retro16/acsi2stm/pcb/Compact/README.md

ACSI2STM PCB
============

Documentation about how to build and use is located in the doc directory.
