retro16/acsi2stm/pcb/Compact/3D view - ACSI2STM Compact.png

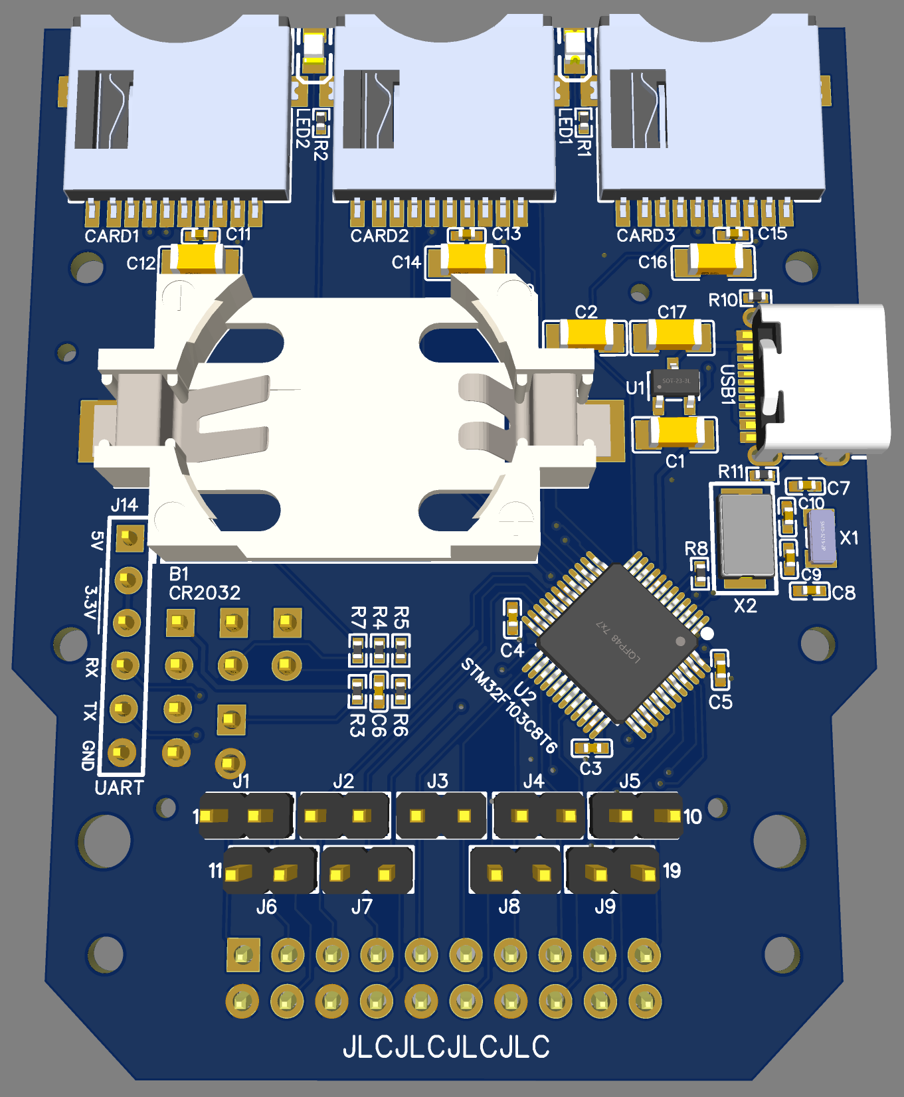
pcb/Compact/3D view - ACSI2STM Compact.png
