retro16/acsi2stm/pcb/Compact/BOM - ACSI2STM Compact.csv

ID | Name | Designator | Footprint | Quantity | Manufacturer Part | Manufacturer | Supplier | Supplier Part | Price
1 | 32.768kHz | X1 | FC-135R_L3.2-W1.5 | 1 | Q13FC1350000400 | EPSON(爱普生) | LCSC | C32346 | 0.204
2 | 100uF | C16,C12,C1,C2,C14,C17 | C1206 | 6 | CL31A107MQHNNNE | SAMSUNG(三星) | LCSC | C15008 | 0.062
3 | 100nF | C15,C11,C6,C3,C4,C13,C5 | C0402 | 7 | CL05B104KO5NNNC | SAMSUNG(三星) | LCSC | C1525 | 0.001
4 | TF-013 | CARD1,CARD2,CARD3 | TF-SMD_TF-013 | 3 | TF-013 | HANBO(汉博) | LCSC | C961683 | 0.091
5 | 22pF | C7,C8,C9,C10 | C0402 | 4 | 0402CG220J500NT | FH(风华) | LCSC | C1555 | 0.001
6 | FC-2012HRK-620D | LED1 | LED0805-RD_RED | 1 | NCD0805R1 | 国星光电 | LCSC | C84256 | 0.011
7 | 17-21SUYC/TR8 | LED2 | LED0805-R-RD | 1 | KT-0805黄灯 | KENTO | LCSC | C2296
8 | CR2032 | B1 | BAT-TH_CR2032-BS-6-1 | 1 | CR2032-BS-6-1 | Q&J | LCSC | C70377 | 0.158
9 | HDR-M-2.54_1x2 | J1,J2,J3,J4,J5,J6,J7,J8,J9 | HDR-M-2.54_1X2 | 9 |  |  | LCSC | C124375 | 0.022
10 | RESET | J10 | HDR-M-2.54_1X2 | 1 |  |  | LCSC | C124375 | 0.022
11 | FLASH | J11 | HDR-M-2.54_1X2 | 1 |  |  | LCSC | C124375 | 0.022
12 | ID_SHIFT | J12 | HDR-M-2.54_1X4 | 1 |  |  | LCSC | C124378 | 0.04
13 | STRICT | J13 | HDR-M-2.54_1X2 | 1 |  |  | LCSC | C124375 | 0.022
14 | UART | J14 | HDR-F-2.54_1X6 | 1 |  |  | LCSC | C40877 | 0.071
15 | HDR-IDC-2.54-2X10P | P1 | IDC-TH_20P-P2.54-V-R2-C10-S2.54 | 1 | 2.54-2*10P简牛 | BOOMELE(博穆精密) | LCSC | C3405 | 0.114
16 | 1kΩ | R1,R2,R4,R5,R7 | R0402 | 5 | 0402WGF1001TCE | UNI-ROYAL(厚声) | LCSC | C11702 | 0.001
17 | 100kΩ | R3,R6,R9 | R0402 | 3 | 0402WGF1003TCE | UNI-ROYAL(厚声) | LCSC | C25741 | 0.001
18 | 1MΩ | R8 | R0402 | 1 | 0402WGF1004TCE | UNI-ROYAL(厚声) | LCSC | C26083 | 0.001
19 | 5.1kΩ | R10,R11 | R0402 | 2 | 0402WGF5101TCE | UNI-ROYAL(厚声) | LCSC | C25905 | 0.001
20 | XC6206P332MR | U1 | SOT-23-3_L2.9-W1.6-P1.90-LS2.8-BR | 1 | XC6206P332MR | TOREX(特瑞仕) | LCSC | C5446 | 0.107
21 | STM32F103C8T6 | U2 | LQFP-48_L7.0-W7.0-P0.50-LS9.0-BL | 1 | STM32F103C8T6 | ST(意法半导体) | null
22 | USB-TYPE-C-018 | USB1 | USB-C_SMD-TYPE-C-31-M-12 | 1 | USB-TYPE-C-018 | DEALON(德艺隆) | LCSC | C2927038 | 0.052
23 | 8MHz | X2 | CRYSTAL-SMD_L5.0-W3.2 | 1 | X50328MSB2GI | YXC(扬兴晶振) | LCSC | C115962 | 0.174
