retro16/acsi2stm/(threads)

Thread 1 (2020-04-05):

Why no DMA?

TzOk83, 2020-04-05:
Great work, but it is really worth to leave Arduino behind, and use a full potential of STM32 with the use of the DMA support it has.

Closed 2021-01-31.

Thread 2 (2021-01-30):

Build issues

MrSVCD, 2021-01-30:
I just downloaded arduino and what i could find of stm32duino, this to be precise: https://github.com/stm32duino/Arduino_Core_STM32, and I can't compile it.
It complains that it can't find libmaple_types so I think I am missing something.
How do I fix this?

retro16, 2021-01-31:
Hi, It seems that the STM32 library changed lately.
Can you try installing the Roger Clark Melbourne version of the STM32 library, it seems to solve the compilation issue.
The steps are available here: https://github.com/rogerclarkmelbourne/Arduino_STM32/wiki/Installation

Closed 2021-04-23.

Thread 3 (2021-02-06):

Device detection fails. Boot fails as well.

grzybsonssg, 2021-02-06:
I am trying to build acsi2stm and I am having hard time.

Symptoms:
* I etched SD card image with ICD Pro from Jookie - it does not boot.
Source: http://atari.8bitchip.info/DiskImgPP1.html
* I etched SD 1GB card image from Pera Putnik - it does not boot.
Source: http://joo.kie.sk/?page_id=332
* I booted from floppy with ICD Pro, then run IDCHECK.PRG - device is detected about once in around 20 tries

Some details:
* On serial output, when booting I can see something like below and nothing happens.
```
-----------------------
ACSI2STM SD bridge v1.1
-----------------------

Initializing ACSI bus ...
ACSI bus ready
Initializing SD card 0
Size: 7388MB - 15130624 blocks
SD card is bootable
1 SD cards found

--- Ready to go ---

Command  8 0 0 0 1 0
Send:512 bytes
Success
```
* This is output when running IDCHECK.PRG. However the device stays undetected.
```

-----------------------
ACSI2STM SD bridge v1.1
-----------------------

Initializing ACSI bus ...
ACSI bus ready
Initializing SD card 0
Cannot init SD card
0 SD cards found

--- Ready to go ---
Initializing SD card 0
Size: 7388MB - 15130624 blocks
Command  3 0 0 0 12 0
Initializing SD card 0
Size: 7388MB - 15130624 blocks
Send: 70 0 0 0 0 0 0 E 0 0 0 0 0 0 0 0 0 0
Success
Command  12 0 0 0 24 0
Initializing SD card 0
Size: 7388MB - 15130624 blocks
SD 0 ID ='ACSI2STM SD 0 7388 MB   v1.1'
Send: 0 0 1 0 1F 0 0 0 41 43 53 49 32 53 54 4D 20 53 44 20 30 20 37 33 38 38 20 4D 42 20 20 20 76 31 2E 31
Success
Command  12 0 0 0 0 80
Initializing SD card 0
Size: 7388MB - 15130624 blocks
SD 0 ID ='ACSI2STM SD 0 7388 MB   v1.1'
Send:
Success
```
* I used some cheap blue pill and micro sd module (with buffered) lines. I suspect that STM32 might be a fake, because of markings. Please look at the F letter on photo, it should be on next line:
https://a.allegroimg.com/s720/118a5c/e51e5c7a499b809e3ae4c8f7aa82/Modul-STM32F103C8T6-Board-STM32-ARM
* Wires are max 7 cm
* I did a little shortcut - instead of connecting 7 unused CS pins (PA3-PA1,PB0-1, PB3-4) to ground, I just removed them from sdCs array - does it pose a problem?
* I tried STM32 Arduino libs from Dan drown (https://github.com/ddrown/Arduino_STM32/)
as well as from Roger Clark (https://github.com/rogerclarkmelbourne/Arduino_STM32)
* I tried two different USB chargers to power the device.
* I have only one micro SD card.
* I have 1040STe, 4MB RAM, TOS 1.62DE, DMA chip C38739-001A (the so-called better one).

I am starting to believe that I have a fake chip. Maybe there are slightly different timings on GPIO and device goes out of sync?

Maybe do you have any ideas what to do next?
Maybe try to get different blue pill?

retro16, 2021-02-07:
Thanks for the very detailed issue, that helps a lot !

First things first, here is a list of things I consider good from what you said:

 * Your electronics are good because many commands were exchanged in the IDCHECK.PRG trace, so there is some form of communication.
 * Altering the sdCs array is a good solution to avoid grounding pins. The code adapts itself automatically to that situation.
 * The DMA chip of the ST is never an issue for reading.
 * My main machine was also a 1040STe with the same configuration (I don't have it right now to test).
 * My STM32 also has the F letter misplaced, so if you have a fake chip, so do I.

Things I'm unsure about:

 * The IDCHECK.PRG trace says "0 SD cards found". The SD card is detected later. It shouldn't be a problem because the card is initialized again for most commands anyway.
 * I heavily recommend the Roger Clark Arduino library, but my code was done a while ago with a different library, and I don't remember which one it was. That may have an impact on the time critical parts (more on that later).

Things I'm pretty sure don't work:

 * Data transfers (DMA) are probably the problem because commands work.
 * The timing-sensitive functions of my code are probably not working on your configuration. That's an issue some other people already had.

That would explain exactly the traces I see and also the detection issue you have.

DMA transfers are too fast to be cleanly implement on the STM32, so I use fixed delays. It worked on all my machines (and it worked for other people too), but it seems to be hit or miss.

Could you try experimenting with the pulseDrqSend function ? The aim is to find the correct number of lines (between line 230 and 236 in the last version) to have the correct DRQ pulse timing. Some had more success by removing 3 or 4 lines, but you may have to add 3 or 4 lines.

The best way to test is to try booting the ST: if you have more than one command on the trace, it means that reading from the SD card is working to some extent.

If you need to test your image, I recommend you test on the Hatari emulator because my code follows its implementation so the behavior should be the same.

retro16, 2021-02-07:
I did some checks on an up to date Roger Clark environment. It seems that the optimization level has an impact. Can you try with Tools/Optimize: Fastest (-O3) ?

grzybsonssg, 2021-02-07:
Hi! I switched the optimization level to: Fastet (O3). Results are at least interesting.

At first - nothing changed. I did some testing and after around 15 minutes of meddling - it booted!
I run some games, even copied some files from floppies. Unfortunately - it worked only for like a 30 minutes. When I turned everything off  to copy some stuff from PC, and then on - it failed to boot again (with messages still logged on serial).

During a day I managed to get it working only once :(

I think I'll try shortening wires a little (now 7cm). I have also borrowed another blue pill from a friend.

grzybsonssg, 2021-02-08:
I have another observation from today!

Just by accident I powered the ACSI2STM from laptops USB (instead of charger). Guess what - it booted! And it booted every time I have tried! But not with phone chargers.....

During tests:
* some games from P.Putniks free image run flawlessly
* We were at demo HDD version crashed randomly during loading (screen turning to blue)
* Flipo demo HDD refused to load.
* Bad apple by fenarinasra crashed stopped at loading screen at random moments.

In following days I'll try to experiment with pulseDrqSend as you suggest.

retro16, 2021-02-09:
That's nice progress, thanks for the feedback !
You probably have some electrical noise issues. Phone chargers often generate more noise than a PC and this kind of noise is difficult to filter. Reducing wire length and adding a decoupling capacitor (a big ceramic cap, something like 10uF) between 5V and GND might help.
pulseDrqSend adjustments may also improve things if the data signal is removed too early by the STM32. In that case, try to add a few lines. It's all guesswork.
Ideally, you would need to probe the DRQ and ACK signals with a logic probe or a digital oscilloscope during a big faulty transfer: the correct signal is DRQ rising right after ACK is pulled low by the ST, the sooner the better. If DRQ goes up before ACK goes down, pulseDrqSend is too fast and it may remove the data byte before the ST read it.

grzybsonssg, 2021-02-10:
Hi,

I looked carefully at the bottom of the blue pill, and there are already to capacitors between 5V and GND - on mine boars labelled C5 and C7. Unfortunately, there is no label on them, parameters are unknown. According to some sources on web those might already be 100n and 10u :/
I wonder how much current the acsi2stm draws...

However I have a major breakthrough :)
* I switched optimization level back to "Smallest"
* Added three lines inside pulseDrqSend
* Disabled all the serial logging (important!)
Right now "Bad apple" runs smoothly from the beginning to end :) There is no sound though.  I might have STE DAC broken or something in-between, because I already experienced it with ProTracker or game "Stardust".

Demo "We were at" is causing problems. It loads and runs until certain point. It crashes before image screen with girl and her hair waving. FDD version loads some additional data at that moment. What's interesting is that Hatari emulator fails as well, but due to some reports - Ultrasatan does not. I'll try to contact Leonard/Oxygene for that.

grzybsonssg, 2021-02-11:
Hi! I heard that someone at atari-forum is trying to exact-cycle Drq pulses using machine code's NOP instructions. What  do you think?

retro16, 2021-04-23:
Hi, If you still have issues, I recommend that you upgrade to the 2.0 beta I just uploaded. Beware that there are minor pinout differences.

Closed 2021-04-23.

Thread 4 (2021-02-16):

Read issues

Frederick321, 2021-02-16:
Have a nice day!

I built an ACSI2STM; on a soldered breadboard, in order to minimize the tracks lenght.

Following your advices from "Device detection fails. Boot fails as well." issue thread; I managed to enabled correct write operation.

But reading sometimes present problems; I detected this loading some hard disk enabled games; once the full coloured splash screen of a game presented several garbage pixel lines.

On a major testing, it appears that large files (greater than 1 MB) can be loaded with more succesful results than load many small files reaching the same amount of data.

It can be something related to disk access time? Or something related to the explanation about "If DRQ goes up before ACK goes down, pulseDrqSend is too fast..."

Machine is a STE with TOS 1.06, and "Good DMA chip"

retro16, 2021-02-23:
Hi, some people (including myself) have timing problems because of a change in behavior in the STM32 library. I am aware of these issues, probably related to the pulseDrq functions. This needs fine tuning, some people already help me finding the correct timing.
That timing issue is there because the STM32 is not fast enough to react to the ACK pulse so it has to do guesswork with a timer,  which introduces these problems if the delay is not perfect. Hopefully this will be solved quickly.
Can you list the name of the games with problems so I can try to reproduce the issue ?

Thank you for your feedback.

retro16, 2021-04-23:
Hi, If you still have issues, I recommend that you upgrade to the 2.0 beta I just uploaded. Beware that there are minor pinout differences.

Closed 2021-04-23.

Thread 5 (2021-02-17):

High current draw

TzOk83, 2021-02-17:
I've encountered a problem - after shorting unused CS pins to GND the MCU overheats. I've checked, and PA1..4 and PB0..1 seem to be configured as output and set high, so shorting them to GND results in excessive current draw (50mA per pin).

retro16, 2021-02-23:
Thanks for the feedback.
I reviewed my code and your result is a bit strange. Based on my code, these pins should stay in the INPUT_PULLUP state.
In the meantime, you can remove the pins you don't use from the sdCs array in the code and leave them open.

retro16, 2021-04-23:
Hi, If you still have issues, I recommend that you upgrade to the 2.0 beta I just uploaded. Beware that there are minor pinout differences. Now, unused CS pins are not grounded anymore, which should solve your issue.

Closed 2021-04-23.

Thread 6 (2021-03-25):

Debug Printout?

Ulises74, 2021-03-25:
Hi @retro16,
First of all, GREAT JOB! UFF WAO, I am getting my feet wet and I am overwhelmed.
Can you post a debug printout of a successful SD card install?
In my case ICD ID detect and ICD Install fail to recognize anything in the bus. I realized ICD was sending a VERIFY(6), to which I modified the code to respond with a command Success. The ACSI2STM was recognized as ADAPTEC 5500, but would fail to install: "Unable to determine drive size". In the debug, I realized a command Test Drive Ready is sent with 0x20 in the 2nd byte, to which the program errors out. I am about to add a correction to this, but I believe I might be going down a rabbit hole.
Can you post a successful DEBUG session.
What is it recognized as by ICD?
Thanks
TOS 1.06 1040STE
ICD Install v1.13

Ulises74, 2021-04-02:
Hi, I finally made it work! I'd like to share my experience here in case it helps anyone else. Trying to keep it short.
Things I learned:
1- This works, no need to mess with the software, except the pulses.
2- Pick a good strategy for assembly.
3- Triple check connections.
4- Run various tests, have patience.
What I recommend:
1- Do not use lead free solder, just use normal lead solder - lower temp, smaller blobs, easier.
2- Do not use protoboard, go straight for pcb prototypying, too many connections can go loose.
3- 8 bit lines plus 4 control lines, 12 total. Each point of solder multiplies, I had 4 stages, 12x4=48, plus SD, etc, you get the point.
4- triple check connections between points. I checked connections, then cleaned the flux with a toothbrush, which moved a wire without me noticing= 1 week lost.
5- Use a good known power supply, add a capacitor to your board at power entry, 10 or more uF. Tantalum or SMD's are better than electrolytics, but the latter will work as well.
6- There is a typo on the STM Serial port to be used. PA9 is to be connected to the USB Serial bridge RX port (not PA11 as in the original instructions). PA10 is correct.
Tips:
Whether the ACSI2SD works or not depends on the timings for read and write in the DMA port. These are affected by the number of pulses in the pulseDrqSend and pulseDrqRead functions as well as the compile options.
Sequence-
1-Pick a compile option (default, O1, O2, O3)
2- change the pulses in the pulseDrqSend. Start by going down; but you could go up as well. Stick with one.
3- check that device is "read". ICD IDcheck will check device names by performing a read in the DMA.  Name should be 'ACSI2STM SD 0 1938 MB   v1.1' for example. You can reprogram the device while IDCheck is waiting for input.
2- If not read, change pulse durations. If sometimes it reads, and sometimes it doesn't or shows garbage, you still need to change pulse duration, but probably by one or two pulses.
3- If Pulse durations don't make the device be read, then change the Optimization. and repeat from step 1.
4 - Once you have stable detection of IDCheck you can start with format ICDFMT.
5- Go over the Format, then Partition. This reads data from the disk and writes data to the disk, but it does not confirm that data was written correctly. At this point you can start the calibration process with the pulseDrqRead; same steps as before, except this time, you will use the formatting/partitioning sequence.
6- You will have calibrated the pulseDrqRead function correctly, if when ICDFMT exits, it reboots the computer. ICDFMT during the partitioning process, will make the drive bootable and install a driver. So when it exits, it will try to read this back and reboot. If it doesn't reboot, it didn't work. If it reboots, you might just be near the sweet spot. If the ST booted to your C drive on screen, try creating folders and copying files, try reading/executing them. If you encounter errors, keep tweaking the pulses until you no errors are seen.
7- At this point you should have a working drive.

Notes:
- The watchdog timer lets you know something is wrong. If in the debug screen you see the welcome screen popping up a lot, means you have problems. At first, I had a lot of them going on. They went away when I added the power supply capacitor. Then I had some left during read/writes because I had changed the read/write subroutines. It meant, the sequencing wasn't done correctly and the STM was left waiting and after a while the watchdog timer rebooted the STM.
- I also noticed that seems like the DMA chip can tell if the hardware handshake is way out/not done in sequence, only for DMA writes to the drive. It will display "write error" during the partition creation or if you do a surface scan.
- Leaving the Debug on was crucial for me to learn/understand but you may not needed it if the above steps work. If you can tell that commands are received, you know that the soldering worked. Also, having the debug on did not interfere with the drive working, it just increased the access time by a bit. Remember to turn it off when done.
- Once the drive is working, you might be tempted to keep reducing the pulses. Each pulse is about 30ms. In my case, there was a point in which reducing the pulses just created errors. I believe you should do this in order to find the lower limit, and then leave the number of pulses in between the lower and the higher limit. I suspect temperature might affect DMA pulsing.
- Compiling option that worked for me: Fast-O1
- My final numbers: 363KB/s, 2ms. Faster than an original Atari drive, not bad! (on ICDpro RateHd)
- I used a "quality" blue pill ($7), like the one in Retro16 pics. I will try on cheap blue pills ($2).

ToDo:
- I like it, I think I'll make a PCB, I have 2 Atari's, and it would suck to proto build these.
- I suspect the STM Roger Clark library is creating bloated assembly - SD runs at 25MHz so we should get faster speeds. In fact, I did away with the while(!ACK) wait in the pulse functions and it doesn't change the speed or the functioning. So I might dive into that - add inline assembly for port writing and reading.
- Enjoy it. I need to find ways to use the drive for gaming or programming or whatever.

Thanks Retro16!

Some Debug printouts:

-----------------------
ACSI2STM SD bridge v1.1
-----------------------

Initializing ACSI bus ...
ACSI bus ready
Initializing SD card 0
Size: 1938MB - 3970048 blocks
1 SD cards found

--- Ready to go ---
ICD recognized and showed device
IDCHECK
Command  3 0 0 0 12 0
Initializing SD card 0
Size: 1938MB - 3970048 blocks
Send: 70 0 0 0 0 0 0 E 0 0 0 0 0 0 0 0 0 0
Success
Command  12 0 0 0 24 0
Initializing SD card 0
Size: 1938MB - 3970048 blocks
SD 0 ID ='ACSI2STM SD 0 1938 MB   v1.1'
Send: 0 0 1 0 1F 0 0 0 41 43 53 49 32 53 54 4D 20 53 44 20 30 20 31 39 33 38 20 4D 42 20 20 20 76 31 2E 31
Success
ID Shown!

ICDFMT

Command  12 0 0 0 24 0
Initializing SD card 0
Size: 1938MB - 3970048 blocks
SD 0 ID ='ACSI2STM SD 0 1938 MB   v1.1'
Send: 0 0 1 0 1F 0 0 0 41 43 53 49 32 53 54 4D 20 53 44 20 30 20 31 39 33 38 20 4D 42 20 20 20 76 31 2E 31
Success
Command  0 0 0 0 0 0
Initializing SD card 0
Size: 1938MB - 3970048 blocks
Success

Detected!

retro16, 2021-04-23:
Hi, If you still have issues, I recommend that you upgrade to the 2.0 beta I just uploaded. Beware that there are minor pinout differences. It should solve any timing issues as it now uses STM32 timers and DMA for much safer operation.
Thank you for the very detailed feedback that helped me a lot finalizing this v2.0.

Closed 2021-04-23.

Thread 7 (2021-05-07):

Unstable work on unbuffered ACSI port (e.g. STf).

TzOk83, 2021-05-07:
I can't get it to work on Atari STfm, on STe it works flawlessly and very fast (~1MB/s). I think it can be caused, by the fact, that STf doesn't have any buffers between DMA chip and ACSI port, while STe - has. If I load the driver from the disk, I can browse the card on the STf, but writing to it, corrupts it completely. I'm using P. Putnik's driver.

P.S.
For some reason, if I upload the program to the BluePill from Arduino IDE via the STLink, it doesn't work (but reacts on ACSI activity), while when I upload it via the Serial it works. It also works if I export the binary file from Arduino IDE and upload it to the BluePill via the STLink, with the STM32 Cube.

retro16, 2021-05-08:
Thansk for the detailled feedback.

I usually work on a STE, but testing on a 520STF shows indeed signs of data corruption. Strangely, it's not 100% corrupt, its mostly right: I could copy a PRG, reset, and run it successfully, but the file system quickly degrades (I'm using ICD). In my case that probably could be worked around using a driver that does verify and retries.

The electrical compatibility issue is a serious lead, I wasn't aware of these hardware differences. Having an oscilloscope of D0 and ACK during a write operation would help. I'm working on soomething else right now but I'll try doing it in a near future.

I have STLink issues too. STLink issues may be because of direct port access for GPIO or systick disabling (not sure). I do push the STM to its limits with that version. I don't really care, I use serial anyway.

retro16, 2021-05-08:
Just an idea that came across my mind: maybe the DMA data lines are slow on the STfm, so I did a testing branch "dmadelay" that delays sampling. I doubt it changes anything, but if you could test it, that would be appreciated.

By the way, there are known issues on some STf with writing, and it seems that these aren't able to write anything tio their DMA/ACSI port. Do you have any way to check that there are actually some signals on D0-D7 during a write operation ? (oscilloscope, logic analyzer ...)

TzOk83, 2021-05-08:
I can check signals on the bus, but UltraSatan works fine, on that machine.

retro16, 2021-05-08:
Ok if UltraSatan works, no need to check the signals, the issue is on the STM side. I was able to reproduce anyway, and it seems my "dmadelay" branch improves things a bit. I might make a DMA test application some day ...

TzOk83, 2021-05-14:
I have tried today and still no luck  with the autoboot, yet writes now work correctly.

I have tried on the same SD card and same ACSI cable as my UltraSatan.

I can copy many MBs of data and everything works stable. The dmadelay version is actually slightly... faster than the current release version (1010 vs 990 kB/s).

mamejay, 2021-09-29:
I have built a unit up and programmed using a STLink and get the same issue as TzOk83.  I get activity LED on the STM but will not detect the card.  My serial adapters have decided they do not want to work.  I have another on order.  Hope this works as I have checked all connection and everything is connected correctly.

VonHirsch, 2021-10-04:
Hello, i'm getting ready to build a unit and came across this thread.  I'd like to use it on a 520STF.  Is it possible that this issue is related to the ["DMA" issue](https://www.exxoshost.co.uk/atari/last/DMAfix/)?

retro16, 2021-10-05:
Things have changed a lot since v2.1. I'm now pretty confident that commands aren't skipped anymore, but reality proves that there are still issues for some people that I can't reproduce.
If issues still arise, traces of the following signals during a failed write operation would be greatly appreciated (a few periods should be enough):

* DRQ (ACSI pin 19)
* ACK (ACSI pin 14)
* D0 (ACSI pin 1)

And another trace with the following pins captured during a write command (one A1 pulse and a few CS/IRQ pulses is enough):

* IRQ (ACSI pin 10)
* CS (ACSI pin 9)
* A1 (ACSI pin 16)

Pins are listed in order of importance, if your oscilloscope/logic analyzer doesn't have enough inputs, just take the top of the list.

luciust, 2021-10-05:
Well I got Two STF and and 4 STEs.
The <2.1 version was corrupting data but working on STE with older DMA. The 2.1 doesn't - Putnik or ICD - they can't even read the filesystem. STE has pullups on DMA bus.

I need to check on STFs and one STE with newer (001) DMA I got. One of them (strangely not the one with 001 DMA) works fine with CosmosEX and the STF works with aftermarket SCSI - ACSI HDD from the era.

So - need to test and get back here! Got a scope and logic analyzer at disposal

luciust, 2021-10-06:
OK, So far:
- STE, old DMA, pullups, TOS 2.06 - no go
- STE, new DMA, no pullups, TOS 1.62 - no go
- STF, old DMA, pullups, TOS 1.04 - no go

The effect is the same - Putnik's partiition program takes  2 mins to find the "HDD" and either shows 0MB or 128MB.

Double checking the connections and the plan is to attach console and turn on debug.

TzOk83, 2022-01-01:
I may confirm the same - v2.1 doesn't work for me at all. On my STE v2.0, and v2.0 "dmadelay" were working, including autoboot feature (but only on STE).

Are you aware of the fact, that the Data Request (19) signal timing given in the official documentation is apparently wrong?

retro16, 2022-03-01:
Version 2.2 leaves data on the bus after the ACK rises for a small amount of time. The ACSI doc specifies a minimum of 20ns so I removed code inlining and added a single NOP to make sure that this requirement is exceeded. This is very similar to what "dmadelay" did but in a cleaner way.

ACSI_FAST_DMA define restores the faster inline code of version 2.1 if set to 1.

Now, trying different combinations of ACSI_ACK_FILTER, ACSI_CS_FILTER and ACSI_FAST_DMA should allow adjusting to any reasonable delay required by different versions of the DMA chip. As a general rule of thumb, slower should mean more compatible.

z80micro-mc, 2022-03-09:
I am in the process of building an ACSI2STM for my STs 520STM & 520STFM and have observed that most of the designs would appear to use an Arduino micro SD adapter.  As far as I can ascertain the vast majority of these are designed for 5V TTL operation and include both 5->3v3 regulators and 3v <-> 5V buffers.  The ACSI design would appear to use the TTL compatible interfaces on the ACSI side However, the micro SD side pins are not TTL compatible.  Ihave not not seen articles on removing the 5v-> 3v3 regulator and feeding in 3v3  from the STM nor of removing the LVC125 level converters and ffeding directly into th eSTM from the SD card. Could this be adding to the corruption?

Peter

retro16, 2022-03-20:
@z80micro-mc you probably found a very important issue. My prototype uses microSD->SD converters as SD slots, so no electronics (except a 100nF SMD decoupling capacitor, very important). I previously had issues, but simply because the converter was faulty (these things tend to wear). Soldering a new converter, I have no issue at all.
I can push any card (from old no-name 2GB to brand new SanDisk) to 36MHz on a hand-soldered prototype with 3cm wires and header pins. With the newer, much more stable, version 2.3c I just released, compatibility issues will probably be a thing of the past.

TzOk83, 2022-03-21:
2.31 still doesn't want to autoboot on my STfm (TOS 1.04), while it works fine with my STe (TOS 2.06 and 1.62).

retro16, 2022-03-21:
Thanks @TzOk83  for the quick feedback, it really helps.

Can you try with the following settings in acsi2stm.h ?

#define ACSI_ACK_FILTER 2
#define ACSI_CS_FILTER 2
#define ACSI_FAST_DMA 0

ACSI_FAST_DMA 0 brings back the workaround of the old dmadelay branch. Combined with ACK_FILTER to the maximum, this will add a lot of delay to the DMA transfer, which should help mitigating the lack of buffers and the fact that the STM32 outputs 3.3V instead of 5V. I am probably missing an important detail, but without a problematic machine at hand, it's difficult to pinpoint the issue.

If nothing works, it probably would require driving the bus with pull-ups and tristate to reach 5V on data signals, which changes the logic a lot and will make transfers super slow. Not sure if it's worth it.

TzOk83, 2022-03-22:
I think this may be important - the "dummy bootsector" message shows on the STfm, despite it has an autoboot enabled SD card. If I load ICD driver from the floppy disk it works.

retro16, 2022-03-22:
Super cool, thanks a lot for your help and your patience for helping solving this issue. It's strange that you had the dummy bootsector message working but not ICD. Maybe it's because of the size of the binary.

Anyway, I will set ACSI_ACK_FILTER to 2 by default from now on, the aim is to have a conservative "official" image that trades more compatibility for less speed, and the performance loss of ACK_FILTER to 2 is really minimal. It introduces a lag of about 40ns per byte, which matches more or less what is described in the page you linked a while ago.

Feel free to mark the issue as closed if it is stable for you.

luciust, 2022-03-22:
Wow, so I can get back to soldering! Great news, thanks!

Closed 2022-03-22.

Thread 8 (2021-05-08):

Similar project, share code around image file usage?

mzryz, 2021-05-08:
Hi there,

Sorry if this is a silly question! But there is a SCSI>SD project called BlueSCSI also based on the STM32. Due to the similarities I was thinking this project may benefit from some of their code? For instance, they also support image files but they don't advertise any kind of slowdown in using them. I wonder where the difference is. I guess with the beauty of open source you guys might be interested?

https://github.com/erichelgeson/BlueSCSI

Thanks,

retro16, 2021-05-08:
Hi, this is very good information, thanks for the pointer.
I quickly looked at their code and they only use images and the exact same library, not raw SD card access, the performance they have is somewhat similar to my project when I use images. I bet that they would actually benefit from raw SD card access.

mzryz, 2021-05-08:
Ohhh okay, in that case I might let them know this. (I am a user of both asci2stm & bluescsi) I was just very interested in how both these projects are quite similar.

I will be modifying my asci2stm to v2 tonight and trying the new firmware ;)

erichelgeson, 2021-05-14:
Sorry to come to this late - but i see you're using shared SPI - have you tried dedicated? quite the speed bump if your project can support it.

Closed 2021-05-08.

Thread 9 (2021-05-09):

Advice on re-working to v2?

mzryz, 2021-05-09:
Hi there,

I have a couple of ASCI2STM's that masteries kindly made for me a while back, recently there has been an update to the device that requires some re-working. I haven't done much with SD cards and STM's so the instructions confuse me a little so I'm hoping to get some advice.

 So I can break the traces and patch these quite easily:
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
 Then the SD card info confuses me a lot, could someone help draw on my picture some of the changes I might need?
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

retro16, 2021-05-09:
Hi,
I confirm that the changes on the first picture are correct.
For the SD card, many STM32 pins had to be shorted to GND and now they must be disconnected.

* No change need to be made on the MicroSD adapter
* Since you have only one SD card, pins PA3, PA2, PA1, PB0, PB1 and PB3 of the STM32 are probably connected to GND (I can't see, the traces are either under the STM32 or under the black goo blob). The simplest way is to cut the pins directly on the STM32 itself as they are now completely unused.

mzryz, 2021-09-29:
Just closing the thread as I buggered it all up and my boards went in the bin.

Closed 2021-09-29.

Thread 11 (2021-09-01):

cardSize() is deprecated.

TzOk83, 2021-09-01:
cardSize() method was deprecated in SdFat since few releases, and now it has been finally removed. sectorCount() should be used instead.

The last version of SdFat library compatible with the current code is 2.0.7.

retro16, 2022-03-01:
After a way too long delay, it was changed in the latest release. Closing the issue.
Thanks for the feedback.

Closed 2022-03-01.

Thread 12 (2021-09-30):

Receive bomb images on 8bitchip 1GB image

mamejay, 2021-09-30:
Hello.  I have build a unit and managed to get it visible to the system.  I have tested a ICD unity image and another EMUTOS image and both auto boot fine.
I have a stock 1040 STFM with 1.04 TOS
I am trying to using https://atari.8bitchip.info/DiskImgPP1.html image which seems to be the go to for many people.
I just receive bomb icons on screen after a few seconds of switching on.
If I boot using the EMUTOS sdcard and have the 8bitchip image in sdcard slot 2 I can see all the partitions and run games etc.
What could be the reason that I cannot auto boot with this image?

mamejay, 2021-10-01:
Contacted the dev of the image file and found that it was an older image.  Dev provided me a new image that works perfectly.    Closing issue

Closed 2021-10-01.

Thread 13 (2021-10-04):

Wiring Diagram or Schematic?

VonHirsch, 2021-10-04:
Hello, is there a wiring diagram or schematic available for the build?  If not that's fine, I think I can figure out what goes where based on the descriptions, just wondering as it would be helpful.  Thanks for making this possible.

retro16, 2021-10-05:
Hello, there is currently no schematic for the build. Building the unit is essentially connecting pins described in the pinout tables of the "Building the ACSI cable" and "Connecting the SD cards" sections of the README and providing 5V to the STM32.

I believe that a schematic would look like a mess of confusing wires but if anyone feels otherwise and posts a schematic here I'll be happy to reference it in the official documentation with proper credits.

mlorenzati, 2021-11-30:
I can create a with the schematic, the PCB has I made has no sense since is for prototype pcb
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

retro16, 2022-06-28:
Version 3.00 now comes with an official schematic, PCB and Gerber. Thanks @mlorenzati as your schematic style helped me choose the clearest style for a schematic (mostly labels, just like what you did here). Closing this issue.

Closed 2022-06-28.

Thread 14 (2021-11-03):

External LED PC13?

mamejay, 2021-11-03:
I have made up a board and connected a LED to PC13.
It is working but I find that it is on all the time and then flashes during disk activity.
I am using a regular blue pill board.  Looks like its inverted with the activity light on the Blue Pill.  I suspect its something simple.
Thanks

retro16, 2021-11-03:
Hi,
The internal LED of the blue pill is inverted, so you will have to do the same.
To connect your external LED, connect the anode to VCC and the cathode to PC13. Don't forget to add a resistor in series (at least 1k because the STM32 can't output much current).

mamejay, 2021-11-03:
Thanks for that.  I worked it out.  Unfortunately I made up a few PCB's so no clean way to fix this.  Anyway lesson learnt - always prototype your boards.

retro16, 2021-11-03:
You can still pretend it's a combined power+activity LED to turn it into a feature ;-)
Wish you the best with your project
I'm closing the issue if you don't mind.

Closed 2021-11-03.

Thread 15 (2021-11-12):

CH32F103 - Anyone managed to get this working on this board?

mamejay, 2021-11-12:
I was sent CH32F103 boards instead of blue pills.
They program up the same but I cannot get them to work.  My ST just boots straight to the OS very fast but does not load from my SDCard.
Has anyone managed to get these working?

juancrix, 2021-11-15:
I received some boards with the same CH32F103. To program them I used their app (WCHISPTool) and the lower USB plug of the board. At least they worked with the old firmware with my v1 custom pcb.
I haven't been able to test the CH32F103 with the lastest firmware and my v2 custom pcb, because I have not been abble to get an error free compilation, probably due to problems with my PC; if you don´t mind to share your compilation, I can test it with my configuration.

mamejay, 2021-11-15:
[acsi2stm.ino.generic_stm32f103c_WORKING.bin.zip](https://github.com/retro16/acsi2stm/files/7535527/acsi2stm.ino.generic_stm32f103c_WORKING.bin.zip)
Thanks for the comment.  Attached is my working compile that I made that works on original STM32F103C boards.  Let me know how you go.  Thanks!

juancrix, 2021-11-16:
My result with the CH32F103: it goes straight (and very fast too) to the desktop showing no icons (neither drive A nor drive B, nor trash icon). Just to confirm, can you tell me for how many sd cards is your compilation? and if there is any changes to the base firmware?

mamejay, 2021-11-16:
@juancrix I only use a single SDcard which I created from an image I got from patari.
I get the exact same results where is loads into the desktop fast.
As for the firmware no changes have been made at all.  Just compiled and uploaded to the CH32F103

luciust, 2022-04-03:
@mamejay Which version is your compile based on? It seems to work on my STM32 (supposedly an original) but it mostly discovers as 7xADAPTEC... can you share your compiled binary of 2.40? The released/compiled versions do not seem to even start on my STM32 chip :(

mamejay, 2022-04-03:
> @mamejay Which version is your compile based on? It seems to work on my STM32 (supposedly an original) but it mostly discovers as 7xADAPTEC... can you share your compiled binary of 2.40? The released/compiled versions do not seem to even start on my STM32 chip :(

@luciust I only have the older compiled bin file 2.1 file.  I need to try 2.4 out and see if I can get these many many clones I have here collecting dust.  Here is 2.1 which works on my real Bluepills.
[acsi2stm.ino.generic_stm32f103c_WORKING.bin.zip](https://github.com/retro16/acsi2stm/files/8405631/acsi2stm.ino.generic_stm32f103c_WORKING.bin.zip)

luciust, 2022-04-03:
@mamejay - Yup this is the one which shows up as 5 devices and ADAPTEC with mine. But at least it starts on mine. Well need to desolder two other bluepils and try again on fresh PCB...

retro16, 2022-04-04:
Hi, if any of you can manage to make 2.40 at least boot on CH32 or other clones, I would be very interested in your setup details to investigate why the release binary doesn't work on these.
Also, I wanted to suggest acsitest.tos (found in the release zip package, *tos* subfolder) that can help diagnosing 2.40 boards, in combination with your usual tools. In ACSI_DEBUG/ACSI_VERBOSE modes, the STM32 even outputs faulty bytes for DMA transfers. I might recognize some patterns I saw when doing DMA improvements/fixes for 2.3/2.4.

luciust, 2022-04-04:
@retro16
I'm pretty sure I got a clone, since my second blue pill is from better source and has correct markings. I'm about to solder the gerber that has been forked from your repo - I hope the pin changes on 2.40 are not making this a problem.

Also dealing with issue that only -O2 option allows the 2.4 to compile, any other setting results with error. Latest STM32, Arduino 1.8.15 - on Linux... But that's another topic :)

mamejay, 2022-04-04:
@retro16 I tried many times to use the new code with a CH32 board but still get the desktop loading instantly.  WIth the ACSITEST.TOS is this a TOS replacement that needs to be burnt to an eprom?

@luciust here is the 2.40 bin file that I managed to compile and get working on my "real" bluepill.  See if this is better than the last binary I sent
[acsi2stm.ino.generic_stm32f103c_2.40_WORKING.bin.zip](https://github.com/retro16/acsi2stm/files/8409128/acsi2stm.ino.generic_stm32f103c_2.40_WORKING.bin.zip)

retro16, 2022-04-04:
@mamejay ACSITEST.TOS is an Atari ST program. Just run it from the GEM desktop. You can load it by any method (working acsi2stm, floppy, ultrasatan, ...) it will work the same.
The program supports hot plugging fine, so you can load it using one ACSI device, unplug it and plug the device to test. You can test multiple devices in a row or reflash your acsi2stm firmware and try again by leaving the program running on the ST.
I don't guarantee that you can quit back to GEM cleanly if hot swapping, but who cares ...

luciust, 2022-04-04:
@mamejay Great, will test it with old one and hopefully finish solderiing new one.

luciust, 2022-04-04:
@mamejay - So, no joy, the 2,40 from you also doesn't start on the clone. No green LED, no activity. Also I I compile debug version with serial - not even serial activity.

Soldering the other board then!

retro16, 2023-06-04:
If anyone has success with 4.00 on a CH32 or any other clone, please drop a line !
Thank you for your help, you people really rock.

mamejay, 2023-06-04:
> If anyone has success with 4.00 on a CH32 or any other clone, please drop a line ! Thank you for your help, you people really rock.

I have heaps of them still.  They need to be programmed a strange way so I will see if I can actually get the  code onto one and use my ZIF socket test rig

mamejay, 2023-06-04:
Tried acsi2stm-4.00.ino.bin and also acsi2stm-4.00-strict.ino.bin get the following as soon as I switch on the ST.
Information just flashes vertically down the screen.
If there is anything else you want me to try let me know.
Thanks

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

retro16, 2023-06-12:
Okay, this doesn't look very good. Let's say that these clones are officially not supported.
Leaving the issue opened for reference as it contains useful information. If I ever update the documentation, I may integrate that thread in the troubleshooting section and close this issue.

Thread 16 (2021-12-06):

SPI Bus is too fast

mlorenzati, 2021-12-06:
After checking the proyect I saw random behaviors in the SPI bus, like failing to start the **SdSpiCard** or detecting 0MB of free space.

After toying with the solution, I tested to lower the SPI to 18Mhz and delay a bit prior init.

```
if(!card.begin(SdSpiConfig(csPin, SHARED_SPI, SD_SCK_MHZ(18), &SPI))) {
    resetState();
    return false;
  }
  delay(250);
  blocks = card.cardSize();```

Now it always boot the sd and detects a boot image on it.
Now dealing with a bus collision that stops the stm32

retro16, 2021-12-07:
Thanks a lot for the feedback. I had strange issues too and got around by doing retries, which was obviously the wrong way.
I will set 18MHz by default and add a #define for adventurous people who want 25MHz back.

I'm rather busy on other projects lately so it might take a while to do that as my Atari is not set up anymore.

retro16, 2022-02-27:
Thanks a lot @grzybsonssg for the feedback. If that works for you too and it's stable, please give some feedback and I'll just commit @mlorenzati 's solution and do a new incremental release.

retro16, 2022-03-01:
The patch here looks good so I integrated it in my latest release with a #define for people who want the highest speed possible. Thank you all for the feedback.

Closed 2022-03-01.

Thread 17 (2021-12-07):

Bus arbitration error on ST power up

mlorenzati, 2021-12-07:
I was able to separately test the board, it reads properly the SD card as a boot device and waits for ACSI bus.
But If I connect the device to the db19, if I power the ST, the green led goes down and the USB serial connection is lost with the pc.

Which lines might be colliding?
this is my schematic, which honors the same documentation

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

retro16, 2021-12-07:
Hi Marcelo,

I just had a very quick look at your schematic, it looks very good overall (I trust your pin assignments, I'm sorry I don't have time to double check connections right now, and I'm pretty sure that you double-checked these already).
The only issue I can think of is the USB data lines on PA11/PA12. If you power the STM32 with its onboard USB plug, make sure to use a cable that is not connected to the data lines.

Having the LED turning off after detecting the ACSI bus is good sign, the LED turns on while waiting for the bus, then turns into an activity LED when entering the main loop.

Of course losing the serial connection is not good at all. What happens if you reset the STM32 with the ST already powered on ?

mlorenzati, 2021-12-07:
Oh so you mean that the USB connection is only meant for powering the device?
What about the COM port? When I debug is using the serial through USB, which serial should be configured?

retro16, 2021-12-08:
I'm surprised that you even have a COM port to begin with. This project is designed to work with USART1 (PA9+PA10) connected to an external UART-USB converter. Can you check if you have a compilation setting that sets the behavior of Serial (I don't remember it that well and my Arduino setup is not reachable right now): it should be set to use hardware serial and mapped to USART1.
It is not possible to use the internal USB port at all because the code requires the TIM1_ETR pin for its very specific behavior that cannot be remapped anywhere else.

mlorenzati, 2021-12-08:
I'll check why is setting the USB2Serial port, but I can assure you that it was wrongly configuring that and was able to see the Serial output through there.
I think is related to use the maple mini interface

mlorenzati, 2021-12-08:
Now that I program it through serial I can see the logs that detects the disc as a boot device, and acsi says ready, but the machine does not starts the disk
```
-----------------------
ACSI2STM SD bridge v2.1
-----------------------

SD0:ACSI2STM SD0   30 GB F BOOT
1 SD cards found
Waiting for the ACSI bus

--- Ready to go ---

```

mlorenzati, 2021-12-08:
This is the DMA dump of sector 0 with commands 8(read) and 0(unit ready)
http://fr.meric.free.fr/Technique/Hardware/memoires%20de%20masse/ACSI_DMA_Guide_6-28-1991.pdf
It appears to be ok, but no clue why it does not continue
```
[+8]SD0 cmd 8 [<0][<0][<0][<1][<0](6 bytes)
Read 1 blocks from 0
DMA send (512 bytes): 60 1E 0 0 0 0 0 0 50 54 0 0 0 0 0 0 0 0 0 0 0 0 0 0 0 0 0 0 0 0 0 0 48 79 0 B FF FF 4E 4D 58 8F 8 0 0 3 67 24 42 78 4 46 2F 3C 0 E 0 0 4E 41 58 8F 31 FC 0 88 86 6 21 FC 0 0 0 88 86 4 31 FC 0 8A 86 6 4E 75 20 78 4 76 C A8 50 50 48 44 FF F8 67 CE 2F 7 48 79 0 0 BB 80 3F 3C 0 48 4E 41 5C 8F 20 40 D1 FC 0 0 80 E4 72 2 74 A 7C 0 4D F8 86 6 4B F8 86 4 50 F8 4 3E 48 50 11 EF 0 3 86 D 11 EF 0 2 86 B 11 EF 0 1 86 9 58 8F 3C BC 1 98 3C BC 0 98 3A 82 3C BC 0 88 30 3C 0 8 80 6 48 40 30 3C 0 88 61 0 0 72 66 0 0 8A 20 1 30 3C 0 8A 61 0 0 64 66 0 0 7C 20 1 E0 48 48 40 30 3C 0 8A 61 0 0 52 66 0 0 6A 20 1 48 40 30 3C 0 8A 61 0 0 42 66 0 0 5A 20 2 48 40 30 3C 0 8A 61 0 0 32 66 4A 2A BC 0 0 0 A 38 3C 1 90 61 0 0 26 66 3A 3C BC 0 8A 30 15 2 40 0 FF 66 0 0 2E 3C BC 0 80 51 F8 4 3E 3F 6 4E 90 3C 1F 60 32 2A 80 78 A D8 78 4 BC 8 39 0 5 FF FF FA 1 67 8 B8 78 4 BC 66 F0 78 FF 4E 75 3C BC 0 80 BC 3C 0 E0 67 8 6 6 0 20 60 0 FF 24 51 F8 4 3E 2E 1F 4E 75 2F 0 0 0 0 0 0 0 0 0 0 0 0 0 0 0 0 0 0 0 0 0 0 0 0 0 0 0 0 0 0 0 0 0 0 0 0 0 0 0 0 0 0 0 0 0 0 0 0 0 0 0 0 0 0 0 0 0 0 0 0 0 0 0 0 0 0 0 0 0 0 0 0 0 0 0 0 0 0 0 0 0 C4 F3 63 FA B6 65 0 1 1 0 6 93 36 1D 3F 0 0 0 0 40 7 0 0 94 36 1D F 40 66 CB 7E 40 7 0 7A 41 34 0 0 0 0 0 0 0 0 0 0 0 0 0 0 0 0 0 0 0 0 0 0 0 0 0 0 0 0 0 0 0 0 0 55 AA OK
Success
[>0][+0]SD0 cmd 0 [<0][<0][<0][<1][<0](6 bytes)
Success
[>0][+0]SD0 cmd 0 [<0][<0][<0][<1][<0](6 bytes)
Success
[>0]
```

mlorenzati, 2021-12-15:
Does the sequence looks ok? I heard that the issues with the current 2.0 approach are related to TIMER1/TIMER4 on the available STM32F103C8 on the bluepills on the market, which produces ACSI reading errors on the STM.

retro16, 2021-12-15:
Hi, sorry for the long delay.
This log looks okay. It's strange that you have 2 cmd 0 after that, though it might be because of an error.
It's likely that there is some data corruption somewhere in DMA transfers, there are a lot of possible causes (that can be ST issues, STM32 hardware issues, a bug in the STM32 code, connection issues, ...). Without signal traces it's difficult to conclude.

Can you try changing ACSI_ACK_FILTER in acsi2stm.h between 0, 1 and 2 ?

mlorenzati, 2021-12-15:
I will and return to you asap :)

mlorenzati, 2021-12-15:
with ACSI_ACK_FILTER in 0, I just see
``` [+0]SD0 cmd 0 [<0][<0][<0][<1][<0](6 bytes)
Success
[>0]```

with ACSI_ACK_FILTER in 1, I see
```[+8]SD0 cmd 8 [<0][<0][<0][<1][<0](6 bytes)
Read 1 blocks from 0
DMA send (512 bytes) OK
Success
[>0]```

with ACSI_ACK_FILTER in  2 I see
``` [+8]SD0 cmd 8 [<0][<0][<0][<1][<0](6 bytes)
Read 1 blocks from 0
DMA send (512 bytes) OK
Success
[>0][+0]SD0 cmd 0 [<0][<0][<0][<1][<0](6 bytes)
Success
[>0]```

But it's also dependent of SPI speed for SD, best results have been seen with ACSI_ACK_FILTER in 1

mlorenzati, 2021-12-15:
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
I tested with a AHPT94, and it properly transfers (280-310KB/s) with 9.8mS access time
But I cannot boot with the device, can it be the TOS version? I have 1.02

mlorenzati, 2021-12-15:
This are the logs with AHPT94, I think they look ok, no error is reported in the app, but the level of test is just Direct HW access, could it be the TOS of the ST520?
```
[+0]SD0 cmd 0 [<0][<0][<0][<0][<0](6 bytes)
Success
[>0][+0]SD0 cmd 0 [<0][<0][<0][<38][<0](6 bytes)
Success
[>0][+8]SD0 cmd 8 [<1F][<FF][<FF][<1][<0](6 bytes)
Read 1 blocks from 2097151
DMA send (512 bytes) OK
Success
[>0][+8]SD0 cmd 8 [<0][<13][<88][<1][<0](6 bytes)
Read 1 blocks from 5000
DMA send (512 bytes) OK
Success
[>0][+0]SD0 cmd 0 [<8][<13][<7B][<1][<0](6 bytes)
Success
[>0][+8]SD0 cmd 8 [<0][<16][<C3][<1][<0](6 bytes)
Read 1 blocks from 5827
DMA send (512 bytes) OK
Success
[>0][+8]SD0 cmd 8 [<8][<16][<B6][<1][<0](6 bytes)
Read 1 blocks from 530102
DMA send (512 bytes) OK
Success
[>0][+0]SD0 cmd 0 [<0][<19][<FE][<1][<0](6 bytes)
Success
[>0][+8]SD0 cmd 8 [<8][<19][<F1][<1][<0](6 bytes)
Read 1 blocks from 530929
DMA send (512 bytes) OK
Success
[>0][+0]SD0 cmd 0 [<0][<1D][<39][<1][<0](6 bytes)
Success
[>0][+0]SD0 cmd 0 [<8][<1D][<2C][<1][<0](6 bytes)
Success
[>0][+8]SD0 cmd 8 [<0][<20][<74][<1][<0](6 bytes)
Read 1 blocks from 8308
DMA send (512 bytes) OK
Success
[>0][+0]SD0 cmd 0 [<8][<20][<67][<1][<0](6 bytes)
Success
[>0][+0]SD0 cmd 0 [<0][<23][<AF][<1][<0](6 bytes)
Success
[>0][+8]SD0 cmd 8 [<8][<23][<A2][<1][<0](6 bytes)
Read 1 blocks from 533410
DMA send (512 bytes) OK
Success
[>0][+8]SD0 cmd 8 [<0][<26][<EA][<1][<0](6 bytes)
Read 1 blocks from 9962
DMA send (512 bytes) OK
Success
[>0][+0]SD0 cmd 0 [<8][<26][<DD][<1][<0](6 bytes)
Success
[>0][+8]SD0 cmd 8 [<0][<2A][<25][<1][<0](6 bytes)
Read 1 blocks from 10789
DMA send (512 bytes) OK
Success
[>0][+8]SD0 cmd 8 [<8][<2A][<18][<1][<0](6 bytes)
Read 1 blocks from 535064
DMA send (512 bytes) OK
Success
[>0][+8]SD0 cmd 8 [<0][<2D][<60][<1][<0](6 bytes)
Read 1 blocks from 11616
DMA send (512 bytes) OK
Success
[>0][+8]SD0 cmd 8 [<8][<2D][<53][<1][<0](6 bytes)
Read 1 blocks from 535891
DMA send (512 bytes) OK
Success
[>0][+8]SD0 cmd 8 [<0][<30][<9B][<1][<0](6 bytes)
Read 1 blocks from 12443
DMA send (512 bytes) OK
Success
[>0][+0]SD0 cmd 0 [<8][<30][<8E][<1][<0](6 bytes)
Success
[>0][+8]SD0 cmd 8 [<0][<33][<D6][<1][<0](6 bytes)
Read 1 blocks from 13270
DMA send (512 bytes) OK
Success
[>0][+8]SD0 cmd 8 [<8][<33][<C9][<1][<0](6 bytes)
Read 1 blocks from 537545
DMA send (512 bytes) OK
Success
[>0][+8]SD0 cmd 8 [<0][<37][<11][<1][<0](6 bytes)
Read 1 blocks from 14097
DMA send (512 bytes) OK
Success
[>0][+0]SD0 cmd 0 [<8][<37][<4][<1][<0](6 bytes)
Success
[>0][+8]SD0 cmd 8 [<0][<3A][<4C][<1][<0](6 bytes)
Read 1 blocks from 14924
DMA send (512 bytes) OK
Success
[>0][+8]SD0 cmd 8 [<8][<3A][<3F][<1][<0](6 bytes)
Read 1 blocks from 539199
DMA send (512 bytes) OK
Success
[>0][+0]SD0 cmd 0 [<0][<3D][<87][<1][<0](6 bytes)
Success
[>0][+8]SD0 cmd 8 [<8][<3D][<7A][<1][<0](6 bytes)
Read 1 blocks from 540026
DMA send (512 bytes) OK
Success
[>0][+8]SD0 cmd 8 [<0][<40][<C2][<1][<0](6 bytes)
Read 1 blocks from 16578
DMA send (512 bytes) OK
Success
[>0][+0]SD0 cmd 0 [<8][<40][<B5][<1][<0](6 bytes)
Success
[>0][+0]SD0 cmd 0 [<0][<43][<FD][<1][<0](6 bytes)
Success
[>0][+8]SD0 cmd 8 [<8][<43][<F0][<1][<0](6 bytes)
Read 1 blocks from 541680
DMA send (512 bytes) OK
Success
[>0][+0]SD0 cmd 0 [<0][<47][<38][<1][<0](6 bytes)
Success
[>0][+8]SD0 cmd 8 [<8][<47][<2B][<1][<0](6 bytes)
Read 1 blocks from 542507
DMA send (512 bytes) OK
Success
[>0][+8]SD0 cmd 8 [<0][<4A][<73][<1][<0](6 bytes)
Read 1 blocks from 19059
DMA send (512 bytes) OK
Success
[>0][+0]SD0 cmd 0 [<8][<4A][<66][<1][<0](6 bytes)
Success
[>0][+0]SD0 cmd 0 [<0][<4D][<AE][<1][<0](6 bytes)
Success
[>0][+0]SD0 cmd 0 [<8][<4D][<A1][<1][<0](6 bytes)
Success
[>0][+0]SD0 cmd 0 [<0][<50][<E9][<1][<0](6 bytes)
Success
[>0][+0]SD0 cmd 0 [<8][<50][<DC][<1][<0](6 bytes)
Success
[>0][+8]SD0 cmd 8 [<0][<54][<24][<1][<0](6 bytes)
Read 1 blocks from 21540
DMA send (512 bytes) OK
Success
[>0][+0]SD0 cmd 0 [<8][<54][<17][<1][<0](6 bytes)
Success
[>0][+8]SD0 cmd 8 [<0][<57][<5F][<1][<0](6 bytes)
Read 1 blocks from 22367
DMA send (512 bytes) OK
Success
[>0][+0]SD0 cmd 0 [<8][<57][<52][<1][<0](6 bytes)
Success
[>0][+0]SD0 cmd 0 [<0][<5A][<9A][<1][<0](6 bytes)
Success
[>0][+8]SD0 cmd 8 [<8][<5A][<8D][<1][<0](6 bytes)
Read 1 blocks from 547469
DMA send (512 bytes) OK
Success
[>0][+8]SD0 cmd 8 [<0][<5D][<D5][<1][<0](6 bytes)
Read 1 blocks from 24021
DMA send (512 bytes) OK
Success
[>0][+8]SD0 cmd 8 [<8][<5D][<C8][<1][<0](6 bytes)
Read 1 blocks from 548296
DMA send (512 bytes) OK
Success
[>0][+8]SD0 cmd 8 [<0][<61][<10][<1][<0](6 bytes)
Read 1 blocks from 24848
DMA send (512 bytes) OK
Success
[>0][+8]SD0 cmd 8 [<8][<61][<3][<1][<0](6 bytes)
Read 1 blocks from 549123
DMA send (512 bytes) OK
Success
[>0][+8]SD0 cmd 8 [<0][<64][<4B][<1][<0](6 bytes)
Read 1 blocks from 25675
DMA send (512 bytes) OK
Success
[>0][+0]SD0 cmd 0 [<8][<64][<3E][<1][<0](6 bytes)
Success
[>0][+0]SD0 cmd 0 [<0][<67][<86][<1][<0](6 bytes)
Success
[>0][+0]SD0 cmd 0 [<8][<67][<79][<1][<0](6 bytes)
Success
[>0][+8]SD0 cmd 8 [<0][<6A][<C1][<1][<0](6 bytes)
Read 1 blocks from 27329
DMA send (512 bytes) OK
Success
[>0][+8]SD0 cmd 8 [<8][<6A][<B4][<1][<0](6 bytes)
Read 1 blocks from 551604
DMA send (512 bytes) OK
Success
[>0][+8]SD0 cmd 8 [<0][<6D][<FC][<1][<0](6 bytes)
Read 1 blocks from 28156
DMA send (512 bytes) OK
Success
[>0][+0]SD0 cmd 0 [<8][<6D][<EF][<1][<0](6 bytes)
Success
[>0][+0]SD0 cmd 0 [<0][<71][<37][<1][<0](6 bytes)
Success
[>0][+8]SD0 cmd 8 [<8][<71][<2A][<1][<0](6 bytes)
Read 1 blocks from 553258
DMA send (512 bytes) OK
Success
[>0][+8]SD0 cmd 8 [<0][<74][<72][<1][<0](6 bytes)
Read 1 blocks from 29810
DMA send (512 bytes) OK
Success
[>0][+8]SD0 cmd 8 [<8][<74][<65][<1][<0](6 bytes)
Read 1 blocks from 554085
DMA send (512 bytes) OK
Success
[>0][+8]SD0 cmd 8 [<0][<77][<AD][<1][<0](6 bytes)
Read 1 blocks from 30637
DMA send (512 bytes) OK
Success
[>0][+8]SD0 cmd 8 [<8][<77][<A0][<1][<0](6 bytes)
Read 1 blocks from 554912
DMA send (512 bytes) OK
Success
[>0][+8]SD0 cmd 8 [<0][<7A][<E8][<1][<0](6 bytes)
Read 1 blocks from 31464
DMA send (512 bytes) OK
Success
[>0][+8]SD0 cmd 8 [<8][<7A][<DB][<1][<0](6 bytes)
Read 1 blocks from 555739
DMA send (512 bytes) OK
Success
[>0][+8]SD0 cmd 8 [<0][<7E][<23][<1][<0](6 bytes)
Read 1 blocks from 32291
DMA send (512 bytes) OK
Success
[>0][+8]SD0 cmd 8 [<8][<7E][<16][<1][<0](6 bytes)
Read 1 blocks from 556566
DMA send (512 bytes) OK
Success
[>0][+8]SD0 cmd 8 [<0][<81][<5E][<1][<0](6 bytes)
Read 1 blocks from 33118
DMA send (512 bytes) OK
Success
[>0][+8]SD0 cmd 8 [<8][<81][<51][<1][<0](6 bytes)
Read 1 blocks from 557393
DMA send (512 bytes) OK
Success
[>0][+8]SD0 cmd 8 [<0][<84][<99][<1][<0](6 bytes)
Read 1 blocks from 33945
DMA send (512 bytes) OK
Success
[>0][+8]SD0 cmd 8 [<8][<84][<8C][<1][<0](6 bytes)
Read 1 blocks from 558220
DMA send (512 bytes) OK
Success
[>0][+0]SD0 cmd 0 [<0][<87][<D4][<1][<0](6 bytes)
Success
[>0][+8]SD0 cmd 8 [<8][<87][<C7][<1][<0](6 bytes)
Read 1 blocks from 559047
DMA send (512 bytes) OK
Success
[>0][+8]SD0 cmd 8 [<0][<8B][<F][<1][<0](6 bytes)
Read 1 blocks from 35599
DMA send (512 bytes) OK
Success
[>0][+8]SD0 cmd 8 [<8][<8B][<2][<1][<0](6 bytes)
Read 1 blocks from 559874
DMA send (512 bytes) OK
Success
[>0][+8]SD0 cmd 8 [<0][<8E][<4A][<1][<0](6 bytes)
Read 1 blocks from 36426
DMA send (512 bytes) OK
Success
[>0][+0]SD0 cmd 0 [<8][<8E][<3D][<1][<0](6 bytes)
Success
[>0][+8]SD0 cmd 8 [<0][<91][<85][<1][<0](6 bytes)
Read 1 blocks from 37253
DMA send (512 bytes) OK
Success
[>0][+8]SD0 cmd 8 [<8][<91][<78][<1][<0](6 bytes)
Read 1 blocks from 561528
DMA send (512 bytes) OK
Success
[>0][+8]SD0 cmd 8 [<0][<94][<C0][<1][<0](6 bytes)
Read 1 blocks from 38080
DMA send (512 bytes) OK
Success
[>0][+0]SD0 cmd 0 [<8][<94][<B3][<1][<0](6 bytes)
Success
[>0][+0]SD0 cmd 0 [<0][<97][<FB][<1][<0](6 bytes)
Success
[>0][+8]SD0 cmd 8 [<8][<97][<EE][<1][<0](6 bytes)
Read 1 blocks from 563182
DMA send (512 bytes) OK
Success
[>0][+8]SD0 cmd 8 [<0][<9B][<36][<1][<0](6 bytes)
Read 1 blocks from 39734
DMA send (512 bytes) OK
Success
[>0][+0]SD0 cmd 0 [<8][<9B][<29][<1][<0](6 bytes)
Success
[>0][+0]SD0 cmd 0 [<0][<9E][<71][<1][<0](6 bytes)
Success
[>0][+8]SD0 cmd 8 [<8][<9E][<64][<1][<0](6 bytes)
Read 1 blocks from 564836
DMA send (512 bytes) OK
Success
[>0][+0]SD0 cmd 0 [<0][<A1][<AC][<1][<0](6 bytes)
Success
[>0][+8]SD0 cmd 8 [<8][<A1][<9F][<1][<0](6 bytes)
Read 1 blocks from 565663
DMA send (512 bytes) OK
Success
[>0][+0]SD0 cmd 0 [<0][<A4][<E7][<1][<0](6 bytes)
Success
[>0][+0]SD0 cmd 0 [<8][<A4][<DA][<1][<0](6 bytes)
Success
[>0][+8]SD0 cmd 8 [<0][<A8][<22][<1][<0](6 bytes)
Read 1 blocks from 43042
DMA send (512 bytes) OK
Success
[>0][+8]SD0 cmd 8 [<8][<A8][<15][<1][<0](6 bytes)
Read 1 blocks from 567317
DMA send (512 bytes) OK
Success
[>0][+8]SD0 cmd 8 [<0][<AB][<5D][<1][<0](6 bytes)
Read 1 blocks from 43869
DMA send (512 bytes) OK
Success
[>0][+8]SD0 cmd 8 [<8][<AB][<50][<1][<0](6 bytes)
Read 1 blocks from 568144
DMA send (512 bytes) OK
Success
[>0][+0]SD0 cmd 0 [<0][<AE][<98][<1][<0](6 bytes)
Success
[>0][+8]SD0 cmd 8 [<8][<AE][<8B][<1][<0](6 bytes)
Read 1 blocks from 568971
DMA send (512 bytes) OK
Success
[>0][+8]SD0 cmd 8 [<0][<B1][<D3][<1][<0](6 bytes)
Read 1 blocks from 45523
DMA send (512 bytes) OK
Success
[>0][+8]SD0 cmd 8 [<8][<B1][<C6][<1][<0](6 bytes)
Read 1 blocks from 569798
DMA send (512 bytes) OK
Success
[>0][+0]SD0 cmd 0 [<0][<B5][<E][<1][<0](6 bytes)
Success
[>0][+8]SD0 cmd 8 [<8][<B5][<1][<1][<0](6 bytes)
Read 1 blocks from 570625
DMA send (512 bytes) OK
Success
[>0][+0]SD0 cmd 0 [<0][<B8][<49][<1][<0](6 bytes)
Success
[>0][+0]SD0 cmd 0 [<8][<B8][<3C][<1][<0](6 bytes)
Success
[>0][+8]SD0 cmd 8 [<0][<BB][<84][<1][<0](6 bytes)
Read 1 blocks from 48004
DMA send (512 bytes) OK
Success
[>0][+8]SD0 cmd 8 [<8][<BB][<77][<1][<0](6 bytes)
Read 1 blocks from 572279
DMA send (512 bytes) OK
Success
[>0][+8]SD0 cmd 8 [<0][<BE][<BF][<1][<0](6 bytes)
Read 1 blocks from 48831
DMA send (512 bytes) OK
Success
[>0][+0]SD0 cmd 0 [<8][<BE][<B2][<1][<0](6 bytes)
Success
[>0][+0]SD0 cmd 0 [<0][<C1][<FA][<1][<0](6 bytes)
Success
[>0][+8]SD0 cmd 8 [<8][<C1][<ED][<1][<0](6 bytes)
Read 1 blocks from 573933
DMA send (512 bytes) OK
Success
[>0][+8]SD0 cmd 8 [<0][<C5][<35][<1][<0](6 bytes)
Read 1 blocks from 50485
DMA send (512 bytes) OK
Success
[>0][+0]SD0 cmd 0 [<8][<C5][<28][<1][<0](6 bytes)
Success
[>0][+8]SD0 cmd 8 [<0][<C8][<70][<1][<0](6 bytes)
Read 1 blocks from 51312
DMA send (512 bytes) OK
Success
[>0][+8]SD0 cmd 8 [<8][<C8][<63][<1][<0](6 bytes)
Read 1 blocks from 575587
DMA send (512 bytes) OK
Success
[>0][+8]SD0 cmd 8 [<0][<CB][<AB][<1][<0](6 bytes)
Read 1 blocks from 52139
DMA send (512 bytes) OK
Success
[>0][+8]SD0 cmd 8 [<8][<CB][<9E][<1][<0](6 bytes)
Read 1 blocks from 576414
DMA send (512 bytes) OK
Success
[>0][+8]SD0 cmd 8 [<0][<CE][<E6][<1][<0](6 bytes)
Read 1 blocks from 52966
DMA send (512 bytes) OK
Success
[>0][+0]SD0 cmd 0 [<8][<CE][<D9][<1][<0](6 bytes)
Success
[>0][+0]SD0 cmd 0 [<0][<D2][<21][<1][<0](6 bytes)
Success
[>0][+0]SD0 cmd 0 [<8][<D2][<14][<1][<0](6 bytes)
Success
[>0][+8]SD0 cmd 8 [<0][<D5][<5C][<1][<0](6 bytes)
Read 1 blocks from 54620
DMA send (512 bytes) OK
Success
[>0][+8]SD0 cmd 8 [<8][<D5][<4F][<1][<0](6 bytes)
Read 1 blocks from 578895
DMA send (512 bytes) OK
Success
[>0][+8]SD0 cmd 8 [<0][<D8][<97][<1][<0](6 bytes)
Read 1 blocks from 55447
DMA send (512 bytes) OK
Success
[>0][+8]SD0 cmd 8 [<8][<D8][<8A][<1][<0](6 bytes)
Read 1 blocks from 579722
DMA send (512 bytes) OK
Success
[>0][+8]SD0 cmd 8 [<0][<DB][<D2][<1][<0](6 bytes)
Read 1 blocks from 56274
DMA send (512 bytes) OK
Success
[>0][+8]SD0 cmd 8 [<8][<DB][<C5][<1][<0](6 bytes)
Read 1 blocks from 580549
DMA send (512 bytes) OK
Success
[>0][+8]SD0 cmd 8 [<0][<DF][<D][<1][<0](6 bytes)
Read 1 blocks from 57101
DMA send (512 bytes) OK
Success
[>0][+8]SD0 cmd 8 [<8][<DF][<0][<1][<0](6 bytes)
Read 1 blocks from 581376
DMA send (512 bytes) OK
Success
[>0][+0]SD0 cmd 0 [<0][<E2][<48][<1][<0](6 bytes)
Success
[>0][+0]SD0 cmd 0 [<8][<E2][<3B][<1][<0](6 bytes)
Success
[>0][+8]SD0 cmd 8 [<0][<E5][<83][<1][<0](6 bytes)
Read 1 blocks from 58755
DMA send (512 bytes) OK
Success
[>0][+8]SD0 cmd 8 [<8][<E5][<76][<1][<0](6 bytes)
Read 1 blocks from 583030
DMA send (512 bytes) OK
Success
[>0][+0]SD0 cmd 0 [<0][<E8][<BE][<1][<0](6 bytes)
Success
[>0][+8]SD0 cmd 8 [<8][<E8][<B1][<1][<0](6 bytes)
Read 1 blocks from 583857
DMA send (512 bytes) OK
Success
[>0][+8]SD0 cmd 8 [<0][<EB][<F9][<1][<0](6 bytes)
Read 1 blocks from 60409
DMA send (512 bytes) OK
Success
[>0][+0]SD0 cmd 0 [<8][<EB][<EC][<1][<0](6 bytes)
Success
[>0][+8]SD0 cmd 8 [<0][<EF][<34][<1][<0](6 bytes)
Read 1 blocks from 61236
DMA send (512 bytes) OK
Success
[>0][+8]SD0 cmd 8 [<8][<EF][<27][<1][<0](6 bytes)
Read 1 blocks from 585511
DMA send (512 bytes) OK
Success
[>0][+8]SD0 cmd 8 [<0][<F2][<6F][<1][<0](6 bytes)
Read 1 blocks from 62063
DMA send (512 bytes) OK
Success
[>0][+0]SD0 cmd 0 [<8][<F2][<62][<1][<0](6 bytes)
Success
[>0][+0]SD0 cmd 0 [<0][<F5][<AA][<1][<0](6 bytes)
Success
[>0][+0]SD0 cmd 0 [<8][<F5][<9D][<1][<0](6 bytes)
Success
[>0][+0]SD0 cmd 0 [<0][<F8][<E5][<1][<0](6 bytes)
Success
[>0][+8]SD0 cmd 8 [<8][<F8][<D8][<1][<0](6 bytes)
Read 1 blocks from 587992
DMA send (512 bytes) OK
Success
[>0][+0]SD0 cmd 0 [<0][<FC][<20][<1][<0](6 bytes)
Success
[>0][+0]SD0 cmd 0 [<8][<FC][<13][<1][<0](6 bytes)
Success
[>0][+0]SD0 cmd 0 [<0][<FF][<5B][<1][<0](6 bytes)
Success
[>0][+8]SD0 cmd 8 [<8][<FF][<4E][<1][<0](6 bytes)
Read 1 blocks from 589646
DMA send (512 bytes) OK
Success
[>0][+8]SD0 cmd 8 [<1][<2][<96][<1][<0](6 bytes)
Read 1 blocks from 66198
DMA send (512 bytes) OK
Success
[>0][+0]SD0 cmd 0 [<9][<2][<89][<1][<0](6 bytes)
Success
[>0][+0]SD0 cmd 0 [<1][<5][<D1][<1][<0](6 bytes)
Success
[>0][+0]SD0 cmd 0 [<9][<5][<C4][<1][<0](6 bytes)
Success
[>0][+0]SD0 cmd 0 [<1][<9][<C][<1][<0](6 bytes)
Success
[>0][+8]SD0 cmd 8 [<9][<8][<FF][<1][<0](6 bytes)
Read 1 blocks from 592127
DMA send (512 bytes) OK
Success
[>0][+8]SD0 cmd 8 [<1][<C][<47][<1][<0](6 bytes)
Read 1 blocks from 68679
DMA send (512 bytes) OK
Success
[>0][+8]SD0 cmd 8 [<9][<C][<3A][<1][<0](6 bytes)
Read 1 blocks from 592954
DMA send (512 bytes) OK
Success
[>0][+0]SD0 cmd 0 [<1][<F][<82][<1][<0](6 bytes)
Success
[>0][+8]SD0 cmd 8 [<9][<F][<75][<1][<0](6 bytes)
Read 1 blocks from 593781
DMA send (512 bytes) OK
Success
[>0][+8]SD0 cmd 8 [<1][<12][<BD][<1][<0](6 bytes)
Read 1 blocks from 70333
DMA send (512 bytes) OK
Success
[>0][+8]SD0 cmd 8 [<9][<12][<B0][<1][<0](6 bytes)
Read 1 blocks from 594608
DMA send (512 bytes) OK
Success
[>0][+8]SD0 cmd 8 [<1][<15][<F8][<1][<0](6 bytes)
Read 1 blocks from 71160
DMA send (512 bytes) OK
Success
[>0][+0]SD0 cmd 0 [<9][<15][<EB][<1][<0](6 bytes)
Success
[>0][+0]SD0 cmd 0 [<1][<19][<33][<1][<0](6 bytes)
Success
[>0][+0]SD0 cmd 0 [<9][<19][<26][<1][<0](6 bytes)
Success
[>0][+8]SD0 cmd 8 [<1][<1C][<6E][<1][<0](6 bytes)
Read 1 blocks from 72814
DMA send (512 bytes) OK
Success
[>0][+0]SD0 cmd 0 [<9][<1C][<61][<1][<0](6 bytes)
Success
[>0][+8]SD0 cmd 8 [<1][<1F][<A9][<1][<0](6 bytes)
Read 1 blocks from 73641
DMA send (512 bytes) OK
Success
[>0][+0]SD0 cmd 0 [<9][<1F][<9C][<1][<0](6 bytes)
Success
[>0][+0]SD0 cmd 0 [<1][<22][<E4][<1][<0](6 bytes)
Success
[>0][+8]SD0 cmd 8 [<9][<22][<D7][<1][<0](6 bytes)
Read 1 blocks from 598743
DMA send (512 bytes) OK
Success
[>0][+8]SD0 cmd 8 [<1][<26][<1F][<1][<0](6 bytes)
Read 1 blocks from 75295
DMA send (512 bytes) OK
Success
[>0][+8]SD0 cmd 8 [<9][<26][<12][<1][<0](6 bytes)
Read 1 blocks from 599570
DMA send (512 bytes) OK
Success
[>0][+8]SD0 cmd 8 [<1][<29][<5A][<1][<0](6 bytes)
Read 1 blocks from 76122
DMA send (512 bytes) OK
Success
[>0][+0]SD0 cmd 0 [<9][<29][<4D][<1][<0](6 bytes)
Success
[>0][+8]SD0 cmd 8 [<1][<2C][<95][<1][<0](6 bytes)
Read 1 blocks from 76949
DMA send (512 bytes) OK
Success
[>0][+8]SD0 cmd 8 [<9][<2C][<88][<1][<0](6 bytes)
Read 1 blocks from 601224
DMA send (512 bytes) OK
Success
[>0][+0]SD0 cmd 0 [<1][<2F][<D0][<1][<0](6 bytes)
Success
[>0][+8]SD0 cmd 8 [<9][<2F][<C3][<1][<0](6 bytes)
Read 1 blocks from 602051
DMA send (512 bytes) OK
Success
[>0][+8]SD0 cmd 8 [<1][<33][<B][<1][<0](6 bytes)
Read 1 blocks from 78603
DMA send (512 bytes) OK
Success
[>0][+8]SD0 cmd 8 [<9][<32][<FE][<1][<0](6 bytes)
Read 1 blocks from 602878
DMA send (512 bytes) OK
Success
[>0][+8]SD0 cmd 8 [<1][<36][<46][<1][<0](6 bytes)
Read 1 blocks from 79430
DMA send (512 bytes) OK
Success
[>0][+0]SD0 cmd 0 [<9][<36][<39][<1][<0](6 bytes)
Success
[>0][+0]SD0 cmd 0 [<1][<39][<81][<1][<0](6 bytes)
Success
[>0][+8]SD0 cmd 8 [<9][<39][<74][<1][<0](6 bytes)
Read 1 blocks from 604532
DMA send (512 bytes) OK
Success
[>0][+0]SD0 cmd 0 [<1][<3C][<BC][<1][<0](6 bytes)
Success
[>0][+8]SD0 cmd 8 [<9][<3C][<AF][<1][<0](6 bytes)
Read 1 blocks from 605359
DMA send (512 bytes) OK
Success
[>0][+0]SD0 cmd 0 [<1][<3F][<F7][<1][<0](6 bytes)
Success
[>0][+0]SD0 cmd 0 [<9][<3F][<EA][<1][<0](6 bytes)
Success
[>0][+8]SD0 cmd 8 [<1][<43][<32][<1][<0](6 bytes)
Read 1 blocks from 82738
DMA send (512 bytes) OK
Success
[>0][+0]SD0 cmd 0 [<9][<43][<25][<1][<0](6 bytes)
Success
[>0][+8]SD0 cmd 8 [<1][<46][<6D][<1][<0](6 bytes)
Read 1 blocks from 83565
DMA send (512 bytes) OK
Success
[>0][+0]SD0 cmd 0 [<9][<46][<60][<1][<0](6 bytes)
Success
[>0][+8]SD0 cmd 8 [<1][<49][<A8][<1][<0](6 bytes)
Read 1 blocks from 84392
DMA send (512 bytes) OK
Success
[>0][+0]SD0 cmd 0 [<9][<49][<9B][<1][<0](6 bytes)
Success
[>0][+0]SD0 cmd 0 [<1][<4C][<E3][<1][<0](6 bytes)
Success
[>0][+8]SD0 cmd 8 [<9][<4C][<D6][<1][<0](6 bytes)
Read 1 blocks from 609494
DMA send (512 bytes) OK
Success
[>0][+0]SD0 cmd 0 [<1][<50][<1E][<1][<0](6 bytes)
Success
[>0][+8]SD0 cmd 8 [<9][<50][<11][<1][<0](6 bytes)
Read 1 blocks from 610321
DMA send (512 bytes) OK
Success
[>0][+8]SD0 cmd 8 [<1][<53][<59][<1][<0](6 bytes)
Read 1 blocks from 86873
DMA send (512 bytes) OK
Success
[>0][+8]SD0 cmd 8 [<9][<53][<4C][<1][<0](6 bytes)
Read 1 blocks from 611148
DMA send (512 bytes) OK
Success
[>0][+8]SD0 cmd 8 [<1][<56][<94][<1][<0](6 bytes)
Read 1 blocks from 87700
DMA send (512 bytes) OK
Success
[>0][+0]SD0 cmd 0 [<9][<56][<87][<1][<0](6 bytes)
Success
[>0][+0]SD0 cmd 0 [<1][<59][<CF][<1][<0](6 bytes)
Success
[>0][+0]SD0 cmd 0 [<9][<59][<C2][<1][<0](6 bytes)
Success
[>0][+0]SD0 cmd 0 [<1][<5D][<A][<1][<0](6 bytes)
Success
[>0][+8]SD0 cmd 8 [<9][<5C][<FD][<1][<0](6 bytes)
Read 1 blocks from 613629
DMA send (512 bytes) OK
Success
[>0][+8]SD0 cmd 8 [<1][<60][<45][<1][<0](6 bytes)
Read 1 blocks from 90181
DMA send (512 bytes) OK
Success
[>0][+8]SD0 cmd 8 [<9][<60][<38][<1][<0](6 bytes)
Read 1 blocks from 614456
DMA send (512 bytes) OK
Success
[>0][+8]SD0 cmd 8 [<1][<63][<80][<1][<0](6 bytes)
Read 1 blocks from 91008
DMA send (512 bytes) OK
Success
[>0][+0]SD0 cmd 0 [<9][<63][<73][<1][<0](6 bytes)
Success
[>0][+8]SD0 cmd 8 [<1][<66][<BB][<1][<0](6 bytes)
Read 1 blocks from 91835
DMA send (512 bytes) OK
Success
[>0][+8]SD0 cmd 8 [<9][<66][<AE][<1][<0](6 bytes)
Read 1 blocks from 616110
DMA send (512 bytes) OK
Success
[>0][+0]SD0 cmd 0 [<1][<69][<F6][<1][<0](6 bytes)
Success
[>0][+0]SD0 cmd 0 [<9][<69][<E9][<1][<0](6 bytes)
Success
[>0][+8]SD0 cmd 8 [<1][<6D][<31][<1][<0](6 bytes)
Read 1 blocks from 93489
DMA send (512 bytes) OK
Success
[>0][+8]SD0 cmd 8 [<9][<6D][<24][<1][<0](6 bytes)
Read 1 blocks from 617764
DMA send (512 bytes) OK
Success
[>0][+0]SD0 cmd 0 [<1][<70][<6C][<1][<0](6 bytes)
Success
[>0][+8]SD0 cmd 8 [<9][<70][<5F][<1][<0](6 bytes)
Read 1 blocks from 618591
DMA send (512 bytes) OK
Success
[>0][+0]SD0 cmd 0 [<1][<73][<A7][<1][<0](6 bytes)
Success
[>0][+8]SD0 cmd 8 [<9][<73][<9A][<1][<0](6 bytes)
Read 1 blocks from 619418
DMA send (512 bytes) OK
Success
[>0][+0]SD0 cmd 0 [<1][<76][<E2][<1][<0](6 bytes)
Success
[>0][+0]SD0 cmd 0 [<9][<76][<D5][<1][<0](6 bytes)
Success
[>0][+0]SD0 cmd 0 [<1][<7A][<1D][<1][<0](6 bytes)
Success
[>0][+0]SD0 cmd 0 [<9][<7A][<10][<1][<0](6 bytes)
Success
[>0][+0]SD0 cmd 0 [<1][<7D][<58][<1][<0](6 bytes)
Success
[>0][+0]SD0 cmd 0 [<9][<7D][<4B][<1][<0](6 bytes)
Success
[>0][+0]SD0 cmd 0 [<1][<80][<93][<1][<0](6 bytes)
Success
[>0][+8]SD0 cmd 8 [<9][<80][<86][<1][<0](6 bytes)
Read 1 blocks from 622726
DMA send (512 bytes) OK
Success
[>0][+0]SD0 cmd 0 [<1][<83][<CE][<1][<0](6 bytes)
Success
[>0][+8]SD0 cmd 8 [<9][<83][<C1][<1][<0](6 bytes)
Read 1 blocks from 623553
DMA send (512 bytes) OK
Success
[>0][+0]SD0 cmd 0 [<1][<87][<9][<1][<0](6 bytes)
Success
[>0][+8]SD0 cmd 8 [<9][<86][<FC][<1][<0](6 bytes)
Read 1 blocks from 624380
DMA send (512 bytes) OK
Success
[>0][+8]SD0 cmd 8 [<1][<8A][<44][<1][<0](6 bytes)
Read 1 blocks from 100932
DMA send (512 bytes) OK
Success
[>0][+8]SD0 cmd 8 [<9][<8A][<37][<1][<0](6 bytes)
Read 1 blocks from 625207
DMA send (512 bytes) OK
Success
[>0][+0]SD0 cmd 0 [<1][<8D][<7F][<1][<0](6 bytes)
Success
[>0][+8]SD0 cmd 8 [<9][<8D][<72][<1][<0](6 bytes)
Read 1 blocks from 626034
DMA send (512 bytes) OK
Success
[>0][+8]SD0 cmd 8 [<1][<90][<BA][<1][<0](6 bytes)
Read 1 blocks from 102586
DMA send (512 bytes) OK
Success
[>0][+8]SD0 cmd 8 [<9][<90][<AD][<1][<0](6 bytes)
Read 1 blocks from 626861
DMA send (512 bytes) OK
Success
[>0][+0]SD0 cmd 0 [<1][<93][<F5][<1][<0](6 bytes)
Success
[>0][+8]SD0 cmd 8 [<9][<93][<E8][<1][<0](6 bytes)
Read 1 blocks from 627688
DMA send (512 bytes) OK
Success
[>0][+8]SD0 cmd 8 [<1][<97][<30][<1][<0](6 bytes)
Read 1 blocks from 104240
DMA send (512 bytes) OK
Success
[>0][+8]SD0 cmd 8 [<9][<97][<23][<1][<0](6 bytes)
Read 1 blocks from 628515
DMA send (512 bytes) OK
Success
[>0][+8]SD0 cmd 8 [<1][<9A][<6B][<1][<0](6 bytes)
Read 1 blocks from 105067
DMA send (512 bytes) OK
Success
[>0][+0]SD0 cmd 0 [<9][<9A][<5E][<1][<0](6 bytes)
Success
[>0][+0]SD0 cmd 0 [<1][<9D][<A6][<1][<0](6 bytes)
Success
[>0][+0]SD0 cmd 0 [<9][<9D][<99][<1][<0](6 bytes)
Success
[>0][+0]SD0 cmd 0 [<1][<A0][<E1][<1][<0](6 bytes)
Success
[>0][+8]SD0 cmd 8 [<9][<A0][<D4][<1][<0](6 bytes)
Read 1 blocks from 630996
DMA send (512 bytes) OK
Success
[>0][+0]SD0 cmd 0 [<1][<A4][<1C][<1][<0](6 bytes)
Success
[>0][+8]SD0 cmd 8 [<9][<A4][<F][<1][<0](6 bytes)
Read 1 blocks from 631823
DMA send (512 bytes) OK
Success
[>0][+8]SD0 cmd 8 [<1][<A7][<57][<1][<0](6 bytes)
Read 1 blocks from 108375
DMA send (512 bytes) OK
Success
[>0][+0]SD0 cmd 0 [<9][<A7][<4A][<1][<0](6 bytes)
Success
[>0][+8]SD0 cmd 8 [<1][<AA][<92][<1][<0](6 bytes)
Read 1 blocks from 109202
DMA send (512 bytes) OK
Success
[>0][+8]SD0 cmd 8 [<9][<AA][<85][<1][<0](6 bytes)
Read 1 blocks from 633477
DMA send (512 bytes) OK
Success
[>0][+8]SD0 cmd 8 [<1][<AD][<CD][<1][<0](6 bytes)
Read 1 blocks from 110029
DMA send (512 bytes) OK
Success
[>0][+0]SD0 cmd 0 [<9][<AD][<C0][<1][<0](6 bytes)
Success
[>0][+0]SD0 cmd 0 [<1][<B1][<8][<1][<0](6 bytes)
Success
[>0][+8]SD0 cmd 8 [<9][<B0][<FB][<1][<0](6 bytes)
Read 1 blocks from 635131
DMA send (512 bytes) OK
Success
[>0][+8]SD0 cmd 8 [<1][<B4][<43][<1][<0](6 bytes)
Read 1 blocks from 111683
DMA send (512 bytes) OK
Success
[>0][+8]SD0 cmd 8 [<9][<B4][<36][<1][<0](6 bytes)
Read 1 blocks from 635958
DMA send (512 bytes) OK
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

Thread 18 (2021-12-15):

Migrate to a Raspberry pico

mlorenzati, 2021-12-15:
I've seen the documentation that states that the main problem is related to timing when checking the CS pin.
Rasberry pico can run from 130mhz to up to 300mhz overclocked and in the same form factor of the bluepill, plus the rpi has a really powerful programmable PIO that works with DMA, independently from the M0 cores if required.

How feasible would be to transition to that soc?

retro16, 2021-12-15:
It is doable. Basically you would have to rewrite the Acsi class in Acsi.h to adapt it to the Pico.

I'm not using this project actively anymore so I don't really have time to involve in such a project beyond answering a few questions, but I could probably help somebody who wants to do this by giving a few hints. Implementing the ACSI/DMA protocol on the Pico PIO is a good way to achieve higher performance and reliability than this STM32 implementation.

To be honest the TIMER approach in v2.1 should really work 100% on paper and yet some people still have issues. Making this really work reliably would require a lot of testing on a lot of different ST from many generations.

retro16, 2023-06-04:
Closing that old issue as 4.00 fixes the issue mentioned.

Closed 2023-06-04.

Thread 19 (2022-01-17):

Gerber files

jeroentaverne, 2022-01-17:
Hi. Are there some gerber files available for this project? I know it can be hand wired, but a real PCB will make it look much nicer. Thanks!

tomtebloss, 2022-02-01:
I did fork this out and made some PCB: https://github.com/tomtebloss/acsi2stm/tree/master/gerbers

luciust, 2022-04-03:
Hey, thanks for the gerbers, just a note: the R3 is 10k not 100k. With 100k you can't set the programming mode. BOM needs fixing pictures are showing correct resistor.

tomtebloss, 2022-04-03:
Thx for pointing it out. Changed BOM and readme. I changed R4 to 10K as well since it is also part of the programming mode but not really used in out project.

luciust, 2022-04-03:
@tomtebloss No problemo, big thanks for gerbers - I've finished soldering first one and now trying to cope with my STM32 version which is odd - seems to be either not starting the official build or my compiled version, but kind-of works (shows up as multiple ADAPTEC 5500 controlers) with this binary:  https://github.com/retro16/acsi2stm/issues/15#issuecomment-968469499

luciust, 2022-04-05:
@tomtebloss One more question - the R2 on your photo is 1K while BOM states 10k. Should it be 1k as well?

tomtebloss, 2022-04-05:
> @tomtebloss One more question - the R2 on your photo is 1K while BOM states 10k. Should it be 1k as well?

I'm unsure which photo you mean? Schematics says 10K and the [photo](https://github.com/tomtebloss/acsi2stm/blob/master/gerbers/images/ACSI2STM_v1.2_back.jpg) is 1002? A 10K right?

Anyway, it's part of the reset circuit along with C2.

luciust, 2022-04-05:
@tomtebloss Yeah - correct the 4 digit mode - yet if photo is correct - then BOM says: R2, R3 are 10k , while on the said picture we have R2 @ 10k and R4 @ 100k. My fault I got confused with my 3 and your 4 digit code - but I would say that BOM and R2,R3 and R4 vs picture - need your eyes. I'm debugging the fake STM32 - thus looking at each small piece on blue pill vs gerber too...

tomtebloss, 2022-04-06:
Here is the [schematics](https://stm32-base.org/assets/pdf/boards/original-schematic-STM32F103C8T6-Blue_Pill.pdf) I used (if I remember correctly) of the "bluepill" when I designed my board. Apparently R10 should be changed to 1.5K. So I will probably change that at least. I didn't use USB for programming. Only for power.

I will have to change some resistors and try mine out first and then take new photos.

luciust, 2022-04-06:
Thanks! I needed that!

retro16, 2022-06-28:
Version 3.00 now provides an official PCB. Closing this issue.

Closed 2022-06-28.

Thread 20 (2022-02-28):

Problems building for STM32F401CCu6 clone BlackPill

z80micro-mc, 2022-02-28:
I am having problems trying to build for a Blackpill clone - WeAct v3 type - with 3 oval buttons, STM32F401ccu6 processor, LED on PC13.  I am running Arduino 1.8.12 with STM 2.2 boards

I can build and upload simple sketches ok. (eg Blink ) But keep getting compile errors:

mapledma.h

Acsi.cpp:240:10: fatal error: libmaple/dma.h: No such file or directory
240 | #include <libmaple/dma.h>
| ^~~~~~~~~~~~~~~~
compilation terminated.

exit status 1
libmaple/dma.h: No such file or directory

Not sure why it wants the maple library it is a Blackpill not a Bluepill.

I have the SDfat library installed and have created a Hardware directory with the STM32 files in it.

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

Any input would be appreciated.

Thanks

Peter

retro16, 2022-03-01:
Hi, this projects doesn't use the official STM32 board (selected in your last screenshot).
It uses the Roger Clark Melbourne framework (for historical reasons) available here: https://github.com/rogerclarkmelbourne/Arduino_STM32
This framework is based on the Maple framework, that's why you are missing libmaple includes.

Once it compiles, you will probably need to reassign pins based on the requirements of the integrated timers. Also, I cannot certify that the DMA input trick using an unused timer register will work on anything other than the original STM32F103C8. It does pretty wild stuff with timers and DMA to achieve stable and fast results.

JM

z80micro-mc, 2022-03-01:
Jean,

Thanks for the reply. I take it from this that the 'BlackPills' that you
refer to are the older STM32F103 based variants and not the newer
STM32F401 / STM32F411 based versions.

I had hoped that as the notes suggested that the main issue was with LED
on PB12 instead of PC13 being the most serious issue with the BlackPill
so when I found the newer STM32F401 based versions with the LED already
on PC13 I was hoping for a simple fast solution this together with the
greater availability of the newer boards in the UK.

Peter

------ Original Message ------
From: "Jean-Matthieu COULON" ***@***.***>
To: "retro16/acsi2stm" ***@***.***>
Cc: "z80micro-mc" ***@***.***>; "Author"
***@***.***>
Sent: Tuesday, 1 Mar, 22 At 12:01
Subject: Re: [retro16/acsi2stm] Problems building for STM32F401CCu6
clone BlackPill (Issue #20)

Hi, this projects doesn't use the official STM32 board (selected in your
last screenshot).
  It uses the Roger Clark Melbourne framework (for historical reasons)
available here: https://github.com/rogerclarkmelbourne/Arduino_STM32
<https://github.com/rogerclarkmelbourne/Arduino_STM32>
  This framework is based on the Maple framework, that's why you are
missing libmaple includes.
Once it compiles, you will probably need to reassign pins based on the
requirements of the integrated timers. Also, I cannot certify that the
DMA input trick using an unused timer register will work on anything
other than the original STM32F103C8. It does pretty wild stuff with
timers and DMA to achieve stable and fast results.
JM
—
Reply to this email directly, view it on GitHub
<https://github.com/retro16/acsi2stm/issues/20#issuecomment-1055362623>
, or unsubscribe
<https://github.com/notifications/unsubscribe-auth/ATCK64CMKJM355JSRE6GU3LU5YBJNANCNFSM5PSENBZA>
.
Triage notifications on the go with GitHub Mobile for iOS
<https://apps.apple.com/app/apple-store/id1477376905?ct=notification-email&mt=8&pt=524675>
or Android
<https://play.google.com/store/apps/details?id=com.github.android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>
.
You are receiving this because you authored the thread.Message ID:
***@***.***>

retro16, 2022-03-01:
Oh you are absolutely right, I was refering to the older F103 black boards (which seem to be very rare). This needs an adjustment of the README to make it clear. Thanks a lot for bringing these new boards to my attention (I'm working on non-microcontroller projects these days and didn't keep up with the newer stuff).

retro16, 2022-03-01:
Updated the README. Keeping the issue opened if anyone want to try to make this project run on the newer black pill boards.

Thread 21 (2022-03-06):

Low memory resources warning when building for BluePill

z80micro-mc, 2022-03-06:
I have just successfully compiled the ACSI2STM code for a BluePill STM32F103C8T6. However, I get compiler warnings that the resulting code may be unstable due to low availability of memory resources.

It informs me that 83% of Flash is used 54882 bytes and 77% of RAM 15880 bytes. (-O2 option)

However, ST-Link informs me that the STM has 128 kb Flash so less than 1/2 full.

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

As I understand it an STM32f103C8 has 64 kb flash but ST-link is reporting that mine has 128 kb.

Is this a problem?
Do I need to upgrade to an STMF103CB (128 kb flash). Not sure how else to resolve this as my attempts to use STMF401CC BlackPill fails to compile.

Thoughts

Thanks

Peter

z80micro-mc, 2022-03-06:
As ST-Link is informing me that I have 128 k flash, I have just tried building as an STM32F103CB

It is still not happy with low memory though now only 41% of Flash is in use, still 77% or RAM.

**Adruino IDE o/p**
_Sketch uses 54884 bytes (41%) of program storage space. Maximum is 131072 bytes.
Global variables use 15880 bytes (77%) of dynamic memory, leaving 4600 bytes for local variables. Maximum is 20480 bytes.
Low memory available, stability problems may occur.
STM32 ST-LINK CLI v3.3.0.0
STM32 ST-LINK Command Line Interface

ST-LINK SN: 56FF6F065080495143331687
ST-LINK Firmware version: V2J39S7 (Need Update)
Connected via SWD.
SWD Frequency = 4000K.
Target voltage = 3.3 V
Connection mode: Normal
Reset mode: Software reset
Device ID: 0x410
Device flash Size: 128 Kbytes
Device family: STM32F10xx Medium-density

Loading file...
Flash Programming:
  File : C:\Users\Peter\AppData\Local\Temp\arduino_build_974230\acsi2stm.ino.bin
  Address : 0x08000000
Memory programming...
 0%������ 13%������� 27%������� 41%������� 55%������� 69%������� 83%������� 97%�� 100%
Memory programmed in 4s and 391ms.
Programming Complete._

So other than moving to STM32F4xx series not sure how else to get more RAM.

Peter

retro16, 2022-03-07:
Hi,

The warning message is because of low RAM.

About flash, there are 128k chips sold as 64k (I have a few too), but in any case there is no issue there because the code fits in 64k anyway. What you see is perfectly normal.

I did a few tests and it seems that the upload method changes the amount of avaiable RAM. Uploading via st-link eats up something like 600 bytes of RAM.

4600 bytes of RAM is still plenty (well, not really, but it's acceptable) to make this project run.

A few ways to decrease RAM usage:
* Comment out lines in the sdCs array for SD card slots you don't need.
* Remove the snprintf call that eats up a lot of RAM. That has been done in the "experimental" branch that I don't recommend trying that branch at all (it's basically work in progress but it came to a stall because I don't have time anymore to work on that project).

If RAM is really an issue, I might try to backport this snprintf removal thing but since I don't have access to a ST right now I'll need some beta testers.

retro16, 2022-06-28:
3.00 was optimized to use less RAM. Closing the issue.

Thread 22 (2022-03-09):

Not compatible with the standard, some drivers don't work

troed, 2022-03-09:
It seems the ACSI2STM project isn't implementing (or not correctly implementing) some commands that would allow it to work with more drivers on the Atari (in this case, HDDriver specifically). There's been a discussion over on the HDDriver forum and Uwe has helpfully suggested using his testsuite and monitor (see at the bottom of https://www.hddriver.net/en/scsidriver.html ) to figure out where the problems might be.

I've run SDRVTEST which complained on not getting an error accessing invalid LUN, and hanging on reading from the invalid LUN, as well as SERRTEST that threw an error on getting the capacity. I've not researched this further.

It is, sort of, possible to use HDDriver with ACSI2STM (see my post here: https://www.hddriver.net/forum/viewtopic.php?p=887#p887 ) so I don't expect it to be much work (famous last words) to increase compatibility.

retro16, 2022-03-14:
I just commited some changes into master. I didn't fully test hddriver, but at least SDRVTEST does not complain too much anymore. SERRTEST is still not happy.

retro16, 2022-06-28:
Version 3.00 should be much more SCSI compliant, especially in strict mode.

fplanque, 2024-09-15:
> Version 3.00 should be much more SCSI compliant, especially in strict mode.

Does this mean it's "more" compliant but still not *really* compliant ?

I had many [many many issues](https://www.fplanque.com/dev/retro/atari-st-acsi2stm-mega-ste/) trying to get it to work in conjuction with an internal Mega STE SCSI controller.

Closed 2023-06-04.

Thread 23 (2022-03-15):

Relation with comercial ACSI2STM?

EUcitizen, 2022-03-15:
There is project sold with same name "ACSI2STM": https://www.atari-forum.com/viewtopic.php?t=40018

How is relation with this open source project? Is use of name authorised? Is use of same software authorised?

PS: I like open source project better. 😄

retro16, 2022-03-16:
I had a few people asking if they could build and sell some units, but I don't know if this particular project is one of them.

However, this is not an issue: my project is covered by the GPLv3 license. It means that anyone can use the code without permission (and sell products based on it), but they *must* provide the source code (including their modifications) with the units they sell: either with the unit itself, or a link to download it. This is a legal requirement of the GPL license.

The name ACSI2STM is not protected so it's fine that they use it.

Here is my personal opinion about people selling products based on my code:

* This is super cool, I feel honored that my work can be useful to some people and I really like it.
* Some sellers actually helped me to improve the code, so big thanks to them.
* Sellers should not expect this code to work flawlessly. They are responsible for supporting the products they sell.
* Feedback on this github is highly appreciated. I take any bug/improvement submission seriously and do the best I can in my very limited free time.
* Of course, any patch/pull request is welcome, especially from sellers that have feedback from many users with many different machines.
* I am very attached to the GPLv3 license. Sellers/modders really have to provide the source code, especially if they modified it.

EUcitizen, 2022-03-16:
Thank you for clarification. Particular last sentence.

Seller writes in forum "Original firmware is slightly optimized". But does not provide source code for optimized firmware.

peterdenmarkSeest, 2022-03-16:
Greetings

As a customer of the seller you pointed,

Be polite and ask, did you try a "please"?
You will be regarded with this:

Line 54: #define CSA1_MASK 0b11000000 //Remove an "and" operation

Line 332: while((b = GPIOB->regs->IDR) & (CSA1_MASK)); //Remove watchdog feeding

All customers know that the software is from Jean-Matthieu Coulon,
In the package there is an instructions sheet, as second sentence it reads:

-This devices uses the code from ACSI2STM: Jean-Matthieu COULON, give thanks to him!

Also, we know that one of these manufactured devices were delivered freely to Coulon,

and more important, I ordered one of these for my stfm and ste computers.
It worked ok for STFM, but not in ste. After several attempts, the manufactured developed a custom firmware exclusive to me, and it works well in the ste.

Due to I am the type of person that bought from many sellers, also have an UltraSatan, that never worked in the ste.
And no solutions were provided, as well I bought one from this seller:

https://www.ebay.es/itm/154897663589?hash=item24109ec665:g:sP4AAOSwhjFhWf6Z

The funny part is it does not work in the ste, but the seller you pointed wrote freely a firmware that supports the 2 sd cards of SD4ST. A device the pointed seller is not the manufacturer, but provided help and solutions for it.

Recently I bought 2 more units, surprisingly its a new design, that operates faster. Works well in stfm and ste.

According to the seller, the faster operation relies in careful sd card lines, letting higher sd frequencies.

EUcitizen, 2022-03-16:
Paper saying "thanks" is not sufficient for GPLv3.

Also, can it be that you are in fact the seller of comercial ACSI2STM, @[peterdenmarkSeest](https://github.com/peterdenmarkSeest)?

retro16, 2022-03-16:
I don't want to upset anyone. Now I recall who is the guy, I confirm that he is super cool, he sent me a free piece (nice product BTW) and was super helpful with feedback and ideas. I also appreciate that he gives credits to me. I also owe him an apology for changing the pinout for v2 a few weeks after he released his product !

That being said, I still confirm that the code is GPLv3 for a reason: I want my code as well as other people's improvements to be shared and improved by a community. Giving a patch of 2 lines with a description of the changes is *not* the full sources. Being polite when asking for the sources is not legally required, but I strongly encourage it !

That also applies to any "custom" version relying partially or totally on my code. And it's not just about me, it's also about the patched Arduino library I included in the old version 1 of acsi2stm.

Closed 2022-03-16.

Thread 24 (2022-03-21):

Too many messages on startup

TzOk83, 2022-03-21:
2.31 prints out a copyright/introduction message for every SD card, I think printing it once would be enough ;)

retro16, 2022-03-21:
2.31 only prints a message if no SD card is inserted or if the SD is not bootable.

You probably have less than 5 SD card readers, a way around that would be to set ACSI_SD_CARDS in acsi2stm/acsi2stm.h to the actual number of slots you have. If all card readers have a SD card inserted, you should see no message.

If the feature annoys you, just compile with ACSI_DUMMY_BOOT_SECTOR and ACSI_BOOT_OVERLAY set to 0 to turn everything off.

I'll think about a way to reduce this, but it's not trivial as each SD card is an independent device and the boot payload is the same for all devices.

TzOk83, 2022-03-21:
I have used a precompiled binary instead of compiling my own, so I had no chance to set anything.

Interesting fact - on my STfm it displays messages and doesn't autoboot, while on STe it displays only ICD splash, and autoboots. Same SD card, same everything.

retro16, 2022-03-22:
I am working on a new way to disable unused SD slots by soldering some pins, so people can build a hardware unit without having to rebuild from source on each upgrade.

Closed 2022-03-26.

Thread 25 (2022-03-22):

No reset at power on

TzOk83, 2022-03-22:
ACSI has a /RESET signal, which can be used. ST pulls /RESET low at power-on, this could resolve the issues with power cycling ST requiring to manually reset the "blue pill".

retro16, 2022-03-23:
Ignoring the /RESET line was a poor design choice I made back in the old pre-1.0 days.

Unfortunately it's much more complex than connecting /RESET to the reset pin of the blue pill. A direct connection would make debug impossible (STM32 reset triggers the bootloader in dev mode) and would be problematic for the few SD cards that take a long time to boot (especially for the people with many SD cards). Also, you don't want to reset in the middle of SD card communications to avoid damage.

Since I don't want to make incompatible changes to the pins for v2.x versions, I will keep the design as it is right now. 2.3 has many refinements to avoid false command triggering so the issue is low priority. If a version 3.x ever comes, I will incorporate that modification if possible. I'll keep this issue opened as a reminder of this good idea.

TzOk83, 2022-03-23:
I guess you don't need to literally reset the STM32 on ST reset, but rather perform a kind of soft-reset when /RESET signal on ST is asserted. So use the /RESET line as an IRQ source, rather than bind it to the STM32's reset pin.

retro16, 2022-04-07:
Done it in 3.0a ! 3.0a is marked alpha because the new integrated driver is still a mess, but if you don't use it you are probably fine.
/RESET connects to PA15.

Closed 2022-04-07.

Thread 26 (2022-06-15):

Atari TT030 compatibility?

GreatStoneEx, 2022-06-15:
Hello,

My Atari TT030 is not able to boot on acsi2stm (which is fine, it was mainly for my 1040).
Is there any plan to make it compatible with TT?

Regards

retro16, 2022-06-15:
Hello, thank you for your feedback. I don't have access to a TT (in fact, I never saw a real TT !) so I cannot work on its compatibility. If it's only a boot issue, this might be doable on an emulator, does it work if you boot a driver such as ICD from a floppy drive ?

If anyone with good TT knowledge and a logic analyzer (and a lot of patience) is willing to cooperate on this task, I could work on this after releasing a stable 3.0.

If the TT hard drive port is any faster than the ST, then it's impossible to make it work because the ST already pushes that good old STM32 blue pill to its limits.

GreatStoneEx, 2022-06-15:
Thanks for the quick answer!
I have a gotek coming, to plug into the TT, so that I can easily test stuff like that: as soon as it is installed, I will try it to see if it's coming from the boot. Hopefully, it will be just that :)

GreatStoneEx, 2022-06-16:
So, I tested today with the new gotek.
* Image of ICD driver 6.55a in the selected image of the gotek
* acsi2stm plugged
If I turn on the TT, wait for some time, icd driver is booting and showing me a list of all the partitions of the sd card from the acsi2stm!!
Then arriving to the desktop, I am able to browse my files :)
Sim city is working like a charm!

When, I decided to shutdown the TT, remove the floppy image from the gotek, boot again.
...and it is also working now ?!

I do not know what was going one, but asci2stm is now working fine in my TT, directly when starting it :)

retro16, 2022-06-19:
Wow that is super good news. Thanks for the feedback. Boot can be a bit hit or miss depending on SD timings or other factors.
I will close this ticket, feel free to reopen if you encounter issues again on your TT.

Closed 2022-06-19.

Thread 27 (2022-07-16):

Reliable source or Blue Pill boards

mamejay, 2022-07-16:
Not really an issue but I have had not luck getting working Blue Pills.  Does anyone have a trusted seller of Blue Pill boards that they can recommend?
Thanks

retro16, 2022-07-16:
I must apologize for a big mistake I just did. In my usual process of fighting spam, I wrongly reported this issue as my broken brain thought this was about another kind of "blue pills" !
Sorry mamejay for what I just did, I recognized your pseudo a bit too late. If there is any kind of aftermath, let me know if I need to do anything about it.

vitecd, 2022-07-17:
https://www.aliexpress.com/item/4001169143888.html
https://www.aliexpress.com/item/32377410710.html

mamejay, 2022-07-17:
Thanks for that Vitecd.  So have you purchased from this seller recently and they have been ok?

vitecd, 2022-07-18:
Yes, I have pills from both suppliers.
Cheers

mamejay, 2022-07-19:
OK.  I have ordered 5 of the second link you sent.  I find the super cheap ones are always duds.  Now we wait and see

mamejay, 2022-07-28:
Just to let everyone know.  Received the Blue Pills and they program fine except they will not boot.  I have so many of these duds now I am just giving up.

retro16, 2022-07-28:
I just order one from the second link of vitecd, hopefully I will receiv the same as mamejay. Once received (usually takes 1 month for shipping where I live) I will test it myself. If I have the same issues, I will try to debug this further, making bad units work would be very interesting.

mamejay, 2022-07-30:
Excellent.  I hope you can get these working.  I have only been testing with 2.x code as I have not modified any boards for 3.x code.
With the modifications for a 2.x board will 2.x firmware still work or do I need to just use 3.x firmware?  I just test my boards using a patari games image.  Will this still work on 3.x?

retro16, 2022-07-30:
You can safely flash 3.x to 2.x units. All you risk is having read-only drives and a little bit of unstability at reboot. Read-only problem can be worked around by patching ACSI_SD_WRITE_LOCK to 0 in acsi2stm.h.
3.x provides its own embedded driver so you don't need any image to test the unit, in fact you don't even need an SD card !

mamejay, 2022-07-30:
How do you know its working without a SDCARD?

retro16, 2022-07-30:
3.x embeds setup software and a boot driver directly into the STM32 firmware. You can access the setup tool by mashing the Shift+S keys during Atari boot. See the a2setup doc for more info. Of course, to load and save files or do anything useful, you need a SD card.

mamejay, 2022-07-31:
OK.  Did more testing of these boards.  I have always used a STMLink to program the boards and decided to use a serial USB.
My working board program fine with it but when I try with these new Blue Pills I get the follow.

C:\arduino-1.8.5_Portable\hardware\Arduino_STM32-master/tools/win/serial_upload.bat COM7 {upload.altID} {upload.usbID} C:\Users\Jason\AppData\Local\Temp\arduino_build_582505/acsi2stm.ino.bin
Failed to init device.
stm32flash 0.4

http://stm32flash.googlecode.com/

Using Parser : Raw BINARY
Interface serial_w32: 115200 8E1

I suspect something is a miss with these boards.  Any advise?

mamejay, 2022-08-25:
> I just order one from the second link of vitecd, hopefully I will receive the same as mamejay. Once received (usually takes 1 month for shipping where I live) I will test it myself. If I have the same issues, I will try to debug this further, making bad units work would be very interesting.

Did you manage to get your hands on those boards yet?

retro16, 2022-08-28:
Hello, I received one this week from [Mega Semiconductor CO., Ltd.](https://fr.aliexpress.com/item/32377410710.html) and it is useless. Programs fine using serial, but the STE doesn't boot on it. In debug mode, it enters a strange soft reset loop that makes no sense. I didn't check more than that.
For programming issues, maybe reflashing the bootloader with Roger Clark's would restore serial programming: https://github.com/rogerclarkmelbourne/STM32duino-bootloader/blob/master/binaries/generic_boot20_pc13.bin.

mamejay, 2022-08-29:
Far out!  Oh well at least it was not me.  I managed to buy 20 STM chips from LSCS for like $3.5USD but now they are out of stock.  I have just been replacing the chips on the shit boards with the genuine ones and they are working

retro16, 2022-08-29:
For the record, my bad STM32 chip has its text marking way off center and not 100% aligned, the font is also thinner than the other models. Not sure whether it's a sign of something smelly, but it confirms that there are some bad clones.
The PCB and other components were good quality though, it seems that the issue is in the STM32 chip itself.
I will keep this github issue opened as a sort of forum thread so people can give their feedback about their experience.

vitecd, 2022-08-29:
Magics around... Need to buy something fresh and fall to debugging

On Mon, Aug 29, 2022 at 8:48 PM Jean-Matthieu COULON <
***@***.***> wrote:

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

TzOk83, 2022-10-01:
I have recently bought STM32F103CBT6 chips from KINGDEVIL store, and they seem to work fine:
https://www.aliexpress.com/item/1005003586463686.html

Have you verified your BluePills with this:
https://mecrisp-stellaris-folkdoc.sourceforge.io/bluepill-diags-v1.640.html

Recently bought ST-Link V2 clones have some strange Apexmic chip, which rejects to work with SM32 Cube Programmer.

retro16, 2023-06-04:
Dropping a line to indicate that 4.00 works around a very sneaky (and semi-random) hardware bug on the STM32. Many units that didn't work reliably before will work correctly.
Also, to properly test a unit's stability, you can use `ACSITEST.TOS` with the buffer and command tests that spam DMA and command bytes.

It'll keep the issue opened as a reference as it may be an interesting topic for newcomers.

jfceklosky, 2023-07-18:
I have been using these from Amazon without any issues so far with 3.x and 4.x

https://www.amazon.com/gp/product/B07VKSVM21/ref=ppx_yo_dt_b_asin_title_o05_s00?ie=UTF8&psc=1

jfceklosky, 2023-08-20:
These are a another reliable source for asci2stm.

I have personally tested the software with these, version 3.X and 4.X

https://www.amazon.com/gp/product/B0B3X4BH4Q/ref=ppx_yo_dt_b_asin_title_o03_s00?ie=UTF8&psc=1

Thread 29 (2022-08-22):

Odd behaviour with multiple partitions

Eraph, 2022-08-22:
Hello, firstly I want to thank you for putting this together, having a hard disk on an old ST is a dream come true!

I'd like to make use of multiple partitions on my SD card. I use Linux and would like to be able to transfer files between machines so a sector size of 4096 and partition size of 256MB works well here.

What I'm seeing is that when I set up more than one partition on the SD card I start to get errors when creating/deleting directories on any of the partitions.

Creating a directory gives me this error:

> This disk does not have enough room for this operation.

Deleting a directory (dragging to Trash) sometimes gives me this error:

> Invalid copy operation.

Closing the window for the partition and then opening it again shows that the directory is indeed created, but it will never let me delete it.

Using _Quick Partition_ to set up multiple partitions gives me the same problem. My biggest worry here is the reliability of the partitions if I'm getting errors like these when performing what should be simple file operations.

Using the partition tool to remove all partitions but one restores normal behaviour.

I have a 1040 STE with 2MB RAM, TOS version 1.62 and GEM version 0.17.

Cheers!

retro16, 2022-08-22:
Hi Phil, thanks for the feedback it is always appreciated.

This looks like filesystem corruption, it's really bad news. I had this kind of issue during driver development, I thought I removed all these errors before releasing the stable version but that thing is *hard* to program for (the TOS filesystem is weird and full of bugs) !

You have the exact same machine as mine, so it's not your machine.

First things first, could you try running a self-test from the ACSI2STM setup menu ?
Can you give me a rough idea of the amount and size of the files you try to copy before it fails ?

Honestly I have little time to work on this project right now, so don't expect a quick fix in the coming weeks. In the meantime maybe you could another driver if you need reliable writing operations (ICD seems to work on partitions created by the partitioning tool).

JM

Eraph, 2022-08-22:
Thank you very much for your quick response and your suggestion.

I have tried the self-test a number of times, it has always passed successfully.

File sizes aren't particularly big, it seems to especially struggle with creating and copying directories. I've ended up with a few corrupted directories (filenames all garbled, file sizes either 0 or up to 1.4GB, other times a system crash)

 I will try the ICD driver and let you know how it goes.

Does the size of the SD card matter? I've tried 16GB and 64GB (overkill I know, but they're all I had handy)

Eraph, 2022-08-23:
Thanks for the suggestions, I had other issues with the ICD driver and tried P Putnik's driver, which had its own issues.

So what I've done is taken a look at the compile options and adopted some of the slower options. After a flash of the STM32 and a fresh format of the SD card, the situation is improved a great deal, but eventually I run into some corruption. This is what it looks like when opening the partition on a PC:

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

You can see the filenames are almost intact; `SKTOP IN.F` was `DESKTOP.INF`, for example. But I'm pretty sure it wasn't 1.4GB ;)

I'm trying now to set all the compile options to the slowest I can get them. I think this is probably what will help, put it down to my dodgy soldering or unscientific wire clipping. I will keep you updated.

For the record, I have modified the following options:

``` c
#define ACSI_CS_FILTER 3
#define ACSI_FAST_DMA 0
```

Eraph, 2022-08-27:
I met up with some local Atari enthusiasts today, they reckon it's the specific STE model I have. Apparently it's notorious for corrupting partitions.

I'd seen the warning about certain STE models on [Jookie's page](http://joo.kie.sk/?page_id=250), attributing it to a dodgy DMA chip (C025913-38 in my case - the page says this is bad). One of the blokes I saw today reckons a lower power CPU will generate less signal interference, so he's going to help me out with that. I will let you know how it goes.

We did try the ACSI2STM with another ST, there were occasional funnies (TOS Error \#06 or something like that) but nothing like corrupted partitions so I'm hopeful we can fix it on the ST itself.

retro16, 2022-08-28:
Thanks for the very detailed feedback, it helps a lot.
There are indeed suspicions of bad DMA chips, there is also the issue of buffered/unbuffered chips. I am far from being an ST expert, I only test on my 3 machines which seem to have the "good" chips.

I think you have 2 separate issues: TOS/GEM bugs and a DMA transfer issue.

* I also have filesystem corruption on my machine when copying too many folders or files from GEM, I believe this can happens even on legit hardware, I have no solution for that, maybe installing [fixes like FOLDRXXX.PRG](https://www.atari.st/content.php?file=toslist&type=t) may help. This leads to the "Invalid copy operation" message at some point, but no file is corrupt except the last being copied.

* Your screenshot above looks like DMA issues. The way file names look clearly shows that the DMA data transfer is skipping bytes when writing to the STM32. I had similar issues with buggy code in earlier versions but I can't reproduce the issue anymore with 3.x code on my hardware. This may be an issue on the STM32 side, including a bad STM32 chip or yet another very subtle bug.

I just found out that the blue pill board has pull-ups on PA11 and PA12 (for USB operation), this is really bad because it happens to be the DMA synchronization pins. On strongly buffered chips this works usually well, but it may fail on weaker chips.

If you don't mind losing the USB port of your blue pill, could you remove R9 and R10 on the back ? You can either unsolder them, or if you don't mind more expeditive solutions you can just destroy them with small cutting pliers, then clean everything up with a cutter.

About compilation options:
* You can revert ACSI_CS_FILTER back to its default value, this setting is not involved in data transfers (only commands).
* You could try playing around a bit with ACSI_ACK_FILTER, even though this is only for reading the SD card, it may solve some issues.

Eraph, 2022-09-04:
Hello again,

I've installed a low-power 68HC000 processor and it looks like the corruption problem has gone, so that's a great result!

With a single partition I don't seem to have any problems but with two or more partitions I get those "invalid copy operation" errors when copying folders onto any of the drives. Removing the two resistors as suggested does not fix this but hopefully helps to ensure overall stability. `FOLDRXXX.EXE` (renamed to `FOLDR500.EXE`) did not help. I have also reverted all the ACSI2STM options. Could there be a bug in the code when handling multiple partitions from the same SD card? I have my partitions laid out like this with a sector size of 4096 for Linux compatibility.

| Partition | Format | Size (MB) |
| --- | --- | --- |
| 1 | FAT16 | 250 |
| 2 | FAT16 | 250 |
| 3 | FAT16 | 250 |
| 4 | FAT16 | 250 |

By the way, using your partition tool it is possible to choose a partition type of FAT12/FAT16, but it looks like this is totally separate from how a partition is formatted, for example I can format a type 2 partition to FAT16. What does type mean in this case?

retro16, 2022-09-04:
Wow that is very valuable information you provide there. I never had a first hand confirmation that these DMA issues were real and impacting this project, you put so much effort to confirm this. Thank you so much !

About "Invalid copy operation" I still need more time to work on this. It may be a GEM/TOS bug but I still need to do some more tests in a controlled environment (comparing with EmuTOS on real hardware, comparing with other GEM/TOS drivers in Hatari, and comparing with TOS 2.06 which is much better quality).

I can already reply about partition type: my driver simply ignores partition type entirely. My driver just senses partition types based on their content, just like what the Linux driver does. Other operating systems/drivers do use the type field to determine the type of the partition (especially some Microsoft operating systems and some other Atari HD drivers) so it's better if it is set correctly.

Eraph, 2022-09-09:
Hello again,

I've been mucking about with EmuTOS and it handles multiple partitions much better, so could well be a TOS bug but may give you an idea of where to look. Running EmuTOS has its own issues, I can't get it to boot from SD (it hangs on the loading screen but the STM32 shows a flashing activity light) so I've been running it from floppy for now.

Probably unrelated but may be useful for you to know, I tried writing the [EmuTOS Bootloader](https://github.com/czietz/emutos-bootloader) image to an SD card, this boots straight into EmuTOS bypassing the ACSI2STM init screen but as soon as I add another partition it no longer boots automatically. Even removing the new partition to revert it to its original state doesn't help.

retro16, 2022-09-09:
Thanks again for testing that. Now I need to make the self-testing tool better to try to reproduce a similar issue without using TOS, thanks to your testing I know exactly what to test. If my tests reproduce any kind of bug I may be able to fix this issue.

Thanks also for the EmuTOS bootloader feedback. It's indeed another issue related to the partitioning tool (which is far from perfect). it's worth investigating and it looks easy to reproduce on an emulator. It seems that the boot checksum is somehow damaged during partitioning.

I still don't have a lot of time to work on the project so there will be a few weeks of latency before I make some significant progress, so thank you in advance for your patience.

Eraph, 2022-09-09:
Thank you for all your effort! I'd love to see this succeed, it's a great little project. I wish I had the hardware/assembly know-how to help contribute but my domain is more web application development unfortunately! Happy to help where I can even if it's just reporting on problems.

retro16, 2022-09-09:
Okay I had more time than expected during lunch break and I could write a small "disk surface test" utility doing raw access with my driver (running with no TOS/GEMDOS dependency, 100% bare metal code). Results: the driver is 100% stable on my machine while scanning a whole 64MB partition.
Then, based on my GEM/TOS bug suspicion and your encouraging EmuTOS results, I fixed my dual TOS STE.
The test I did was the following:
* Copy my whole C: partition to another partition.
* The source partition contains about 80 directories and 9MB data.
* Copy in one big operation.
* The source and destination partitions are on different SD cards, but this doesn't change anything from a TOS standpoint based on how the acsi2stm driver works.
* Tested on a 30MB target partition (512 bytes sectors) and a 250MB target partition (4096 bytes sectors). All formated with the acsi2stm setup tool.
Results on my machine:
* On TOS 2.06: works perfectly for both 30MB and 250MB partitions. All files look identical to the original. Starting a few programs from the copy is okay.
* On TOS 1.62: First attempt on the 30MB partition ends up with TOS #6 error. Second attempt on the 250MB partition results in "Invalid copy operation" very quickly.

My final recomendation is: do big file operations on a PC and avoid TOS as much as possible.
Saving/loading small documents from within ST applications works well (... at least it works as poorly as it did in 1992). Modifying the STE to support ROM switching between 1.62 and 2.06 is heavily recommended. There are disk-loaded TOS images floating around on the internet, some are okay-ish, others are full of bugs.

Will have a look at this EmuTOS bootloader issue later.

Eraph, 2022-09-12:
Thanks so much for all your efforts so far! I have booted EmuTOS directly from floppy and it seems that I can use all partitions without any problems. That pretty well confirms we're dealing with issues in early implementations of TOS, unfortunately.

Using the floppy to boot into a workable environment is a decent compromise, I'd love it if you could get it to play nicely with booting from the hard drive. I will see about getting alternative EPROMs and making them switchable.

retro16, 2022-09-18:
Had a quick look at this pre-made EmuTOS images, it doesn't look very standard to me:

```Disk sdcard-acsi.img: 948,5 KiB, 971264 bytes, 1897 sectors
Units: sectors of 1 * 512 = 512 bytes
Sector size (logical/physical): 512 bytes / 512 bytes
I/O size (minimum/optimal): 512 bytes / 512 bytes
Disklabel type: dos
Disk identifier: 0x89ff0000

Device           Boot Start        End    Sectors   Size Id Type
sdcard-acsi.img1 *       64     499967     499904 244,1M  6 FAT16
sdcard-acsi.img3          0 1296515584 1296515585 618,2G  0 Empty
sdcard-acsi.img4          0          0          0     0B  0 Empty

Partition table entries are not in disk order.
```
I'm more focusing on the EmuTOS installer right now (INSTALL.PRG provided in the same zip file).

Eraph, 2022-09-18:
I'm not gonna pretend I understand what's wrong with what you showed me there!

I neglected to consider the `.PRG` installer, I'll have to give it a go, could be the solution to all my problems.

Eraph, 2023-05-12:
I recently saw this article which sheds some light on the corruption problem with early STEs, it proposes a solution that can be baked into EmuTOS, but I wonder if you can take any value from the analysis and bring it in to your drivers?

https://www.chzsoft.de/site/hardware/new-atari-ste-bad-dma-investigation/

retro16, 2023-05-12:
Thanks a lot for bringing this very insightful document to my attention.

As you may have noticed, I drastically changed my approch for the future 4.0 release (still a *lot* of work unfortunately), but this document is still relevant anyway.

retro16, 2023-06-04:
Version 4.00 was extensively tested against drive swaps. There is even a unit test for swapping SD cards in GemDrive mode.
GemDrive mode is immune to TOS filesystem bugs due to the way it works. Closing the issue since I don't think it is relevant anymore. Feel free to reopen if you still have the problem or if I misinterpreted.

Closed 2023-06-04.

Thread 30 (2022-08-28):

Wrong BPB

Dunkelwind, 2022-08-28:
Hello,
sysinfo.prg & SED (from Scheibenkleister) reports wrong BPB.
Here are the infos from SED:

```
Anzahl der Zylinder   : 2560
Anzahl der Kpfe      : 35
Breite der Parkzone   : 0
Steprate              : 0
Interleave            : 0
Sektoren pro Spur     : 0
Sektoren insgesamt    : 16777216
Bad Sector List ab    : $000000
Lnge der BSL         : $000000
Rootsektorversion     : 104
Prfsumme             : $1234
Rootsektor von Target 0, Gert 0
    ID   Start  Size  Flag
00      000000  000000  00
```

```
Log.Sec 000000 Cluster 000002 Track    Sektor    Side   Drive C Status -7
000000  60 5E 00 00 00 00 00 00 00 00 00 00 00 00 00 00   `^..............
000016  00 00 00 00 00 00 00 00 00 00 00 00 00 00 00 00   ................
000032  00 00 00 00 00 00 00 00 00 00 00 00 00 00 00 00   ................
000048  00 00 00 00 00 00 00 00 00 00 00 00 00 00 00 00   ................
000064  00 00 00 00 00 00 00 00 00 00 00 00 00 00 00 00   ................
000080  00 00 00 00 00 00 00 00 00 00 0F BD 01 0F B8 07   ...........œ..ž.
000096  48 7A 00 D4 3F 3C 00 09 4E 41 5C 8F 3F 3C 00 12   Hz.Ô?<..NA\?<..
000112  4E 41 54 8F 4A 00 66 22 3F 3C 00 0B 4E 41 54 8F   NATJ.f"?<..NAT
000128  4A 00 67 3A 3F 3C 00 08 4E 41 54 8F B0 3C 00 53   J.g:?<..NAT°<.S
000144  66 2C 70 03 48 40 72 0C 60 2C 76 01 61 06 76 00   f,p.H@r.`,v.a.v.
000160  61 02 60 EE 3F 3C 00 02 3F 3C 00 45 4E 41 58 8F   a.`î?<..?<.ENAX
000176  3F 00 3F 03 3F 3C 00 46 4E 41 5C 8F 4E 75 20 3A   ?.?.?<.FNA\Nu :
000192  FF 9C E0 88 72 0D 2F 00 3F 3C 00 48 4E 41 5C 8F   ÿàr./.?<.HNA\
000208  4A 80 67 00 00 5C 24 40 50 F8 04 3E 2F 0B 47 F8   Jg..\$@Pø.>/.Gø
000224  86 04 43 F8 86 06 32 BC 01 90 32 BC 00 90 11 C0   .Cø.2Œ.2Œ..À
000240  86 0D E0 88 11 C0 86 0B E0 48 11 C0 86 09 26 BC   .à.À.àH.À.&Œ
000256  00 FF 00 88 10 07 80 01 48 40 26 80 08 38 00 05   .ÿ....H@&.8..
000272  FA 01 66 F8 32 BC 00 8A 30 13 51 F8 04 3E 4A 00   ú.fø2Œ.0.Qø.>J.
000288  66 0E 0C 92 41 32 53 54 66 06 26 5F 4E EA 00 08   f..A2STf.&_Nê..
000304  20 78 00 04 4E D0 0D 41 43 53 49 32 53 54 4D 20    x..NÐ.ACSI2STM
000320  33 2E 30 31 20 62 79 20 4A 65 61 6E 2D 4D 61 74   3.01 by Jean-Mat
000336  74 68 69 65 75 20 43 6F 75 6C 6F 6E 0D 0A 47 50   thieu Coulon..GP
000352  4C 76 33 20 6C 69 63 65 6E 73 65 2E 20 53 6F 75   Lv3 license. Sou
000368  72 63 65 20 26 20 64 6F 63 20 61 74 0D 0A 20 68   rce & doc at.. h
000384  74 74 70 73 3A 2F 2F 67 69 74 68 75 62 2E 63 6F   ttps://github.co
000400  6D 2F 72 65 74 72 6F 31 36 2F 61 63 73 69 32 73   m/retro16/acsi2s
000416  74 6D 0D 0A 53 68 69 66 74 2B 53 20 66 6F 72 20   tm..Shift+S for
000432  73 65 74 75 70 0D 0A 00 23 07 C5 6A 00 00 00 00   setup...#.Åj....
000448  00 00 01 00 00 00 20 00 00 00 00 10 00 00 00 00   ...... .........
000464  00 00 00 00 00 00 00 00 00 00 00 00 00 00 00 00   ................
000480  00 00 00 00 00 00 00 00 00 00 00 00 00 00 00 00   ................
000496  00 00 00 00 00 00 00 00 00 00 00 00 00 00 55 AA   ..............Uª
```
Why is the root sector not correct?
```

/* rootsector structure */
typedef struct {
  unsigned char   prg[0x150];   /* bootprogram                                                                  */
  unsigned char   version;              /* rootsector version number            */
  unsigned long   cbhd;       /* Driver magic longword        */
  struct part     extp[8];    /* extended parts SED/ICD/Supra   */
  unsigned int    hi_cc;                        /* cylinders on disk                                            */
  unsigned char   hi_dhc;                       /* number of heads                                                      */
  unsigned char   filler;                       /* unused                                                                                               */
  unsigned int    hi_rwcc;              /* reduced current start                                */
  unsigned int    hi_wpc;                       /* write precomp start                                  */
  unsigned char   hi_lz;                        /* landing zone distance                                */
  unsigned char   hi_rt;                        /* steprate                                                                                     */
  unsigned char   hi_in;                        /* interleave                                                                           */
  unsigned char   hi_spt;                       /* sectors per track                                            */
  unsigned long   hi_size;              /* total size in sectors                                */
  struct   part   p[4];       /* atari hdx<3.0 partitions     */
  unsigned long   bsl_start;    /* bad sector list start                                */
  unsigned long   bsl_count;    /* number of sectors in bsl                     */
  unsigned int    checksum;             /* fixup for $1234                                                      */
    } ROOTBLK;

```

[Top](http://www.verycomputer.com/10_87aafeae5e677b51_1.htm#page-body)

Steffen
Atari STFM. 3MByte, TOS1.04 & 2.06

retro16, 2022-08-28:
Hello Steffen,

The integrated driver uses "modern" MS-DOS LBA partitions and FAT descriptors. The ROOTBLK structure you pasted seems to be for TOS format partitions. These structures aren't compatible with the MS-DOS format so your tools might be confused (I don't know SED).
Structures used by the internal driver can be found in asm/a2stdrv/structs.i

TOS does not require specific on-disk structures, all it uses is the GetBPB system function to return correct pointers to FAT12/FAT16 structures on-disk, but the header can have any format as long as the boot sector has the correct checksum. I chose to use modern MS-DOS structures to maximize compatibility with modern OSes and tools.

I'm not sure whether this answer addresses your issue, feel free to ask more precise questions if you have problems or if you want more information.

JM

Dunkelwind, 2022-09-04:
Hello JM,
tnx for the infos & clarification.
I found out that it is better to use the HATARI image for the HD emulation. This provides the correct BPB.
All the hardware-related software now works (SED, Turboass, Bugaboo....)
I think, deliver only the FAT-pointer is not good enough for a good emulation.
Maybe you could calculate the right BPB on the fly?
But anyway, I'm using the HATARI-image now. Unfortunately, the data exchange is then more complicated
(using HATARI or loop devices)

Steffen

retro16, 2022-09-05:
The BPB is calculated on the fly: all hard disk drivers do that by hooking the GetBPB (the system call documented here: https://freemint.github.io/tos.hyp/en/bios_functions.html). In the case of the ACSI2STM internal driver, the calculation is implemented in _asm/a2stdrv/getbpb.s_.
The tools you use seem to recompute the BPB from structures on disk, but this only works for the partition types they are compatible with. If you want to check the actual BPB returned by the driver (and used by GEMDOS/TOS), you need to use the tool CHKDISK3.PRG provided by the AHDI v6 package. This tool uses the BIOS level interface to show the BPB and FAT structures as seen by the OS filesystem.

Because on-disk formats are more or less specific to their driver, you can't mix low level disk manipulation tools like you would do on PC, you have to use the disk management tool provided by the driver you use, and in the case of the ACSI2STM driver it's its setup tool you start by typing Shift+S at boot or running A2SETUP.TOS.

Now, there is a possibility that the driver actually returns a wrong BPB, and I'm interested in any potential bug feedback. For example, you mention Turboass in the things that don't work, and as far as I know this tool isn't doing low level access. Can you describe a bit more this use-case and how it fails ?

Thanks,
JM

Dunkelwind, 2022-09-09:
OK, here an example for the problem:
SD-Card:
```
Festplatte /dev/sda: 14,87 GiB, 15946743808 Bytes, 31145984 Sektoren
Festplattenmodell: STORAGE DEVICE
Einheiten: Sektoren von 1 * 512 = 512 Bytes
Sektorgröße (logisch/physikalisch): 512 Bytes / 512 Bytes
E/A-Größe (minimal/optimal): 512 Bytes / 512 Bytes
Festplattenbezeichnungstyp: dos
Festplattenbezeichner: 0xecccb2a2

Gerät      Boot Anfang   Ende Sektoren Größe Kn Typ
/dev/sda1           32 524287   524256  256M  6 FAT16
```

show directory with GEM:
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

show directory with Bugaboo:
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

CHKDISK3.PRG:
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

try fopen on Bugaboo to write output to disc:

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

Turboass displays a src incorrectly:
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

Steffen

retro16, 2022-09-18:
Found the issue ! GetBPB is now fixed in the (beta) release 3.1b.
rwabs in physical mode is still known to be wrong, this will be fixed for actual stable 3.10.

Dunkelwind, 2022-09-22:
Hi JM,

I think, v3.10 is buggy too.
Even the HATARI-image stops working properly:

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

V3.01 with HATARI-image works fine so far  I know.

Steffen
Hint:
Manual Turboass says:
6.11 Interna des Debuggers
`Bei Disketten-/Festplattenzugriffen: XBIOS 8/9 beim Lesen/Schreiben eines Sektors,
XBIOS 10/18/9 beim Formatieren,
Bei allen Dateioperationen wird (natürlich) das GEMDOS benutzt.`

retro16, 2023-06-04:
Closing as 4.00 doesn't provide a BIOS level driver anymore.

Closed 2023-06-04.

Thread 31 (2022-09-09):

CID error... is very bad?

emilen72, 2022-09-09:
ACSI2STM SD bridge v3.01

Initializing SD0 ... CID error (36MHz) (fs ok) (rw) (25MHz 3862528 blocks) success
Searching image /acsi2stm/hd0.img ... opened
  0,0: ACSI2STM SD0 IM0   1G

Waiting for the ACSI bus ...

it pass from 36Mhz th 25Mhz for low speed SD? but I get this error with every microSD card... can be a big problem? thanks

retro16, 2022-09-09:
Hi emilen,

The SD signal is probably a bit weak (long wire, power supply noise, ACSI bus noise, or even room lights).
If it works well at 25MHz with no read issue, you are good to go. Speed loss is minimal between 36 and 25MHz.

If you need to lock the SD card at a lower speed, you can set #define ACSI_SD_MAX_SPEED 25 (or even 16 if you want even more stable operation) in acsi2stm.h

retro16, 2023-06-04:
Hi again,
4.00 reworked a lot SD card initialization, and now uses the AdaFruit variant of SdFat, which seems to provide better SD card initialization routines than Greiman's. You should probably check the newer version.
Please provide feedback if the issue is still there.

Closed 2023-06-10.

Thread 33 (2022-12-24):

BOM Details?

VonHirsch, 2022-12-24:
Hello, I was able to generate a BOM by importing the JSON files into EasyEDA, and then generating a BOM csv, but would you happen to have any other details like actual part numbers from a supplier or voltage requirements for the capacitors?  I'm trying to work those things out now, and I thought I'd check if you had something instead of re-inventing the wheel.  Thanks!

[BOM_PCB_ACSI2STM_EasyEDA_2022-12-24.csv](https://github.com/retro16/acsi2stm/files/10298925/BOM_PCB_ACSI2STM_EasyEDA_2022-12-24.csv)

WilsonBradley, 2022-12-25:
Sorry, trying to follow while on vacation. BOM? Not sure what this is about..

VonHirsch, 2022-12-25:
Oh sure yea I can help with that.

> The “Bill of Materials”, commonly referred to as the BOM or electrical BOM, is simply a list. In the case of PCB design, the bill of materials is a list of all the needed parts in the manufacturing process to build that specific printed circuit board.

Source:
https://resources.altium.com/p/what-is-a-bom-in-pcb-design

retro16, 2022-12-25:
Hi @VonHirsch, thanks for reaching out.

There is no "official" BOM for the PCB, but before explaining why, answers to your questions:
* Resistors have no special requirements, anything matching roughly the value will do.
* Capacitors need to handle low power 5V, so anything over 6V is okay. I use off the shelf 0805/1206 MLCC caps.
* The EasyEDA schematic uses a weird part combining the DB19 and floppy DIN pins. I did that to get the exact spacing right when routing.

That being said, the PCB is not really designed for mass-production: some parts need manual adjustment, especially connector pins. Some parts are optional, or even mutually exclusive. I wanted to do something that supports the most diverse kind of parts possible and leave some room for tinkering.

All these choices make producing a BOM a bit pointless IMHO (I may have missed the point though, I am far from being a professional in electronics). To make a true product, the PCB probably needs to be reworked a bit to remove optional bits, make final design decisions, or even integrate the STM32 chip directly on the board to avoid the (not necessary but beneficial) blue pill board modifications.

VonHirsch, 2022-12-25:
Thanks for the answers, very helpful!

Yes, agree about the general customizability of the board build depending on preferences, and the various readme's in the repository cover those areas well.

About the BOM I guess it depends?  For the well outfitted builder pulling all these parts off the shelf it's definitely overkill.  On the other end someone making something like this for the first time could definitely benefit from a list to get them started.

As for me, this isn't my first rodeo, but I also don't have many of these parts on-hand, so I need to make an order from mouser. If the first build goes well I could see building a couple more so I'll end up organizing some sort of list.

If you think it useful I could share the list back when I have it.

retro16, 2023-07-16:
The new JLCPCB assembled "Compact PCB" available in 4.2a will provide a clean BOM from LCSC with all details. It's not blue pill based though (it has its own STM32 schematic).
This PCB is still untested, so 4.20 may or may not include this new PCB depending on test results. If everything works 100%, I will close this issue.

Thread 34 (2022-12-30):

ACSI2STM not showing up

bartszyman, 2022-12-30:
Hi, as for the beginning I'd like to thank you for massive work on this project. I've been following it since some time until now where I've decided to build and compile a code myself. I'm confident with soldering, schematics and general electronics.  To begin I do own 1st gen of ACSI2STM which I bought a while ago from person with nick name "Masteries" and its all ok, working fine. Next I purchased and assembled myself ACSI2SD based onCY8C5468AXI-LP042 and same it is working fine. Currently I've assembled STM32 bluebill and trying to test it with your firmware. I'm starting with 2.30 but tested 2.44 and each time results are same - all 3 of mine 1040STe's they don't see the device. In debug both cards are showing up and tested with 8MHz up to 30MHz - going over is a hit and miss. Debug shows correct card info including hd0.IMG
I have spent way over a month almost every day looking online for solution, I have tried different options in acsi2stm.h #define ACSI_XXX_X  however result is always the same. This time I've decided to ask for help at the source. Can you point me to right direction please :) - the PCB board is build 100% correct following docs here on Github and has been tested for bridges/shorts and continuity about million times :D, additionally I've tested my bluepill by cloning the one iI own from "Masteries" (pinut change + his FW) and yes working OK. I've read about long wires issue so my project is on prototype board with proper DB19 and very shot connections. Power does not use data lines and tested on other ACSI2ST's.
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

bartszyman, 2022-12-31:
***UPDATE*** compiled ver.2.0 and I can see "some- incorrect" info on Atari screen meaning there is communication with device

retro16, 2023-01-09:
Hi Bart,
Thanks for the feedback. It took me a while to answer because ... well ... your case is very well documented but very difficult too.

It seems you stay stuck at "Waiting for the ACSI bus". In v2.4, the condition to exit this state and start interpreting commands is the following:
 * A1 pin high
 * CS pin high
 * IRQ pin high
 * DRQ pin high
 * ACK pin high
 * This state must stay stable for more than 100ms

Version 3.01 is much better in that respect, because it uses the RESET pin.

If you manage to go beyond the "Waiting for the ACSI bus" state, can you try to run "tos/acsitest.tos" found in the release zip file on the STE with the ACSI2STM module plugged in ? You can run the tool from a floppy.

Note: Removing R10 from your STM32 PCB can be beneficial for stability. It's a pullup on PA12 and is known to make the module unstable, especially at power on or reset. Removing the resistor will make the USB port unusable. If you want to use USB for power, you can also remove R9 and R11: these resistors connect USB data lines to the STM32, removing them will completely disconnect USB data.

Another quick note: make sure your SD card module has no logic level adapter: the STM32 works at 3.3V just like the SD card so there must be a direct connection between MOSI/MISO pins and the STM32 (with pullups to 3.3V).

bartszyman, 2023-01-13:
Thanks for the answer. I have tried FW 3.01 but result is identical, I'll try removing R10 resistor as suggested, R9 and R11 are irrelevant to my build since I don't use USB power due to PIN11 5V mod.

wolf10000, 2023-02-04:
Hi, also many thanks from my side for this fantastic development. As bartszyman I also try to build my own ACSI2STM although I do own the unit from Masteries as well and that works very fine. Its just I would like to use other harddisk drivers than the one from PPutnik (Masteries unit needs that) and I would like to use more than one SD Cards on the unit.
I came a little further than bartszyman, my unit detects the SD card and talks to the Atari but shows the following message and on the serial monitor and that's it:

ACSI2STM SD bridge v3.10

Initializing SD0 ... (25MHz 7802880 blocks) success
  0,0: ACSI2STM SD0 F16   4G RB

Waiting for the ACSI bus ...
--- Ready to go ---
ACSI0:

 -- Quick reset --

Waiting for the ACSI bus ...
--- Ready to go ---
ACSI0:

 -- Quick reset --

Waiting for the ACSI bus ...
--- Ready to go ---
ACSI5:4 - Not for us
ACSI5:4 - Not for us
ACSI5:4 - Not for us
ACSI5:4 - Not for us
ACSI5:4 - Not for us
ACSI5:4 - Not for us
ACSI5:4 - Not for us
ACSI5:4 - Not for us
ACSI5:4 - Not for us
ACSI5:4 - Not for us
ACSI5:4 - Not for us
ACSI5:4 - Not for us
ACSI5:4 - Not for us
ACSI5:4 - Not for us
ACSI5:4 - Not for us
ACSI1:4 - Not for us
ACSI0:

 -- Quick reset --

Waiting for the ACSI bus ...
--- Ready to go ---
ACSI0:

 -- Quick reset --

Waiting for the ACSI bus ...
--- Ready to go ---
ACSI0:

 -- Quick reset --

Waiting for the ACSI bus ...
--- Ready to go ---
ACSI0:

 -- Quick reset --

Waiting for the ACSI bus ...
--- Ready to go ---
ACSI0:

I am using the Arduino IDE to program the STM32 with an UART as you suggested, I had to set the serial monitor to 115200 as with 2000000 baud only non readable output was generated.
I also set
#define ACSI_SD_CARDS 1
for now (until I get it working), nothing else was changed in the    acsi2stm.h    file.
In the manual you are mentioning that it is possible to program the STM32 also with the command

    stm32flash -w acsi2stm-X.XX.ino.bin COM1:

I do have an UART which supports 5V and 3,3V (I can actually use either of them, just connecting it to the right contacts on the STM32 board), I suppose the binary file can also be uploaded with the STM32CubeProgrammer ( I use that one normally), but where from do I get the acsi2stm-X.XX.ino.bin file? Or would that one have to be compiled from the sources first?
If you can give any hints I would appreciate a lot

retro16, 2023-06-04:
4.00 should solve all problems mentioned in this issue: it looks like the STM32 hardware bug triggered by newer versions.

@wolf10000, to flash a firmware, STM32CubeProgrammer will probably work (I don't use it myself, but there is no reason it doesn't work). 4.00 will be updatable from the ST itself, so it's the last time you do a painful firmware flash operation anyway.

Precompiled bin files can be found in the release section of github (acsi2stm-4.00-release.zip below the release notes).

Closed 2023-06-12.

Thread 35 (2023-01-16):

C partition is getting corrupted only on STE and strange LED activity

mamejay, 2023-01-16:
This is a weird one.  I have created Version 3 boards and they work perfectly on my 1040STFM
I gave one to my friend that has a 1040STE and it works fine initially but after loading a game that is not in the primary partition it seems to corrupt or wipe that partition.
I am using a ready made disk image from Petari.
Another thing I noticed is that the drive activity LED which is connected to PC13 is showing as slightly lite even when there is no drive activity.  When the drive is accessed it flash at 100% brightness then goes back to say around 50%.  On my 1040STFM it is totally off unless there is drive activity.
Any ideas of what could be the issue?

retro16, 2023-01-16:
Hi, thanks for reaching out.
A weird one indeed ! Nice catch with this half-bright LED, it provides useful information.
The LED is lit when commands are processed. Half-bright would indicate that the STM32 detects incoming commands all the time.

Can you provide a verbose output from this problematic STE ? (recompile with ACSI_DEBUG and ACSI_VERBOSE set to 1)

mamejay, 2023-01-16:
Thanks for that!  I have changed the acsi2stm.h updated the #define ACSI_DEBUG 1 and #define ACSI_VERBOSE 1
It programs up successfully but I get garbage on the serial monitor when I start it out of the Atari.  Getting late here and I will test at the machine but should it show any information if the device is started NOT connected to an Atari?  I will test further when I get home from work

mamejay, 2023-01-17:
[ASCS2STM Output.txt](https://github.com/retro16/acsi2stm/files/10431264/ASCS2STM.Output.txt)
OK.  Tried a different UART USB and managed to get output now.
This is me loading my Petari game image and loading a game.  I also tried to switch off and back on again to make it corrupt the C drive but it did not.
I did manage to get it to corrupt the image on the 3rd try but I could not save all the output from the serial monitor.  Is there a way to capture all of the output?  I used Putty but output is no clean at all

mamejay, 2023-05-14:
Further to my previous posts.  I managed to get a 1040STE PAL model and I get the same half lite led when not being accessed.
Attached is a copy of the schematic I drew up.  What could be the difference with the STe?  I do not get corruption on this model and now I cannot make the existing one corrupt a SDcard.  Just curious about the LED.  Do I need a pulldown resistor or something?
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

retro16, 2023-05-14:
Thanks a lot for the extra feedback.

I think the half-bright LED is because you power it with 5V. PC13 is 0V when the LED is on (this is okay), but it's only 3.3V when the LED is off: when the LED is supposed to be off, you still have 1.7V across the LED, which is barely enough to power it. Powering the LED with +3.3V and lowering R1 to match the decreased voltage should fix the issue.

About corruption, I found a *very* strange hardware glitch on the STM32 during the development of 4.0. It's hit or miss, and it seems linked to code compilation. Maybe it's triggered by some bad interaction with code cache or execution timings inside the STM32, anyway I can't explain it.

How it behaves:
* The glitch pulses the DRQ line, shifting data by 1 byte for the whole DMA transfer. Happens both during read and write.
* The same set of data seems to trigger the glitch at the same place.
* When recompiling the firmware with changes, the odds for this glitch to trigger change completely.

It may explain some of the strangest bugs reported in the GitHub issues here.

Anyway, I changed the low level DMA transfer code in 4.0 to try to work around the glitch, but since it doesn't always happen, I can't say that the workaround is 100% efficient. The price to pay is slower transfers by 5-15%, but who cares ?

Can you try the latest 4.0 alpha release ? The "strict" variant of the 4.0 alpha firmware should be very stable already, maybe you could consider it if it matches your needs. It still has a few known issues, but probably less than 3.02 as far as I know. "strict" is just compiling with #define ACSI_STRICT enabled. You can also switch strict mode dynamically with the BOOT1 jumper just below the firmware flash jumper on the blue pill.

To answer your 5 months old question about capturing serial: I use the good old Arduino serial monitor, which has long enough scrollback for my usage. By default, the speed is 2000000.

mamejay, 2023-05-14:
Thanks so much for that. I didnt realise there was a new release.  I will flash my board and test it out.  As for the LED I will just leave it for now but might hack my test board and feed 3.3v instead of the 5V

TzOk83, 2023-05-22:
This may be a hint or not, but STe has buffers for the ACSI lines, while ST - doesn't. As a result, there is a slight difference in timings between ST and STe. It is worth remembering that ACSI lines should have pull-up/termination resistors.

I slightly regret the decision of dropping the integrated ACSI driver in favor of the unfinished GEMDOS mode. I'd rather go with 2 separate builds. ACSI would be a fully polished, production quality release.

retro16, 2023-06-04:
@TzOk83, now that 4.00 is out, the old integrated driver is completely outdated. GemDrive mode is now finished and works better than everything else I ever used on my machines (including floppy disks because TOS sometimes fails to detect floppy swapping). No regrets dropping the old stuff.

About timings, the "new" DMA code since 2.3-2.4 should not be timing sensitive anymore, it properly samples the ACK and CS lines at timings when data is known to be present. Issues with ACSI2STM were in the STM32 that have hardware bugs in timers: it produced glitches on the DRQ line, shifting data by 1 extra byte. This is hopefully worked around.

I don't have access to an unbuffered ST, nor do I have access to any original ACSI peripheral, so I have no way to check pull-up / termination, but from the documentation I gathered, nothing indicated that pullups were required anywhere.

Closed 2023-06-12.

Thread 36 (2023-01-22):

flashing <disk change> on every opperation on second SD card.

XR4x4, 2023-01-22:
I have an issue where when I double click on a drive partition or folder on the second SD card (drive 1) the ST's desktop flashes up "Disk Change" about 5 times then it will eventually open the drive/folder.

Trying to open a program from that sd card also gives the "Disk Change" flash before doing anything, mostly ending in a file error....

I have an STE, latest firmware for the stm32. SD card in slot 0 works fine. (I have tried multiple sd cards in slot 1)

UPDATE: I just flashed version 2.40 & 2.44 and All is good, working perfectly with the second SD card. (Looks like this issue appeared in 3.0 and any release after it.)

retro16, 2023-06-04:
Hi, sorry for the very long wait as I somewhat missed the notification (my bad).
Anyway, better late than never.
Firmware 4.00 should solve the issue (and many others).

Can you try 4.00 and close the issue if it works ? If it doesn't I'll probably ask for more information.

Thank you for your feedback and your help.

XR4x4, 2023-06-05:
Issue is not present in current version (v4.0)

Closed 2023-06-05.

Thread 37 (2023-02-05):

ACSI_DEBUG=1 build does not fit in 64k Blue pill

S0urceror, 2023-02-05:
Hi, I have build your PCB and am busy setting things up.

I noticed that with the latest versions of your code v3.0.1, Roger Clarks's STM32 library v1.0.0 and Bill Greiman's SDFAT library v2.2.0 the ACSI_DEBUG=1 build does not fit in the 64k. It throws the following error message: `region rom overflowed by 2932 bytes.`

When I do a regular build it barely fits. `Sketch uses 63820 bytes (97%) of program storage space. Maximum is 65536 bytes.`

Do you have any ideas how to get debug output and fit everything. Should I use older versions of the libraries that are a bit slimmer?

Let me know.

S0urceror, 2023-02-05:
Update. If I leave out BOOT_OVERLAY I have plenty of space and it fits with debug messages and verbose logging.

Now I have the following problem that my 1024STFM does not see it during boot. This is the debug log:

```
ACSI2STM SD bridge v3.01

Initializing SD0 ... (fs ok) (ro) (36MHz 15450112 blocks) success
Searching image /acsi2stm/hd0.img ... not found
  0,0: ACSI2STM SD0 F32   8G R

Initializing SD0 ... (0 block) failed

Initializing SD0 ... (0 block) failed

Initializing SD0 ... (0 block) failed

SD0 disabled
Waiting for the ACSI bus ...
--- Ready to go ---
Check media: cached id=F84A6110 real id=F84A6110
Check media: cached id=0 real id=0
Refreshing 1,0:(0 block) No SD card
Check media: cached id=0 real id=0
Refreshing 2,0:(0 block) No SD card
Check media: cached id=0 real id=0
Refreshing 3,0:(0 block) No SD card
[0:8][<0][<0][<1][<0][<0](6 bytes)
Check media: cached id=F84A6110 real id=F84A6110
Read 0 blocks from 1 on 0,0
Success
[>0]
[2:8][<0][<0][<1][<0][<0](6 bytes)
Check media: cached id=0 real id=0
Refreshing 2,0:(0 block) No SD card
Error 3A06
[>2]
[5:8] - Not for us
[6:8] - Not for us
[7:8] - Not for us
[0:0]
```

Tried with both a raw SD and a SD with .img. Looks like the acsi2stm finds it but nothing to see in TOS. BTW. it looks like I have an old version of TOS. Does that matter?

S0urceror, 2023-02-06:
Confirmation TOS1.00 is a no-go.

During start of my 1024STFM it “wrongly” first tries to load 0 blocks starting from block 1 to which acsi2stm replies success. Then no more communication.

Booting from a EmuTOS floppy show the right communication and the harddisk/sd card is visible. In verbose mode it is visible that the boot sequence does a Test Unit, followed by an Inquiry, then fetches the bootsector, etc.

For now I am on my way but probably need to upgrade my TOS roms to 1.4.

Closed 2023-02-06.

Thread 38 (2023-02-13):

TOS 1.00 compatibility?

S0urceror, 2023-02-13:
My 1024 STFM has TOS 1.00.

If I boot EMUTOS from a floppy the ACSI2STM works fine. If I boot TOS1.00 from the built-in ROM the boot sector is not loaded.

Visible in a debug/verbose session is that somehow the command is received wrongly, like so:
```
[8][0][0][1][0][0](6 bytes)
Read 0 sectors, starting at 1 on device 0, lun 0
=> Success [0]
```

But the TOS1.00 code, yes I disassembled it, really sends for LUN 0:
```
[8][0][0][0][1][0](6 bytes)
```
Which is correct. 1 sector starting at 0.

I see in the TOS code that the time-out between bytes is a maximum of 50msecs. Could it be that the STM32 timer4 implementation misses on of the [0] bytes during read?

P.S. hopefully soon I'll receive a TOS1.04 ROM so that I can test it with this one as well.

S0urceror, 2023-02-18:
Okay, I did a bit more digging. I connected a Logic Analyser in between the STFM and the ACSI2STM board.

This is the result with TOS1.00
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

And this is the result with TOS1.04
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

Notice the double A1 line triggering on TOS1.00. I believe this is the reason it doesn't work correctly on 1.00. This is out-of-spec behaviour but unfortunately how it's sending things out. Maybe a newer firmware of the ACSI2STM could be made to ignore this.

But the good news is that on TOS1.04 it is working flawlessly. For now I will work with TOS1.04

retro16, 2023-02-21:
Thanks a lot for this very deep analysis, and sorry for the very high latency (this project is very low priority for me right now).

This double A1 trigger is something I saw in other cases (esp. Putnik's free driver) so it may be worth investigating how I could handle that case "correctly" without killing the new (more stable) quick reset logic of 3.x. Anyway, this is certainly something that can be handled at firmware level.

S0urceror, 2023-02-21:
Thanks for your response. Understand that after a while you have to focus on other things. In my own retro projects this is the same. Nevertheless ACSI2STM is a great project and I thank you for that.

I posted my findings so that they are documented for others as well.

I earlier checked your code to see where this could be fixed but on the other hand I have now TOS1.04 and that entirely fixes things and has much better compatibility with harddrives in general. I don't think I'm going back to 1.00.

retro16, 2023-05-19:
Another user has the same A1 retrigger issue. I will add a workaround in the upcoming 4.0e (it will still be alpha/maybe beta).

retro16, 2023-06-04:
4.00 will positively work with TOS 1.00 as I could reproduce and work around the double A1 issue. Closing.

Closed 2023-06-04.

Thread 40 (2023-05-16):

4.0c firmware missing SHIFT+S

mamejay, 2023-05-16:
Hello again.  I have been testing the SHIFT+S with the latest firmware but it seems to go straight into GEM.
I have no issues with previous firmware.  Has this been omitted?

Also a strange observation.  I have a lot of Blue pills that pass a blink test but would not work at all with firmwares up to 3.  I decided to just try 4.0c and they have now come to life.  Not sure what you did but they seem to be working now which is wonderful as I have a bunch of these which I thought were duds.

Anyway let me know about the Shift+S functionality .
Thanks!

retro16, 2023-05-16:
Hello again.

My old driver, including the setup tool, was removed from 4.0 as it should become 100% useless, and flash space on the STM32 is taken by the new GemDrive driver.

Useful functionality (self-tests and clock setup) will be migrated to regular TOS executables that you can run from the ST desktop (from a floppy or from within the ACSI2STM itself). Partitioning tools will become obsolete as GemDrive requires a PC-formated SD card with a single partition (including support for ExFAT) so just use Windows or whatever PC formating tool for that.
4.0c is still in alpha state, and self-tests are long to write and debug, but I think that it will bring the rock solid operation ACSI2STM desperately needs.

If you have objections against the complete removal of the setup tool, I am always very interested in constructive feedback. Please list what features are useful to you, and how you use it. Can't guarantee that I can bring it back, but I will try my best to fulfill your use cases.

About your Blue Pills working, it's part of that STM32 hardware bug I worked around. Thank you so much for this feedback, it's really important to me because that hardware issue is really semi-random in the worst possible way: when changing code and recompiling, one batch may become good and another may become bad, randomly, without apparent reason. My workaround fixed all the Blue Pills I own, but you never know if there isn't another quirky batch, so the more feedback I have, the more confident I can be in my low level DMA routines.

Closed 2023-06-04.

Thread 41 (2023-05-18):

Cannot enter setup utility/boot issues

bleggett, 2023-05-18:
I've tried with both stable and 3.1 branch.

I cannot get the setup tool to show up reliably (basically, the device to correctly boot) no matter what `acsi2stm.h` setting I tweak.

`ACSI_ACK_FILTER`, `ACSI_CS_FILTER`, `ACSI_FAST_DMA 0 or 1`

The odd thing is that _sometimes_ (thus far, 2-3 times) I can get the ACSI2STM to boot into the setup util successfully. However, even if I change _nothing_, and simply rebuild and reflash the device, it stops booting into the setup util.

Usually what I'll see over serial is the normal device boot logs, then some attempt at DMA transfer, then an immediate `Quick Reset`, eg

```
20:32:15.683 -> DMA send (512 bytes): 10 7 41 FA 0 C6 EA 8 D1 10 48 7A 0 4C 3F 3C 0 9 4E 41 5C 8F 2F 3 26 38 [...]
20:32:15.730 ->
20:32:15.730 ->  -- Quick reset --
20:32:15.730 ->
20:32:15.730 -> Waiting for the ACSI bus ...
```

I see more extensive transfers when the setup util boot actually works.

Not sure why I keep seeing `Quick Reset` after initial DMA transfers.

bleggett, 2023-05-18:
I'm going to try and get serial log dumps from both the success and fail runs.

retro16, 2023-05-18:
Hi,
Thanks for the feedback.

If recompiling changes behavior more or less randomly, it looks like the hardware bug of the STM32 I'm currently fighting in 4.0 development. Can you try 4.0c ? 4.0 doesn't have the setup anymore and GemDrive isn't ready, so you have to use a SD card or an image with an Atari driver already installed (such as ICD or PP).

bleggett, 2023-05-18:
Trying with an image on the SD card and the latest 4.0d release.

```
19:24:33.052 ->
19:24:33.052 -> SD0 36MHz 62685184 blocks rw
19:24:33.052 -> Waiting for the ACSI bus ...
19:24:33.503 -> --- Ready to go ---
19:24:38.613 -> [0:8][<0][<0][<0][<1][<0](6 bytes)
19:24:38.613 -> Read 1 blocks from 0 on SD0
19:24:38.613 -> DMA send (512 bytes): EB 58 90 4D 53 44 4F 53 35 2E 30 0 2 20 7E 8 2 0 0 0 0 F8 0 0 3F 0 FF 0 0 0 0 0 0 80 BC 3 C1 3B 0 0 0 0 0 0 2 0 0 0 [...] OK
19:24:38.613 -> Success
19:24:38.613 -> [>0]
19:24:38.613 -> [1:8] - Not for us
19:24:38.658 -> [2:8] - Not for us
19:24:38.705 -> [3:8] - Not for us
19:24:38.751 -> [4:8] - Not for us
19:24:38.830 -> [5:8] - Not for us
19:24:38.877 -> [6:8] - Not for us
19:24:38.924 -> [7:8] - Not for us
```

this is the log I get.

Image doesn't boot or show up, I've tried various delays and settings as before.

Wonder if I just have a crappy DMA chip or something.

bleggett, 2023-05-19:
> Aha ! 4.0d has a trick up its sleeve: do you have a way to transfer ACSITEST.TOS found in the release package onto a floppy (or any other working drive) and run it from the ST's desktop ? The tool will ask for the ACSI ID (usually 0) and runs a few tests. I will need the log output of the ACSI2STM during the test, as well as the amount of tests that were successful/failed. If all tests work okay, please do a buffer test ('B' key after the normal tests finished) for a few minutes (don't need the log for this one), and a surface test with an unimportant SD card ('S' key, this may corrupt the SD card's data in some rare cases).

Sadly, I do not (yet) - it's a 1040 STF (originally shipped with 6-chip TOS 1.0, I upgraded to TOS 1.04) and the floppy drive as is common is DOA with a (physically busted) head. I have another 1040 arriving soonish I can cross-test with, and I plan to eventually replace the floppy drive.

Either way, will update you when I can try with `ACSITEST.TOS`, one way or the other.

> Also, can you tell me what driver/image you are using ? If you used a publicly available ready-made image, can I have a download link (or search terms for Google if the image isn't 100% legally clean) ?

Using the 1GB image mentioned in the first post here, which AFAIK should work just fine? https://www.atari-forum.com/viewtopic.php?t=41008

> Given the results, I may ask a few more things to have a precise idea of what's happening.
> Thanks a lot for your help, quality feedback like this really supports the project.

Sure thing. Like I said, only I have one (relatively early model) 1040 with a busted FD ATM, but I'm interested in helping where I can, I know this stuff can be pretty trial and error (and Atari ST DMA seems to be historically problematic)

retro16, 2023-05-19:
Oh no, that dreaded free PP driver. It does something wrong with the A1 line at boot, so it doesn't work as-is with 3.X nor 4.X.

4.0e *will* have a workaround, I had one a long time ago in 2.x firmwares, but it was hit or miss. Now that the ACSI implementation layer is *much* cleaner than it was back then, it should be possible to implement the workaround correctly.

A workaround is needed anyway, because TOS 1.00 also exhibits the same bug, and you swapped yourt ROM chips, but not everyone can/wants to do that to their ST.

bleggett, 2023-05-19:
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

I will try a few more images later and report back if that changes anything, thanks!

bleggett, 2023-05-19:
I was able to get some activity via GEMDRIVE mode, weirdly enough.

It's very intermittent though - on some boots, it hangs on the ACSI2STM splash screen:

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

On others, it gets to desktop but seems to randomly freeze on file access.

I did manage to launch ACSITEST a few times - it failed every time.

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

bleggett, 2023-05-19:
I'm wondering if maybe I have a bad RAM chip or something and it's not related.

retro16, 2023-05-20:
GemDrive disables ACSI to avoid conflicts with other drivers, so it's expected that ACSITEST doesn't work in this mode. The last screenshot is correct.

However, the unstability you get is not normal. GemDrive is still alpha at this point, but it's only filesystem operations doing wrong things: During my tests it proved to be very stable in the sense that it always behaves the same (wrong) way. Starting simple programs at the root of the SD card should work 100% of the time.

This indeed looks like hardware issues, whether it's the blue pill, the ST, bad RAM, bad capacitors, bad connections, ... it's virtually impossible to debug this kind of issue remotely (or at least it's something I'm unable to do).

retro16, 2023-05-20:
FYI, I just pushed a pre-version of 4.0e with the workaround for ACSI mode in the *master* branch. ACSI mode is probably final in the master branch, remaining work is only for GemDrive but I won't release 4.0e as a beta as long as there are important issues / missing features in GemDrive.

bleggett, 2023-05-20:
> This indeed looks like hardware issues, whether it's the blue pill, the ST, bad RAM, bad capacitors, bad connections, ... it's virtually impossible to debug this kind of issue remotely (or at least it's something I'm unable to do).

Yep makes sense.

I'm gonna get a diagnostic cart and run some tests, and will try this on an STE when I can.

bleggett, 2023-05-27:
Well good news - I flashed 4.0e and it works!

(I did enable ACSI_STRICT in `acsi2stm.h` but otherwise changed no other consts)

SD cart insertion detection seems a bit fiddly which could be my solder joints, but I can boot images!

Works in the 1040 ST/1.04 TOS and seems to work in the 1040 STE / 1.06 TOS as well.

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

bleggett, 2023-05-28:
FWIW GemDrive so far also seems to work reasonably well.

retro16, 2023-06-04:
I'll have a look at Total Eclipse when I'll have time to work again on the project, it's worth investigating.
GemDrive consumes the least amount of RAM (by far ! because it actually uses the STM32 RAM to store things), but I think the PP driver allocates top RAM which increases compatibility a lot.

4.00 brought some improvements since 4.0e. I'll close this ticket for now, feel free to reopen if 4.00 brings regressions.

Closed 2023-06-04.

Thread 42 (2023-06-04):

Can't see any files on ST, but newdesk.inf is read.

TzOk83, 2023-06-04:
The last 4.0 version in which I see files from SD card in GemDOS mode in Atari Desktop is 4.0e. In 4.0f and final release the newdesk.inf is loaded, but when I open C: disk I see no files at the card.

retro16, 2023-06-04:
Wow, thanks for the super quick update !
To investigate further, I will need your TOS version, and 3 debug (not verbose) logs of 4.00:
* booting
* opening C:
* running TOSTEST.TOS (this one should be huge, but very informative. If you can't post it easily, tell me and I will provide a link to upload it)

retro16, 2023-06-04:
Addendum: I also need to know the format of your SD card (fat / fat32 / exfat, partition count, containing long file names or not, the OS you used to format it and copy files on it).

TzOk83, 2023-06-04:
Sorry but DEBUG build doesn't work at all for me. I got only, and then PC13 starts to fade in-out:
```
ACSI2STM SD bridge v4.00

SD0 36MHz 3913728 blocks rw mountable
Waiting for the ACSI bus ...
--- Ready to go ---
```
It doesn't boot, however.

I tried TOS 1.04, and 2.06, FAT16, and FAT32.

It works, but I see no files in the GEM. However, if I save the desktop, the newdesk.inf file on the card is updated, and the new version is correctly read during boot.

retro16, 2023-06-04:
Okay thanks for the feedback. Will have a look.
It seems that we're going for a 4.01 in very little time, thanks to your feedback.

TzOk83, 2023-06-04:
I tried to compile 4.00 without 8.3 and dot files filtering, but I always end up with non-functional binary (with PC13 behaving like in DEBUG build - fading in and out), and not fitting into 64kB Flash (yet all mine Bluepills have 128kB).

Board: Generic STM32F103C series, CPU Speed (MHz): 72Mhz (default), Variant: STM32F103CB (20k RAM, 128k Flash), Optimize: smallest (default), Upload method: Serial.
```
Sketch uses 77336 bytes (59%) of program storage space. Maximum is 131072 bytes.
Global variables use 12240 bytes (59%) of dynamic memory, leaving 8240 bytes for local variables. Maximum is 20480 bytes.
```

retro16, 2023-06-05:
I didn't test 2.06 for 4.0f/4.00, and the regression was really subtly hidden by bugs/inefficiencies of TOS 1.62, and it wasn't covered by the test suite. 4.01 should fix issues with TOS 2.06 and have much better test coverage.

It is absolutely abnormal to end up with a 77336 bytes long binary. I tried to reinstall everything from scratch following the instructions in "compiling.md"  under Windows just to check if the platform has any impact, and I had practically the same result as the official build from my Linux machine.

XR4x4, 2023-06-05:
I'm having the same Issue (or similar) STE using TOS 2.06

ICD driver SD card in second SD slot and a gemdrive Fat32 2gb in the first slot.

I can copy files  from my ICD SD to the gemdrive SD but cannot see them in the destination window. (0 bytes used in 0 items.)  Putting the SD card in my windows PC I can see the files did actually copy over ok. (this is also with the newer 4.01)

retro16, 2023-06-05:
Thanks @XR4x4 for confirming the issue. I can't reproduce this exact case on my 2.06 STE.

Can you try with an ExFAT SD card in the GemDrive slot ? I begin to suspect an issue with FAT32 long file names in SdFat, but I need confirmation (ExFAT doesn't have long filenames in the sense of the ugly FAT16/FAT32 hack to retrofit LFN).

If it doesn't work in ExFAT mode, I need a (non-verbose) debug trace taken when the destination window is being opened, to see what is the issue with GemDrive itself.

retro16, 2023-06-05:
Oh thanks, it put me on the right track. As soon as the code finds an incompatible file name, it stops scanning. The obvious workaround is to avoid using any long file names (is there a way to prevent Windows from creating its infamous "system volume information" ?)
Maybe compiling with ACSI_GEMDRIVE_HIDE_NON_8_3 set to 0 will work for 4.01 (it didn't for 4.00+TOS 2.06, but who knows ...)

A fix is probably easy, but I really want to implement date/time and unicode character set for 4.10, which may take a week or 2.

retro16, 2023-06-06:
Fixed in 4.10, feel free to close if that's the case for you.

Thread 43 (2023-06-06):

Compilation issues under Windows

TzOk83, 2023-06-06:
Not really an issue with the project itself, but rather with libraries and dependencies. I've spent almost a whole day trying to solve this riddle.

1. You need Roger Clark's STM32 board definition, and you really want the clone of the MASTER repository, rather than the RELEASE version.
2. Do not change the folder name with the HW support files, it has to be called 'Arduino_STM32-master'.
3. You will need an 'arm-none-eabi-gcc' compiler/toolchain, instructions say, to install Arduino SAM boards (Cortex-M3) support, but this installs an outdated gcc 4.8.3-2014q1 version. The much newer version 7-2017q4 is included with Arduino Mbed OS RP2040.
4. After you change/update board/library support you need to close Arduino IDE and purge the Temp folder.

Now your 4.01 binary will be 57500 bytes in Flash, and will use 16408 bytes (80%) of dynamic memory.

retro16, 2023-06-06:
That's a very good finding. GCC 7 is miles ahead of GCC 4.8 in terms of optimization. Will update the doc to reflect that.

retro16, 2023-06-06:
That's now the official way to compile ACSI2STM as it doesn't seem to produce any regressions over the infamous hardware STM32 timer bug, which is my biggest nightmare.

Anyway, 4.10 solved every known problem, I played with it for a day with all the cases I had in constructive feedback, and it's rock solid.

TzOk83, 2023-06-06:
Actually, you can go even further and download the official Arm GNU Toolchain V10.3-2021.10 and put it into a folder 'C:\Users\<User>\AppData\Local\Arduino15\packages\arduino\tools\arm-none-eabi-gcc\10.3-2021.10'. It will work, just like that ;)

https://developer.arm.com/-/media/Files/downloads/gnu-rm/10.3-2021.10/gcc-arm-none-eabi-10.3-2021.10-win32.zip

Closed 2023-06-06.

Thread 44 (2023-06-07):

acsi2stm-4.10 fails to build when using official Arm GNU Toolchain V10.3-2021.10

TzOk83, 2023-06-07:
As in title, 4.01 was compiling using the official Arm GNU Toolchain V10.3-2021.10, but 4.10 ends up with:
```
C:\Users\<User>\AppData\Local\Temp\ccUNI632.s: Assembler messages:
C:\Users\<User>\AppData\Local\Temp\ccUNI632.s:17: Warning: ignoring changed section attributes for .data
C:\Users\<User>\AppData\Local\Temp\ccUNI632.s:28: Warning: dwarf line number information for .data ignored
(...)
C:\Users\<User>\AppData\Local\Temp\ccUNI632.s:278: Warning: dwarf line number information for .data ignored
C:\Users\<User>\AppData\Local\Temp\ccUNI632.s:8055: Error: leb128 operand is an undefined symbol: .LVU76
C:\Users\<User>\AppData\Local\Temp\ccUNI632.s:8056: Error: leb128 operand is an undefined symbol: .LVU76
C:\Users\<User>\AppData\Local\Temp\ccUNI632.s:8070: Error: leb128 operand is an undefined symbol: .LVU5
C:\Users\<User>\AppData\Local\Temp\ccUNI632.s:8082: Error: leb128 operand is an undefined symbol: .LVU7
C:\Users\<User>\AppData\Local\Temp\ccUNI632.s:8094: Error: leb128 operand is an undefined symbol: .LVU8
C:\Users\<User>\AppData\Local\Temp\ccUNI632.s:8106: Error: leb128 operand is an undefined symbol: .LVU10
C:\Users\<User>\AppData\Local\Temp\ccUNI632.s:8118: Error: leb128 operand is an undefined symbol: .LVU11
C:\Users\<User>\AppData\Local\Temp\ccUNI632.s:8130: Error: leb128 operand is an undefined symbol: .LVU39
C:\Users\<User>\AppData\Local\Temp\ccUNI632.s:8131: Error: leb128 operand is an undefined symbol: .LVU53
C:\Users\<User>\AppData\Local\Temp\ccUNI632.s:8132: Error: leb128 operand is an undefined symbol: .LVU53
C:\Users\<User>\AppData\Local\Temp\ccUNI632.s:8133: Error: leb128 operand is an undefined symbol: .LVU70
C:\Users\<User>\AppData\Local\Temp\ccUNI632.s:8134: Error: leb128 operand is an undefined symbol: .LVU70
C:\Users\<User>\AppData\Local\Temp\ccUNI632.s:8135: Error: leb128 operand is an undefined symbol: .LVU76
C:\Users\<User>\AppData\Local\Temp\ccUNI632.s:8136: Error: leb128 operand is an undefined symbol: .LVU76
C:\Users\<User>\AppData\Local\Temp\ccUNI632.s:8137: Error: leb128 operand is an undefined symbol: .LVU77
In file included from D:\<User>\Documents\Arduino\acsi2stm-4.10\acsi2stm\Tos.h:23,
                 from D:\<User>\Documents\Arduino\acsi2stm-4.10\acsi2stm\GemDrive.h:23,
                 from D:\<User>\Documents\Arduino\acsi2stm-4.10\acsi2stm\acsi2stm.ino:23:
D:\<User>\Documents\Arduino\acsi2stm-4.10\acsi2stm\SysHook.h:105:3: warning: converting 'ToWord' to a base class 'Word' will never use a type conversion operator [-Wclass-conversion]
  105 |   operator Word() {
      |   ^~~~~~~~
D:\<User>\Documents\Arduino\acsi2stm-4.10\acsi2stm\SysHook.h:214:3: warning: converting 'ToLong' to a base class 'Long' will never use a type conversion operator [-Wclass-conversion]
  214 |   operator Long() {
      |   ^~~~~~~~

exit status 1

Compilation error: exit status 1
```
4.01 was complaining only about:
```
In file included from D:\<User>\Documents\Arduino\acsi2stm-4.01\acsi2stm\Tos.h:23,
                 from D:\<User>\Documents\Arduino\acsi2stm-4.01\acsi2stm\GemDrive.h:23,
                 from D:\<User>\Documents\Arduino\acsi2stm-4.01\acsi2stm\acsi2stm.ino:23:
D:\<User>\Documents\Arduino\acsi2stm-4.01\acsi2stm\SysHook.h:105:3: warning: converting 'ToWord' to a base class 'Word' will never use a type conversion operator [-Wclass-conversion]
  105 |   operator Word() {
      |   ^~~~~~~~
D:\<User>\Documents\Arduino\acsi2stm-4.01\acsi2stm\SysHook.h:214:3: warning: converting 'ToLong' to a base class 'Long' will never use a type conversion operator [-Wclass-conversion]
  214 |   operator Long() {
      |   ^~~~~~~~
```

TzOk83, 2023-06-07:
Ok, I revert that, V10.3 GCC will compile only if it was first compiled with V7 GCC. On a clean build, it will fail.

Closed 2023-06-07.

Thread 45 (2023-06-08):

Empty second SD slot issue

XR4x4, 2023-06-08:
I'm having an issue where I compile for two SD cards but I am only using one slot.
 (ste 2.06 4mb fat32 SD card)

Most of the time all I get is:

`ACSI2STM SD bridge v4.10

SD0 36MHz 31291392 blocks rw mountable
SD1 no SD
 SD1 no SD Waiting for the ACSI bus ...
--- Ready to go ---`

On the rare occasion it does boot the drive but it takes a long time especially when it gets down to "SD1 no SD" three times.

`no SD

SD1 no SD Waiting for the ACSI bus ...

--- Ready to go ---

Stack canary 1 died. Reviving.

Stack canary 2 died. Reviving.

Stack canary 4 died. Reviving.

Stack canary 8 died. Reviving.

Stack canary 16 died. Reviving.

Stack canary 32 died. Reviving.

Stack canary 64 died. Reviving.

Stack canary 128 died. Reviving.

GDRV0:8 GemDrive boot TOS 206

SD0 36MHz 31291392 blocks rw mountable -> C: ACSI2STM SD0 F32  15G

SD1 no SD SD1 no SD SD1 no SD -> D: ACSI2STM SD1 NO SD CARD

Boot on C: (SD0) forward

GDRV1:8 Ignore non-boot

ACSI2:8 Not for us

ACSI3:8 Not for us

ACSI4:8 Not for us

ACSI5:8 Not for us

ACSI6:8 Not for us

ACSI7:8 Not for us

GDRV0:E GEMDOS Pexec((14 bytes): 0 5 0 E0 9 5D 0 E0 9 5D 0 E0 9 5D): forward ........`

**I know I could compile for just one SD card or always keep two SD's in the slots, just wondering if it was possible to ignore everything SD1 the first time it is detected as empty.**

retro16, 2023-06-08:
Hi, did you use the AdaFruit derivative of SdFat ? It's much quicker at initialization.

XR4x4, 2023-06-08:
Just the normal windows format but I don't think this is the issue here. If I have the two SD cards inserted (gemdos or ICD etc) everything is perfect and fast!, it just doesn't like it if I try to use the acsi2stm without a SD card in SD1 too.

Maybe I should just stick to one SD card then compile asci2stm for one SD or compile it for two cards and keep two cards in at all times.

XR4x4, 2023-06-09:
Ahh, yes I was using Bill Greiman's standard release 2.2.2, I have switched to bill's Adafruit Fork and it's working great. (even with an empty SD1 !!)

I'll close this now. Thank you

Closed 2023-06-09.

Thread 46 (2023-06-19):

No SD Card

ChrisWIP, 2023-06-19:
Ok, the documentation doesn't really have anything on this error at all, to my surprise, but why would 'no sd card' show up?

I have an SD card installed of course, and I've tried three seperate ones. I built with blue pill and the PCB you published. 100k resistor is installed and all caps are surface mount ceramics. I haven't populated any of the floppy part of the board (don't need it).

The self tests for the board all pass fine from the ctrl+s module. I'm running v3.

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

Any help on this would be appreciated!

retro16, 2023-06-19:
Hi Chris, thanks for passing by.

Your issue is rather unusual, as there is not much happening during SD card initialization. It's a simple call to the SdFat library, that just does its thing with the SD card pins, routed straight into SD cards.
As I can see on your picture, you have quite a standard setup that looks good.

Things that work 100% because you already passed self tests:
* The power supply is good
* Connectivity with the ST (DMA chip, hard disk port, ...) is good

To debug this issue, I would do the following (sorry if I'm stating the obvious, you may have done this already):
* Check routing with a multimeter in continuity tester between each pin of the 1st SD slot and their matching SD card pin (see the table in [Connecting the SD cards](https://github.com/retro16/acsi2stm/blob/stable/doc/hardware.md)
* Check for shorts between all combinations of the SD card pins (you can probe on the STM32 side, it's easier)

Also, it would help a lot if you could switch to the official 4.10 debug firmware and provide an output of the serial port. 4.10 changed the SdFat library for Adafruit's variant because it has a different initialization routine, and the debug output may provide clues about what's wrong.

Side note: I had a series of defective SD card ports, hopefully that's not the issue because these things are difficult to unsolder / replace. It's not the most probable cause but I have to let you know anyway.

ChrisWIP, 2023-06-19:
Hi!

Thanks for taking the time to help!

All connections are good, they buzz out fine. No shorts. I put in an SD card extender and buzzed that out on the lengthened end, so I think the slot connectors are good, too.

Installing the new firmware, ehhhh, I can try? I could never get the 3.01 firmware to build, it just compiled trash and the step by step guide wasn't really helpful. In the end I found a prebuilt that worked, is there one for 4?

I have the release file but nowhere I can see is it documented which image I should use, verbose, legacy, etc etc 🤷 Are any of those good for my BluePill?

Serial logging... I'm kinda confused by that: I'm using CUBE to program this device, can I even accept a serial logging output stream with that?

ChrisWIP, 2023-06-20:
Oh! I got 4.10 to install onto the Pill: NO SD CARD is still sadly the order of the day. I guess I'll have to get the serial logging on the go to progress really hey?

retro16, 2023-06-20:
Yes, serial output is a must have. At least "debug", but "verbose" may be required. If you have a 64k chip, strictverbose will work for you, at least to have the initialization phase.

Firmware variants are documented in doc/flashing.md. Also, I'm very surprised you can't build firmwares yourself, the documentation has been tried and verified many times by other people.

Also, if nothing works, it might be needed to test the SdFat samples just in case.

I never used CUBE, this is an Arduino project. If you do things differently from what's in the documentation, I can't guarantee that anything will work at all.

retro16, 2023-06-21:
Thinking about your issue ... another question I have: do you use full size SD cards, or microSD adapters ?

Thread 47 (2023-07-07):

RTC not advancing when USB power disconnected

jfceklosky, 2023-07-07:
I have noticed that the RTC is not advancing when the USB power is disconnected.

I have a lithium ion battery installed and that shows 3.3 volts at the VBAT on the STM32.  The clock retains it's value but it is not running when the USB power is disconnected.

NOTE:  I created a modified version of the hardware, but my connections are exactly the same as the original hardware design.

**PCB Front:**
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

**PCB Back:**
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

retro16, 2023-07-08:
Hi, thanks a lot for your feedback.

Since the clock retains its value, you can be 100% sure that your hardware is correct. The RTC unit only needs some voltage on the VBAT pin to run, all the required hardware is already on the blue pill, there is no trap.

Can you try the RTClock/RTCAdjust sample available in Arduino on your hardware (disconnected from the ST of course) ?
If it works correctly, can you try again ACSI2STM to see if running the sample changed anything ?

I highly suspect that I am missing some initialization somewhere, and that it was properly initialized by running this sample during development.

JM

jfceklosky, 2023-07-08:
I have not had a chance to dig in and test the clockin code, but in here

Arduino_STM32/STM32F1/libraries/RTClock/examples/Test_RTClock

There are examples for the RTC each example does the following:

RTClock rt (RTCSEL_LSE);   // initialise

Which I did not find in the current code 4.10 code base.

jfceklosky, 2023-07-12:
I am still testing the clock using the example here  Arduino_STM32/STM32F1/libraries/RTClock/examples/RTCAdjust
from the required code mentioned on the compiling page.

I am in the process of performing the calibrations, you have to let the device run for over a day to do this.

I wonder if the calibrations will fix the running issues or does the RTC only backup the time and it never runs in the background?

retro16, 2023-07-12:
Maybe the RTCAdjust program will initialize your blue pill correctly, and then it will work with ACSI2STM. At least that's how I explain things.

Anyway, I found the potentially problematic line: acsi2stm/Devices.cpp:193:
`RTClock Devices::rtc;`

Based on what you said, it should be:
`RTClock Devices::rtc(RTCSEL_LSE);`

Not sure why I missed that. Anyway, can you test that change for me since I don't have the issue, and since I am on the move I can't really test. And when I'll be back my ST isn't setup at the moment anyway so I can't really test easily.

If calibration actually works, I will put it in the documentation, it's an important step.

Thanks a lot for your help !

jfceklosky, 2023-07-12:
Yes I found that declaration in the source.  I am away from my St at the moment as well.  I will finish testing out the calibration first and  check that it is keeping time.

Does the rtc run for you when  disconnected from the blue pill and keep time correctly for your st?
What st are you testing with?

retro16, 2023-07-13:
I am testing on a 1040 STE.
The other question, I'm not sure to understand what you mean, so sorry if I state the obvious or if I don't answer correctly.

The RTC runs on the blue pill, powered by the CR2032 battery. As long as there is a voltage applied on the Vbat pin (where the battery is connected), the clock will run and keep track of the current time, even disconnected from the ST or anything else. Calibrating helps with clock precision and drift. The blue pill integrates a standard 32.768kHz clock crystal for this task.

Atari ST models with no integrated RTC (which is the case of many models) don't keep track of the time so you have a small program that runs at boot to synchronize the ST's internal clock with the blue pill's RTC. This is done by the UltraSatan tools or the GemDrive hook driver.

jfceklosky, 2023-07-13:
This all makes sense.

 I just wanted to know if the unit you built is working as designed when it comes to the RTC, that's all.

The current acsi2stm code does need to be updated in the .ino  setup() to use the 32kHz clock which I will test when I am back home.   The default constructor in the RTC code which is what is being used does not use the 32hHz clock.

retro16, 2023-07-13:
Yes, my 2 units behave correctly with my code, but I used blue pills that were already used with samples, so they might be already configured to work correctly. I don't know, that's surprising.

retro16, 2023-07-16:
Should be fixed by 4.2a (still a prerelease because of the new PCB I still didn't receive and didn't test, but the code itself should be as stable as 4.10).

jfceklosky, 2023-07-16:
Thanks for making the update on the RTC.

One question, should the rtc be initialized in the setup() function within the .ino file?

Also I just about have my github repos ready for the boards I created. Both use the original blue pill, but one is DB19 and the other is IDC20 (ultrasatan style).

retro16, 2023-07-16:
No need to initialize in setup(), it should be fine as is. I checked with a new Blue Pill (including a full power cycle) and it worked right away. In fact, the RTC stays initialized because it runs on the CR2032 battery anyway.

About IDC20, I'm interested in that: I added one in my new "Compact" PCB but I'm not 100% sure about the pinout, I couldn't find any official documentation. I made some reverse engineering based on a few pictures and PCBs I could find, but no definitive documentation. Do you have good documentation about the exact pinout so I can double check ? Thanks.

jfceklosky, 2023-07-16:
I will test out the new code on my existing board when I return from vacation, no ST with me here :(.

Here is my repo on the ICD-20.  It is modeled after the official Ultrasatan that I own.

https://github.com/jfceklosky/idc2ribbon

jfceklosky, 2023-07-17:
Since I don't have access to an ST at the moment, I have been testing the Blue pill alone with the RTCAdjust example.
The clock seems to be running fine when disconnected from USB power, but the VBAT hooked up.

I will retest my board with the updated code from the master branch and report back.

Philsan69, 2023-07-18:
Tested versions 4.2a and b.
With ST turned off and PSU connected, my device's clock runs too fast.
With ST turned off and PSU not connected, clock doesn't run.

jfceklosky, 2023-07-18:
Running fast or slow can be a calibration issue.  I am looking at the RTCAdjust example program here to do calibrations.

https://github.com/rogerclarkmelbourne/Arduino_STM32/tree/master/STM32F1/libraries/RTClock/examples/RTCAdjust

Silly question, do you have a battery hooked up?

Philsan69, 2023-07-18:
Thanks for the reply!
The clock runs very fast!

I think battery is hooked up, I'll replace it.

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

jfceklosky, 2023-07-18:
The blue pill I am working with runs behind time wise when running on the battery.

I am using this one from Amazon:
https://www.amazon.com/gp/product/B07VKSVM21/ref=ppx_yo_dt_b_asin_title_o05_s00?ie=UTF8&psc=1

hayesey, 2023-07-18:
just to add to this, I also have the full size board that Philsan69 has. Initially with 4.10 on it but I cannot get 4.2b to work at all. I've tried upgrading using HDDFLASH from the ST and using a USB ttl cable. In either case the acsi2stm is simply not recognised by the ST when it boots. Reloading 4.10 again works fine.

However, my STfm has TOS 1.02 in it so I do suspect that could be the issue since 4.2b appears to work for Philsan69 and he is using the same board. I'm looking into upgrading to 1.04 TOS but it's not straight forward with an STfm with 2 chip ROM.

Philsan69, 2023-07-18:
> just to add to this, I also have the full size board that Philsan69 has. Initially with 4.10 on it but I cannot get 4.2b to work at all. I've tried upgrading using HDDFLASH from the ST and using a USB ttl cable. In either case the acsi2stm is simply not recognised by the ST when it boots. Reloading 4.10 again works fine.
>
> However, my STfm has TOS 1.02 in it so I do suspect that could be the issue since 4.2b appears to work for Philsan69 and he is using the same board. I'm looking into upgrading to 1.04 TOS but it's not straight forward with an STfm with 2 chip ROM.

To upgrade firmware, did you press CAPITAL "Y" (SHIFT+y)?

jfceklosky, 2023-07-18:
I am away from my ST at the moment, so I have not been able to test the 4.2b version yet.

I do have a blue pill on one of my boards with the battery hooked up for RTC testing.

Philsan69, 2023-07-18:
> The blue pill I am working with runs behind time wise when running on the battery.

My device's clock is almost 50% faster (with ST turned on or ST off and PSU connected).
At the moment I don't have a spare 2032 battery.

hayesey, 2023-07-18:
> To upgrade firmware, did you press CAPITAL "Y" (SHIFT+y)?

Yes I'm typing an upper case Y, it proceeds with the update, the ST reboots almost immediately. Also tried the upgrade with my ttl usb cable, I know that method works as it's what I originally used to install 4.10 and what I have used to reinstall 4.10 which is working again.

> My device's clock is almost 50% faster (with ST turned on or ST off and PSU connected). At the moment I don't have a spare 2032 battery.

That seems very fast! Reading up on calibration of the rtc in the STM32, they're talking about drift of a few minutes per month. I've not tested mine yet, I can't really without using 4.2b which I suspect needs a TOS upgrade by me.

retro16, 2023-07-18:
Hello,

This fast clock issue is very strange. Ideally it would be very interesting to probe the 32kHz oscillator to check its actual frequency (with a multimeter, oscilloscope or logic probe).

HDDFLASH is indeed super fast so it's not surprising to have an almost immediate reboot. Its only limitation is that it can't flash firmwares bigger than 64k (I can't recall if there is a size check, I suppose I implemented that correctly ... at least I hope).

4.2a/b should work exactly the same as 4.10 on any TOS between 1.00 and 2.06. If it doesn't, it's an ACSI2STM bug that deserves its own github issue ! 4.2b has changed the way it boots so a regression totally makes sense, but 4.2a is practically the same as 4.10.

retro16, 2023-07-18:
Second message just to say that I will quickly post a 4.11 version based on 4.10 that only includes the RTC fix and nothing else. It's a one liner so it shouldn't take to long.

hayesey, 2023-07-18:
> This fast clock issue is very strange. Ideally it would be very interesting to probe the 32kHz oscillator to check its actual frequency (with a multimeter, oscilloscope or logic probe).

Yes that did occur to me too, I have an old oscilloscope so I'll try that tomorrow.

I'll give 4.11 a try now. I never tried 4.2a.

hayesey, 2023-07-18:
Well, this is very odd. 4.11 doesn't work for me either. I've also noticed that the ones that aren't working for me (seemingly anything newer than 4.10), the green LED doesn't come on when the blue pill is rebooted with the jumper back in default position, with 4.10 it does and then goes off when I power on the ST.

Tried the upgrade to 4.11 using HDDFLASH, then using USB cable. Then reflashed 4.10 using USB and that's back working, 4.10 has never not worked for me!

It's clearly something specific to my setup, Philsan69 above has exactly the same board as me and 4.2a at least works for him.

Are there any differences in compile options between 4.10 & 4.11? I can see from the 4.11 commit that literally the only code change is the addition of the RTC parameter.

Philsan69, 2023-07-18:
Updated to 4.11, thanks.
Clock continues to run very fast (90 seconds instead of 60 seconds) and it doesn't run when PSU is not connected.

jfceklosky, 2023-07-19:
I ran across this closed source product.   It appears to be based on the STM32 aka Blue pill

https://sd4st.uk.to/

On their website they cover and provide a software for RTC calibration

https://sd4st.uk.to/documentation/rtc-calibration-procedure/
and
https://sd4st.uk.to/documentation/rtc-technical-details/

retro16, 2023-07-19:
@hayesey, could you please open another GitHub issue for your firmware upgrade problem ? I really want to understand what happened. Of course I will say the usual developer excluse "no no, I swear, I didn't change anything", but as a matter of fact something happened on my side and I don't want to ignore obscure issues anymore.

If you could also try the debug variant and check its output, that would be very appreciated.

I will try a few Blue Pills I still have in stock to see if all of them run at the correct speed. Maybe I have a bad one too, that would be interesting.

hayesey, 2023-07-19:
I was holding off on doing that as I'm not convinced the issue is the software but since you asked I've raised the issue linked to above anyway.

hayesey, 2023-07-19:
I haven't tried it, I assume it needs the matching hooks in the STM32 firmware to do anything?

Philsan69, 2023-07-19:
Changed battery and now clock keeps the date.
Moreover, when connected to PSU, instead of being 50% faster, it's 6% slower...

retro16, 2023-07-20:
Implementing calibration in the STM32 is technically possible ... if you can do that in less than 200 bytes because I'm out of flash memory (I want to keep the debug variant under 64k).
The other solution is to stop using the less-than-optimal 32k oscillator of blue pills. I chose a quartz that announces a 20ppm precision on the (still not tested) compact PCB so this shouldn't require calibration. You don't need to calibrate a $3 watch, so it shouldn't be too difficult to find a good enough quartz that doesn't require calibration.

These 50%/double speed behaviors look like either uninitialized STM32 registers that take random values (in that case, a RTClock library bug) or a transient hardware fault (oscillator locking on a harmonic of the quartz)

hayesey, 2023-07-20:
> Changed battery and now clock keeps the date. Moreover, when connected to PSU, instead of being 50% faster (with empty battery), now it's 6% slower.

What are the specs of the power supply you're using? The battery you originally had was brand new and from Farnell in the UK (a huge electronics distributor so not some junk from Amazon).

I haven't had a chance to do any more testing or experimentation yet, it'll probably be next week now as I'm away for a few days tomorrow.

Philsan69, 2023-07-20:
Tested original battery with multimeter and it's OK.
I installed it again and now time is saved. Don't know why it wasn't working before.

Now clock with computer on is 18% slower. With other battery it was 5% slower.
With computer turned off clock lost only 22 seconds in 26 minutes.

jfceklosky, 2023-07-20:
Which version of the firmware are you using?
The one with the RTC clock fix?

Philsan69, 2023-07-20:
> Which version of the firmware are you using? The one with the RTC clock fix?

Yes, 4.11

jfceklosky, 2023-07-24:
Back home with my ST again!
I just tested one of my boards with the 4.11 firmware.  The clock is now running when disconnected from the USB power source (with the battery in place).

Thanks for all of the advice and support working to correct this.

NOTE:  I was retesting with a Blue Pill that I was running the RTCAdjust program on prior to flashing with 4.11.

I will take a brand new Blue Pill and just start with 4.11, see what happens, and report my findings

hayesey, 2023-07-24:
> Tested original battery with multimeter and it's OK. I installed it again and now time is saved. Don't know why it wasn't working before.
>
> Now clock with computer on is 18% slower. With other battery it was 5% slower. With computer turned off clock lost only 22 seconds in 26 minutes.

what voltages do you see from both batteries?

I'll do some testing on mine tonight.

jfceklosky, 2023-07-24:
I measured the voltage at VBAT and ground with battery installed and USB not plugged in:

3.22 volts

retro16, 2023-07-25:
This really looks like an uninitialized register. The cheapest quartz wall clocks run very precisely independently from voltage. Most crystals easily reach 50ppm precision if not better, it shouldn't require any kind of calibration - calibration is supposed to be only for the internal RC oscillator.

jfceklosky, 2023-07-25:
I will test with a new blue pill and report out.  I just ordered a batch of new board for builds that I will sell.

The one I updated to 4.11 has been running the clock fine off of the battery when usb power has been disconnected.

jfceklosky, 2023-07-26:
Testing again..

I took a brand new one of these:
https://www.amazon.com/gp/product/B0B3X4BH4Q/ref=ppx_yo_dt_b_asin_title_o04_s00?ie=UTF8&th=1

and flashed with version 4.11 (used the same Gigastone SD card that I have been testing with an HD image on it)

Did the following:
- booted the STe. It saw the device and the HD image
- set the time using us_setcl from Jookie and ran us_getcl to get the time just set
- pulled the USB power from the device (CR2032 was installed on the board hooked to VBAT)
- waited 5 minutes and then pulled the USB power back in
- Booted the STe and ran us_getcl...the clock reported 5 minutes later

 **I would call the changes made in 4.11 around the clock a success!**

jfceklosky, 2023-07-26:
After about 12 hours only running the clock on battery,  the clock is keeping time  very well!

Thread 48 (2023-07-11):

Floppy pins

shift838, 2023-07-11:
I'm having a hard time finding the required items to make the floppy pins, specifically the hollow round pins of the size needed.

Can you point me to where with a link possibly?

jfceklosky, 2023-07-12:
I have not tried these, but you might want to look at these:

https://www.digikey.com/en/products/detail/mill-max-manufacturing-corp/9103-0-00-80-00-00-08-0/7322902

I have used these to make DB-19's for the Atari ST DMA port.

retro16, 2023-07-12:
I use this kind myself: https://www.aliexpress.com/item/1005002924387464.html
Combined with this kind of 2.54mm strip: https://www.aliexpress.com/item/1005003012878518.html

Thread 49 (2023-07-19):

Problem upgrading firmware to newer than 4.10

hayesey, 2023-07-19:
Originally mentioned in here: https://github.com/retro16/acsi2stm/issues/47

I built an acsi2stm using the standard PCB design from this repo and have been using it with version 4.10 with no problems. Firmware originally loaded using a USB-ttl cable.

I tried to upgrade to version 4.2b and then 4.11, in both cases to test the RTC function which didn't work with 4.10 (known bug).

I have loaded the firmwares using HDDFLASH.TOS/HDDFLASH.BIN and using the same USB cable but I cannot get 4.2b or 4.11 to work, the Atari doesn't detect that any hard drive is connected, the gemdos load screen doesn't appear. Also I noticed that the green LED on the blue pill board doesn't light up as it does with 4.10 (and then goes off once the ST is powered on).

I can re-load version 4.10 again and the board goes back to working normally.

I am using the default image: acsi2stm-xxxx.ino.bin in all cases.

I suspect my issue is down to something with my setup or my blue pill board as others using the same board as me (I made 10 and sold the spare 9) are able to upgrade OK.

I am going to try another blue pill board I have (which I bought a couple of years ago and use with greaseweasel).

retro16, 2023-07-19:
Thanks for opening a specific issue and trying so many things already.

I can already deduce this:
* The green LED pattern is very important. If the LED doesn't light up, it means that the ACSI2STM code doesn't run on the STM32 (or at least doesn't run correctly). Turning the LED on is literally the first instruction of the firmware.
* The ST and your board aren't the culprit because the issue appears before green LED. In fact, the green LED should appear even with the Blue Pill completely disconnected (maybe it's a good thing to check).
* You seem to have a consistent behavior between HDDFLASH and USB, so it's not a HDDFLASH issue (thank god ! this thing is **hard** to debug).

As far as I know, there is no compilation change between 4.10 and later, but that still needs to be double-checked. It's not impossible that something was upgraded behind my back.

Can you check the debug firmware (and its serial output) ?

hayesey, 2023-07-19:
Thanks for the info, I will check the debug output but this could be tomorrow now as I have a busy day today.

hayesey, 2023-08-17:
I've come to the conclusion that this issue was down to the "blue pill" board I was using, I've tried another one and that seems to work OK (can load 4.11 on to it). I'll carefully check all the soldering on the original board but perhaps it is a duff board.

I'll close this issue now.

Closed 2023-08-17.

Thread 50 (2023-07-19):

ACSI2STM not showing up on Atari STE

BrettRogersUK, 2023-07-19:
Hi,

I have an Atari 1040 STe, 4MB RAM, Switchable TOS1.62/2.06 and the floppy drive swap MOD (A-B, B-A) so I can boot from external floppy if need be. I've also got a gotek as my main internal drive.

I built your design a couple of days ago but cannot get my Atari to see the module at all. I am powering with the 5v line on my FTDI Serial UART device. I have been testing with the device powered from my laptop USB through the FTDI serial so I can see what's going on.  I am using the Arduino suite v2.1.0. I have installed Roger Clarke's STM32 Library (https://github.com/rogerclarkmelbourne/Arduino_STM32) and the Adafruit fork of the SD Fat Library (v2.2.1). I have tried powering via 3.3v too and also powering the sd card via 3.3v with the same outcome on both accounts.

I have managed to flash the 4.10 firmware and I have the power light and the activity light on when the flashing has finished. When turning on the Atari, the activity light goes out and --- Ready to go --- appears in the serial monitor. I have the BOOT0 and BOOT1 jumpers set to 0 (left) and have reset the device after programming. I have tried writing an image to the sd card with raspberry pi imager. This is the image I've used (https://atari.8bitchip.info/DiskImgPP1.html) and I have also tried adding this image as a file on freshly formatted card in the acsi2stm folder on the card. Either way the Atari doesn't find anything at all. When putting the image on the card in the acsi2stm directory I can see on the serial monitor that it finds the image and opens it but that's about as far as it goes.

I have tried using the ICDPro driver from a floppy disk and using the IDCHECK.PRG on the disk and it doesn't find any devices at all connected to the ACSI port.

I changed the ACSI_SD_MAX_SPEED setting to 8 as I was having problems at 36MHz reading my sd cards (see below). 8MHz seems to work correctly. On the serial monitor I can see it say (this was when I had the speed set to 36MHz before setting it to 8MHz):

ACSI2STM SD Bridge v4.10

SD0 36MHz CID Error 12MHz Searching image /acsi2stm/hd0.img ... not found
3964928 blocks ro mountable bootable
SD1 error error error no SD
SD2 error error error no SD
SD3 error error error no SD
SD4 error error error no SD
Waiting for the ACSI bus ...
--- Ready to go ---

The above was when I flashed a precompiled BIN file using the stm32flash program. That's as far as it goes. I don't get anything else at all.

There are no messages on the screen when I turn the Atari on. When in TOS1.62 there is just the blank white screen until it reaches the desktop. No extra icons on the desktop just the normal A and B drive and Trash basket. In TOS2.06 it goes through the memory check and shows the desktop as normal. There isn't any activity at all on the ACSI device.

I have been trying to get this working now for the last couple of days without success so now I'm turning to you to see if you can help me. See pics below of my build.

Any help you can give me at all will be appreciated. I'm sure I have done all I can now with this. I've double, triple and quadruple checked my wiring to make sure all connections are correct as per your documentation and there are no shorts that I've found when testing with a multimeter. The only thing I haven't done is the resistor MOD to the Blue Pill board that you document about removing resistor R10, R9 and R11. Is this necessary for it to work correctly?

I've had TWO blue pills as I thought one was maybe faulty, however,  the outcome is the same with both. Pics below show the serial monitor output, the front of my board and the rear of my board. I know in the pic of the serial monitor is says not connected, the photo was taken after I disconnected the device from my laptop.

Thank you for all your hard work in bringing this to us.  I hope you can help.

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

jfceklosky, 2023-07-20:
A few questions:

-  What brand SD cards are you using?  Size?
-  How are the SD cards formatted?
-  Do you know if the DMA port on the STE is working?

retro16, 2023-07-20:
Hi,
Already, I can say that your SD card adapter board is very probably designed for 5V Arduino with a logic level adapter in the way. The STM32 is 3.3V, this probably explains issues with the SD card. You should try the SdFat examples provided in the Arduino File menu to solve your SD card issues.
You didn't solder PB1 and PB3..PB5 because your SD card appears read-only and you have 4 extra slots that don't exist.
Can you post a verbose output ?
Can you test using ACSITEST.TOS in ACSI strict mode (BOOT1=1 or the strict-verbose firmware variant) ?
It will be difficult to debug the DMA port without a logic analyzer or a digital oscilloscope.

BrettRogersUK, 2023-07-20:
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

I am using an old Transcend 2GB SD card. I've been searching around for a list of compatible micro sd cards and I did find one somewhere but now I can't find it again.

The SD card has been formatted using GParted as Fat16 and FAT32 on different tries of the card and has also been written to using raspberry pi imager to write the image of the card I downloaded from the 8bitchip website above.

This is the first time I've used the Hard Drive port on the back of the atari ever. I've never had an hard drive for this machine so it's never been used before.

The DMA IC is a known good one named as C398739-001A. Not the so called bad DMA IC. I don't have problems reading from my gotek or from my external floppy drive.

The marking on this particular Blue pill is STM32 / F103C8T6 / GQ294 1998 / CHN GQ 225

the marking of my other Blue pill board is STM32 / F103C8T6 / 991KA 93 / MYS 808 (slashes indicate new lines on the chip)

I have tried both Blue pill boards but get the same outcome with both of them.

jfceklosky, 2023-07-20:
For the SD card reader side.  These also work fine.  They are designed to work with 5v and 3.3v and the include the resistors and caps to work correctly.

https://www.amazon.com/gp/product/B08CMLG4D6/ref=ppx_yo_dt_b_asin_title_o01_s00?ie=UTF8&psc=1

jfceklosky, 2023-07-20:
Yes PB0 (for SD card 1) needs to be connected to ground to enable writing

BrettRogersUK, 2023-07-20:
Have tried it with PB0 connected to GND and I've tested the SD card function as well with the SDinfo test from the sdfat examples on the arduino suite.

These are the results (See pics below)

First pic is of sd card test as you can see its reading the sd card fine.

Second pic is of test on the atari serial output with verbose enabled. V4.10 of the firmware.

ACSITEST.PRG shows a fail as no devices are detected.
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

retro16, 2023-07-20:
Based on the 2nd picture and 3rd pictures you posted (where the whole board assembly can be seen), I think, maybe, you got the pin order wrong on the DB-19.

It's really difficult for me to follow using only 2 pictures with different orientations, but let's agree that pin 1 of the DB-19 connector is the on on the bottom-right corner as seen on the 2nd picture, so it translates to top-right pin on the 3rd picture (back side), and it goes to A8 while it should go to B8. Your DB-19 seems to be horizontally mirrored.

The documentation says "looking at the male connector pins", meaning looking at the side that plugs into the ST. It's always difficult to be very clear about what you mean with pinouts ... If anyone has a better wording, I'm all ears.

BrettRogersUK, 2023-07-20:
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

The back side of the connector (solder side) is numbered with the pin numbers. So difficult to get mixed up with the pin numbers.

Pin 1 of the connector does go to pin B8.
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

retro16, 2023-07-20:
Okay that's it, I was completely wrong :) Sorry for the bad guidance.

Anyway, now the last resort: probing with a digital oscilloscope or a logic probe.

The trace to check is the command start byte: https://github.com/retro16/acsi2stm/blob/stable/doc/protocols.md#command-start-byte-st---peripheral

I typically use the following procedure:
* Boot the ST to the desktop and power on the STM32 (order doesn't really matter). The green LED of the STM32 needs to be off, indicating that the boot process is finished, ready to accept incoming commands.
* Place probes on CS (PB7), A1 (PB6) and IRQ (PA8). The best way is to solder extra pins just like you did on PA9/PA10.
* Set the scope's trigger on the CS pin, on falling edge.
* You need to capture a few milliseconds, maybe less, set your capture time rather short (this may need some adjustments)
* Arm single capture mode
* Reset the ST
* The CS pulse appears a few seconds after the first floppy access on TOS 1.x, after memory test on TOS 2.x
* To do multiple attempts, you just have to reset the ST again

If you only have 2 channels on your scope, proceed by 1st sampling CS+A1, then do a 2nd pass with CS+IRQ.

You should see the CS pulse with A1 low, and shortly after IRQ going low.

* If the CS pulse doesn't appear, or if the A1 line stays up, your ST probably needs repair
* If the IRQ pulse doesn't appear, the issue is on the STM32 side.

BrettRogersUK, 2023-07-20:
OK so I've had it on my oscilloscope (no idea if I've done it right or not I've not had this out for over a year and can't remember how to use it 🤣🤣🤣

Anyhow, this is what I've got showing. Top one in yellow is PB7 and Bottom one in Blue is PB6.l
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

Again, top one (Yellow) is PB7 and Bottom one in Blue is IRQ.
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

No pulse on the IRQ line with looks of it.

Thanks,

Brett

jfceklosky, 2023-07-20:
Question:   Did you double check the DB-19 pin setup?  Make sure you don't have it set up as a female side.

BrettRogersUK, 2023-07-20:
> Question: Did you double check the DB-19 pin setup? Make sure you don't have it set up as a female side.
>
> I have gotten burned by this many times.

Yes quite sure. Followed the pin out table on here and also the connector has the pin numbers on the plastic on the solder side of the connector too so no mistaking which pin for which.

retro16, 2023-07-20:
These traces don't look very good. Voltages seem low (I assume that you used x10 probes so 200mV/div means 2V/div ?) and the A1 pulse has no matching CS pulse.
Some of these lines are shared with the floppy controller, I don't recall the best way to make sure that you are capturing a HD access. I'll do captures myself this week-end to have a fresher memory of how it's supposed to behave.

BrettRogersUK, 2023-07-20:
> These traces don't look very good. Voltages seem low (I assume that you used x10 probes so 200mV/div means 2V/div ?) and the A1 pulse has no matching CS pulse. Some of these lines are shared with the floppy controller, I don't recall the best way to make sure that you are capturing a HD access. I'll do captures myself this week-end to have a fresher memory of how it's supposed to behave.

Yeah, I haven't got a clue now what to do. Floppy drive access both internal and external both work as they should do.

I have NEVER had anything on this ACSI Port before a couple days ago so I'm not sure what it should look like or even if the port has ever worked.

Here's a pic of the mainboard corner area where floppy controller and DMA are
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

retro16, 2023-07-22:
This is a capture on my ST (nothing connected to the ACSI port) following the exact procedure I provided:

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

Top yellow trace is CS (PB7) and bottom trace is A1 (PB6). I have no other CS pulse even on disk access, only extra A1 pulses which don't matter.

BrettRogersUK, 2023-07-23:
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

So does this mean then that there is a problem with the port on my ST? Looking at the schematic by sportnik and the kicad release if the motherboard the two chips that are directly involved with the acsi port are the 74LS244 and 74LS245 IC and then a bank of 68R resistors. If either one or both these ICs have failed for whatever reason could that stop the port from working.

retro16, 2023-07-23:
I'm no expert about the ST internals (I know a thing or 2, and more about software than hardware) so I can't really help much more.
I would recommend to focus on the CS signal as this signal is present at boot even if nothing is connected to the ACSI port and should properly trigger a scope/logic analyzer. If you want to trigger CS pulses easily, you can use ACSITEST.TOS that will trigger a few pulses with a single key stroke, without rebooting the ST each time.

BrettRogersUK, 2023-07-23:
> I'm no expert about the ST internals (I know a thing or 2, and more about software than hardware) so I can't really help much more. I would recommend to focus on the CS signal as this signal is present at boot even if nothing is connected to the ACSI port and should properly trigger a scope/logic analyzer. If you want to trigger CS pulses easily, you can use ACSITEST.TOS that will trigger a few pulses with a single key stroke, without rebooting the ST each time.

So How do I test the CS signal without anything plugged into the port? Do I need to put the scope probe on the actual pin on the port itself inside the ST?

retro16, 2023-07-23:
Personally, I just remove the Blue Pill from the ACSI2STM socket and probe the female connector. Any way will work as long as it's connected.

BrettRogersUK, 2023-07-23:
> Personally, I just remove the Blue Pill from the ACSI2STM socket and probe the female connector. Any way will work as long as it's connected.

OK will give it a try soon. I've packaged my project up and it's ready to send to my dad who has another ST that it should work on. If it works on his then it shows there is a problem with mine. If it doesn't work on his, then I don't know what the problem could be.

On a side note, when I connected Pin 12 of the ACSI to PA15 on the blue pill it didn't really do anything. If I connect pin 12 to the pin marked R on the blue Pill, I got the ready to go signal on the serial monitor.

What is supposed to happen with pin PA15?

retro16, 2023-07-23:
The protocol is described in doc/protocols.md and signal names are in a table in doc/hardware.md.

"ready to go" happens when the ACSI2STM senses a steady logic high on all input pins (CS,ACK,A1)

PA15 senses reset from the ST, it is active low (low = reset, high = run normally). Connecting to "R" (reset) of the STM32 is dangerous because resetting the ST can interrupt SD card operations while PA15 guarantees that everything is flushed before resetting. You can ignore the pin completely and use the "legacy" firmware, but that one is less stable.

If connecting PA15 to 12 kills the STM32, your ST is malfunctioning.

BrettRogersUK, 2023-07-23:
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

I don't suppose you have any images of the prototype you made before going to PCB? Just for comparison purposes.

retro16, 2023-07-23:
I don't have a picture, but there isn't anything fundamentally different from yours: a bunch of wires under a proto board. I used a modified DB25 connector. It used soldered SD to microSD adapters as microSD slots, but apart from that nothing interesting to see.

BrettRogersUK, 2023-07-23:
> I don't have a picture, but there isn't anything fundamentally different from yours: a bunch of wires under a proto board. I used a modified DB25 connector. It used soldered SD to microSD adapters as microSD slots, but apart from that nothing interesting to see.

Ok, No Problem. We'll just have to wait and see what happens with my dad's ST. See if the device works on his computer or not. I should know about Thursday time, if it gets delivered in good time.

I would like to take this opportunity to thank you for all your help. It's really appreciated.

Regards,

Brett

BrettRogersUK, 2023-07-25:
Hi,

Just a quick question. I don't think I've seen an answer in any of the documentation or if it is there I do apologise but what micro SD cards are best to use with the ACSI2STM device? There are so many to choose from.

Thanks,

Brett

Thanks

jfceklosky, 2023-07-25:
I use GigaStone cards without any issues:

https://www.amazon.com/gp/product/B07N78MVFY/ref=ppx_yo_dt_b_search_asin_title?ie=UTF8&th=1

retro16, 2023-07-25:
Anything compatible with the SdFat library should work (it's more a question for SdFat devs !)
I use only reputable brands (Samsung, Sandisk, Toshiba, ...). I tried an old 64MB generic card and it worked well too, it worked at lower speed but it worked nonetheless.
Don't be afraid to use modern SDXC, the software can handle it perfectly, especially in GemDrive mode.

BrettRogersUK, 2023-07-25:
I've built another one today (MK3) and i'm still getting the same thing unfortunately. The reset line is working on PA15, when I turn the machine on it says 'quick reset' on the serial monitor and then I get the 'ready to go', whenever I reset the machine it also says 'Quick Reset' and then I get a ready to go again. Its reading the SD Card as It said that it had found the image hd0.img and opened it. I tied PB0 to ground to make it RW and I get the 'Ready to Go' but that's where it stops again.

I'm gonna wait and see what results my dad has with the one I sent him. Hopefully it will work and then it'll probably mean there is a problem with my STe. Given the floppy works both internally and externally I don't think it could be a problem with the DMA chip. I'll see what I can find out anyway. I'll report back with what happens witht eh device I sent my dad (MK2).  Thanks again!

BrettRogersUK, 2023-07-26:
Just thought I'd leave an update here. The device arrived with my dad who has tried it in his machine and........ it does exactly the same thing as mine. Doesn't get any further than a ready to go signal. When powered on the blue pill has both the red and green lights on. As soon as the atari is switched on the green light goes out, never to return again until the machine is turned off.

So I've now got two units and two atari's with the same problem.  I would have expected at least one unit to work correctly.

I do not know where to go from here now. Can anyone advise what to try next?

Thanks

Brett

BrettRogersUK, 2023-07-26:
> Sorry to hear this. Are you located in the US? Perhaps I can send you a board to test with.

Unfortunately not. I'm in the UK. Thanks for the offer though.

jfceklosky, 2023-07-26:
I mentioned this before, you did double check the pin outs on the db19?  Make sure they are not reversed.

retro16, 2023-07-26:
Sorry to hear that the new one doesn't work ...
Anyway, I reviewed the serial trace of your MK3.
First, things that actually work:
* Stack canary messages are perfectly normal on first boot. It's a crude mechanism to detect stack overflows. As long as you don't see a message like this after the initial power up, you're good.
* SD card initialization is working so PB0, PB1, PB3, PB4, PB5 wiring is good.
* The "quick reset" behavior is also what it should be. It demonstrates that PA15 is correctly wired.
* LEDs work the correct way (green LED turning off when the STM32 is ready to process commands). All signals are connected.
* Your debug trace looks very normal for a first power up.
Now the thing that isn't:
* You should see some activity during the boot of the ST.
* The STM32 is waiting for a CS+A1 pulse but something doesn't work and I don't know what.
Could you try enabling ACSI_VERBOSE (or use the strictverbose prebuilt firmware image) and post its output here ?

BrettRogersUK, 2023-07-26:
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

Here's the thing. I do have verbose output enabled in the acsi2stm.h file. I have ACSI_DEBUG=1 and ACSI_VERBOSE=1 but don't get get anything other than what I already posted up. I'm at a loss as well as it doesn't work in the other STe either no, I can't be that unlucky to have two that don't work with the same problem.

This is the same in both Blue Pill boards I have. Setting Verbose output doesn't really do anything other than what you've already seen in my screenshots. I've had debug and verbose enabled since I started this.

Thanks

Brett

jfceklosky, 2023-07-26:
Can you flash with the binaries from the release on github?

BrettRogersUK, 2023-07-26:
Hi,

Can I just ask does anyone with this ACSI2STM have the so called DMA PULLUP mod on the data bus lines of the WD1772 IC?

The mod is explained here: https://www.exxosforum.co.uk/forum/viewtopic.php?f=17&t=1417

It is part of the manadatory fixes to do on the ST. Looking at the schematic the data lines connect to the LS74245 and come out on the other side of the same IC to go to the ACSI port.

Not sure if his has any bearing on my problem.

Regards,

Brett

BrettRogersUK, 2023-07-26:
> Can you flash with the binaries from the release on github?

Yes I can flash binaries using the stm32flash program that comes with the Roger Clarke library I downloaded.

BrettRogersUK, 2023-07-26:
> I mentioned this before, you did double check the pin outs on the db19? Make sure they are not reversed.

Yep, Checked, double checked, triple checked and all buzzed out. As mentioned before as well the pins are numbered on the reverse side (solder side) of the connector so there is no way I could have got it mixed up. I did one wire and one connection at a time crossing each one off after I had done it following the pin our diagram under the hardware.md file on here.

jfceklosky, 2023-07-27:
The flash looks a lot like what I see, but I am using the one in here:

https://github.com/rogerclarkmelbourne/Arduino_STM32

Arduino_STM32/tools/linux64/stm32flash
stm32flash Arduino_STM32_0.9

I am running out of ideas on my side.   I know there is a whole thread on bad DMA's but to have two of them really seems odd!  I have an 520 STE (upgrade to 4MB and it does NOT have that mod installed) and two Mega ST's that my devices work fine with.

I see you have a TOS switcher board installed (I have the same on my STE as well).  Did you try with 1.62 and 2.06?

Looking at your STM32 board, this looks like one that I could NOT get working.  Mine also had the round reset button on it.  Not sure if the STM32 could be the issue.

BrettRogersUK, 2023-07-27:
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

Well I saw that the stm32flash was included in the library but I couldn't work out how to use it under linux. I just did a sudo apt install stm32flash and it installed it.

I tried going into the tools directory and the folder it was in and using it from there but it kept saying it couldn't find the program called stm32flash.

The thing flashes OK. I've now had two of the blue pill boards and neither of them work. I'm very quickly losing the will to live trying to get this thing working.

By all means it appears that the controller side of things does work from what I see on the serial output, it appears to be initialising the blue pill board, initialising the sd card, reading the sd card, returning the byte size of the byte size of the card etc however its the communication from the ST that's bothering me.

To have two STes with this fault would be just bad luck. I can't see it to be honest. Something is wrong somewhere but I can't quite put my finger on it.

In answer to your question yes I've tried with both 1.62 and 2.06 and get the same thing. There doesn't appear to be any communication at all.

I don't know if you've seen the kicad sciatica and board by Sportnik but these have bee instrumental in me looking at where the pins of the port go and as such have led me back everytime to the 74LS245 and 74LS244 ICs (U307 and U302) on my STe board.

But then the realisation comes that my internal gotek and external floppy work without fault. I don't know if the 245 and/or the 244 ic have anythjng to do with the floppy or not. What I do know is that the data lines go from the 245 to the WD1772 and there's also an hd_enable line that goes from the 245 ic as well to another IC near it (can't remember which one).

But again to have two STed with these faulty ICs is just shear bad luck I can't see it happening somehow.

Which brings us full circle back to the blue pill board. I don't know if I want to spend any more money trying to get this working. It's about £17 for two of the boards from one of those you recommend and that's coming from Amazon US. Something I can t really
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

Thread 51 (2023-07-21):

I must be doing something wrong... Help!

NullArgument, 2023-07-21:
Hello,
I am building an ACSI2STM for my Mega2 ST. I have everything wired up on a breadboard. I can upload the sketch, and the serial monitor shows the SD card as bootable. However, when I connect it to the Mega2 (using a 24-pin cable to the internal DMA port) and power it up, I receive an Invalid LUN error message. My micro SD card is a SanDisk Extreme 64Gb, imaged with Petari's HD adapted games image for TOS >= 1.04 (as is in my Mega2). Do you have any advice, or know why I would receive the Invalid LUN error?

The reason you see all the extra wiring is that I had originally wired up five readers, but I believe the computer USB port doesn't output enough amps to drive more than one, so I removed them from the breadboard.

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

retro16, 2023-07-21:
Hi,
Based on your log output the symptom is very clear: The ST doesn't detect the IRQ signal. It may be a wiring issue but it may also be a logic level incompatibility.

NullArgument, 2023-07-21:
I'll double check my wiring again, but everything looked good. All of the pins on the DB19 have corresponding pins on the internal DMA connector. Any recommendations on specific pins/paths to test?

What do you mean by a logic level incompatibility?

retro16, 2023-07-21:
You need to check the IRQ pin (don't remember what pin it is check docs).
Check wikipedia or something else for logic level compatibility it's difficult to explain on a small message.

NullArgument, 2023-07-21:
You were right. It was both a wiring issue AND the IRQ line. On the internal DMA port the IRQ line is next to the RW line, which is supposed to be not connected. I had accidentally wired the IRQ line to the RW pin. I swapped it to the correct pin and it came right up!

Thank you!

Closed 2023-07-21.

Thread 52 (2023-08-10):

Hardware Version and Software versions confusion

KingDaveRa, 2023-08-10:
Hello,

I'm a bit confused right now. I recently built the External boards via JLCPCB, uploading the files for EasyEDA in this repo. The boards are marked 'rev 1.1'. The firmware and docs mention version 2.x, 3.x, and 4.x, but sort of allude to hardware versions as well.

What I've built isn't working; it powers up and I get a green light on the STM32, but when I power on my 520STe the green light goes out and it's never detected. I've yet to put the serial debugger on it to find out what's going on. But I've also noticed when I disconnect the excternal 5v PSU, if I power on the STe, the ACSI2STM seems to still draw power, but no green LED. Something is very wonky, and I'm not sure if I need to make some mods to it, or if there's something else going on.Just want to make sure I've got my ducks in a row before I start off down the wrong route fixing it!

Thanks in anticipation.

XR4x4, 2023-08-10:
I have the same boards from JLC, Rev 1.1, using firmware 4.11 and two FAT32 formatted sd cards on an STE and all is working well. As long as your bluepills' are good (and is sounds like it's working ok as the green LED goes off) , i'd be enabling serial debug to see what that says.

retro16, 2023-08-11:
Hello @KingDaveRa,
Okay so let me explains how it works. It's a bit messy because of how the project evolved.

There was firmware v1.0 that didn't really work.
Then came firmware v2.x that required a hardware change (rewire 2 pins).
Then 3.x introduced the (optional) reset line. 4.x kept the same hardware as 3.x.

So in terms of hardware compatibility, there are basically 3 versions (1, 2 and 3). Hardware compatibility is now final so it's guaranteed that all future firmware revisions will work on boards that worked on 3.x.

Then comes the PCB. It is compatible with firmware 3.x and up (so it uses the final hardware compatibility). It has its own numbering system (1.0 that never came out officially, then 1.1). There will be the "compact" PCB in the upcoming 4.2 (please don't order it right now it's not fully tested yet and probably doesn't work), same stuff there will be a 1.0, 1.1, ... matching firmwares 3.x and up.

Basically, I make sure that everything is compatible within a single ACSI2STM release package (except for the bleeding edge master branch which isn't expected to work, of course).

It seems that some people have the same strange issue, what you have looks like issue #50 which has not been resolved. I'm still not sure if it's really a bad batch of blue pills or some borderline out-of-spec signal levels that work more or less by chance on most hardware and I'm just "lucky" that it works on all my computers.

KingDaveRa, 2023-08-11:
@retro16 thank you for the explanation, I was worried for a while I'd picked up an old version of the board - I've done it before with other projects!

I did find #50 on my travels and it looked similar, but I was leaning more towards a board issue, but as that seems to be ruled out now - other than me doing somehting really dumb in assembly and my inspection shows nothing - I think it might be related. My STM32s came from eBay, and they've been good in the past. I suppose maybe there are some bad ones out there.

The only thing I've yet to figure out is how to get a serial monitor going on it. I stuck my USB-TTL into it, but the TX/RX pins match, which seems wrong to me, I'd asume they'd swap (TX-RX/RX-TX)? I then had no idea what to do beyond opening PuTTY and monitoring the port, then I didn't know what speed to use! So yeah, at a bit of a loss on that as I've never fully debugged one of these.

XR4x4, 2023-08-11:
If you are using the same USB-TTL adapter as retro16 then leave it set at 200000 but I have a different adapter that I used to use and that one refuses to communicate on anything over 115000.  (make sure it's also enabled correctly in asci2stm.h too)

BrettRogersUK, 2023-08-11:
Hi,

I ordered 3 Blue Pill boards (2 x from Amazon and 1 x from Ebay) and they all don't seem to be working for me. I did purchase a ready made ACSI device (known working) so that I could rule out a problem with my ACSI port in my STE and I sent one of my prototype boards that I built from this project to my dad to test (as you'll probably have already seen in my Issue#50).

I think I've jus got very unlucky to get THREE that just are either fake or theres a defective chip on them.

I did order these on recommendation but they're coming from the US so not been able to test them yet. https://www.amazon.co.uk/dp/B07VKSVM21?psc=1&ref=ppx_yo2ov_dt_b_product_details

I did exactly as you've done here, checked all my connections maybe two or three times. Continunity checked all over using Multimeter and everything checks out. There isn't any issue with my Atari Hardware as the ready made one works flawlessly.

Hope you get it sorted soon!

Thread 53 (2023-08-20):

DB 19 source

jfceklosky, 2023-08-20:
Here is a great printable DB 19

https://github.com/CayMac-Team/DB19

I had these printed at JLCPCB and they look great.

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

I plan on using these with the followin pins:

https://www.digikey.com/en/products/detail/mill-max-manufacturing-corp/3149-2-00-80-00-00-08-0/7740154

jfceklosky, 2023-08-27:
The pins worked well.  Here is what it looks like on my alt board design:

I will be building these up soon if anyone is interested.

Front:
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

Back
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

Thread 54 (2023-08-25):

ICD can't partition ACSI drives with firmware v4.00 and up

retro16, 2023-08-25:
ICDFMT.PRG has its "Partition" button disabled. Works good with firmware 3.01.
Changes to MODE SENSE are highly suspected to be the cause.

jfceklosky, 2023-08-27:
Testing with 4.12 firmware, an acsi setup with acsi2stm/hd0.img, and ICDFMT.prg (ICD 6.55a)
ICDFMT is not able to format and returns $20 error.

I ran the same test with the HDdriver 11.  It was also not able to format the drive, but was able to partition the image into multiple drives without any issues. I was able to install the HDdriver and booting with no issues.  File copies across all of the drives were fine.

The image used for hd0.img was 2GB in size.

retro16, 2023-08-27:
Formatting is not supported as it's meaningless for an SD card (what these tools call "format" is low level format, which isn't possible even on mechanical drives these days). Maybe I could approximate it by clearing a few sectors of the card to wipe the partition table and the backup GPT if present.
After a very long night, I found the issue with ICD: a conflict in GemDrive hooks disabled the "Partition" button. ACSI strict mode solves the issue.

jfceklosky, 2023-08-27:
Makes perfect sense on the formatting side of things.

Thanks for the explanation and the long debugging with the GEMDOS setup.

I will repeat the testiing above with an hd0.img created image with the ICD software to see that ICDFMT.prg  does allow the partitioning to work (ACSI mode).  It probably will be fine since the HDdriver software was.

jfceklosky, 2023-08-27:
I repeated the test above...partitioning does work with the ICD software and an hd0.img file, but I had to switch my device into ACSI mode only.  This confirms the debug you tracked down in the GEMDOS steup.

With ACSI + GEMDOS modes enabled, the ICD software had the partition button disabled.
With ACSI only partitioning  was fine (no button disabled).

Thread 55 (2023-09-08):

There is a simpler and cleaner way to power acsi2stm

Greeniously, 2023-09-08:
In the past they sold external floppydrives powered from the joystick ports, and they typically need 3-400mA during operation but upwards 1000mA when starting the motor.

And the 5v on the joystick ports are fed directly from the PSU.

So I do believe powering ACSI2ST from the joystick ports should work just as well as getting it from the PSU directly.

On STE (and F030 aswell if I had a device in need of a small amount of 5v) I would personally get it from the extended joystick ports (also fed directly from the PSU).

Oh, great project, I've been watching!

//
Greenious/Atari-Forum

retro16, 2023-09-08:
Hi Greeniously,

Thanks for your feedback.
That's indeed a good solution. ACSI2STM consumes very little power anyway. The power jack connector was meant to be connected to any 5V pin of any ST right from the start, by using a custom cable.

The upcoming compact PCB will be powered by a 5V USB-C socket (no complex protocol such as power delivery) so it will still be trivial to modify a USB-C to USB-A cable into a USB-C to ST joystick cable to tap power from the joystick port.

Thread 57 (2023-09-15):

V5.0A Compact PCB pin header?

mamejay, 2023-09-15:
Hi Team,
I am loving the new design V5.0A compact PCB.  I want to install male pins so I can click the unit direct to the back of the ST.
I am just a little confused about which side the male pins connect to.  Is it the parts side? It looks to be the parts side to me.
If that is the case which pins can you use as I am not sure there would be enough clearance with the parts and case installed.
The bom mentioned HDR-M-2.54_1X2 which are just a standard pin header.  On testing the pins I have here are loose and it would fall out.
Thanks

jfceklosky, 2023-09-19:
You might want to consider these:

https://www.digikey.com/en/products/detail/mill-max-manufacturing-corp/3149-2-00-80-00-00-08-0/7740154

I have used these in my alt board builds

https://github.com/jfceklosky/acsi2stm-alt-hardware

mamejay, 2023-09-19:
Thanks for that.  What I am concerned is that the pins look to be installed on the parts side so would need to be pretty long top clear the parts, case and be able to connect to the DB female connector on the ST.
Do you know if the pins come out the back where there are no parts or the parts side?

jfceklosky, 2023-09-22:
Without tracing things out, I think they point out to the component side based on the image here:

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

mamejay, 2023-09-22:
That's what I thought.  The pins will not be long enough to reach the ST from the parts side including a case.

jfceklosky, 2023-09-22:
You can go the IDC 20 route.

I created the follow copied from the Ultra Satan cable

https://github.com/jfceklosky/idc2ribbon

retro16, 2023-09-22:
Hi, the assembled compact PCB is being tested right now (as the "Pre-release" tag indicates). It works very well without modifications.
5.0 is not final because I found a huge library bug in the firmware that makes SD card swapping unstable.

For now, I have a few observations:
* You are supposed to order the part fully assembled. If it doesn't work as assembled by JLCPCB it's a bug, if you wish to assemble it yourself (good luck with these SMD 0402 parts) then you are free to do it but you are on your own.
* J1-J9 are offset to fit in the DB19 holes. It works surprisingly well. Pins suggested by Joe won't work specifically because of this offset.
* The part is thin enough to fit on the back case of a standard STF/STE. It barely fits but it fits.
* The version in the "master" branch has slightly bigger holes for DB19 screws, don't know why the design in 5.0A had wrong holes.
* The 3D printed case needs small adjustments.

Sorry I'm really short on time these days, I really would like to finish that project once and for all, and it seems it will happen before the end of 2023.

mamejay, 2023-09-22:
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

So do J1-J9 pins come out of the parts side?  I would have thought you have the pins coming out of the other side to give you more clearance against the ST.

retro16, 2023-09-27:
All pins are pointing toward component side. Clearance is low, but that's a deliberate design choice:

* JLCPCB only assembles components on one side. I wanted something 100% assembled and ready to go
* It's much cleaner looking when used with no case because the back side is clean
* It's more compact. I wanted the compact PCB to be compact so it makes sense that clearance is minimized

Thread 58 (2023-09-18):

One of 5 boards not starting up.

cebelcher, 2023-09-18:
I had 5 compact boards made by JLCPCB - one of them gives a green LED1 with power but LED2 never comes on orange.  It is identified and flashed just fine by STM32CubeProgrammer.  Any idea where it may be getting hung up so I can complain to JLCPCB or try to fix the (tiny) component?

jfceklosky, 2023-09-19:
I am not sure that the compact board has been 100% vetted yet.

retro16, 2023-09-22:
Hi @cebelcher, thanks for your feedback and sorry for the late reply. Can you try flashing version 4.10 ?
I'm fighting against a random initialization bug in the firmware, it might be a duplicate of #56.

cebelcher, 2023-09-23:
I did try 4.10 on the one of the 5 boards that doesn't seem to boot - the behavior is definitely different - the yellow LED 2 light does blink during boot up (I'm using PPutnik's TOS 1.4), but I do not see the ASCI2STM screen that I do with the other 4 boards, and I do not get a C drive on the desktop.

Not sure if this is bad assembly or a bad component from JLCPCB.

Thanks!

retro16, 2023-09-27:
Difficult to say without doing extensive probing on the hardware (oscilloscope, logic probe, component tester). Anyway, if the behavior is different, something is wrong with the board. Possible issues:
* Bad component
* Bad solder joint
* Solder bridge (too much solder, shorting component leads)
* Clone STM32 chip (I really hope it's not the issue and that JLCPCB is a reliable provider)
* Random initialization bug in the firmware (I'm fighting something like that, but it seems 4.10 is working for everyone having issues)

Personally I built 7 units (including 5 early prototypes, but it's the same schematic, different layout) and they all work beautifully.

diegoparrilla, 2025-01-10:
I’ve assembled 50 boards, and surprisingly, the failure rate remains consistent at 1 in 5.

The device itself appears fine, and I can get it to work after a few minutes of “warming up.”

After investigating the root cause, I haven’t pinpointed the exact issue, but I suspect it might be related to improper initialization of the 8 MHz clock.

I’ve built some test boards to experiment with different capacitance values, and I’m also testing changes to the HSE startup timeout and adding delays to ensure the clock stabilizes. However, I’m still uncertain about the definitive solution.

retro16, 2025-01-11:
Thank you so much @diegoparrilla for your excellent feedback. I have no definitive explanation for what you see. Here are a few elements that could hopefully help you:

 * The board's schematic is basically the same as a Blue Pill (same component values) with extra decoupling capacitors because some SD cards can generate high current spikes.
 * I'm not 100% sure about the crystal oscillator. I took the best one I could find in terms of quality, while keeping package size and price reasonable.
 * I know that the 22pF capacitors around the oscillator are very sensitive parts. I took the value from the Blue Pill. IIRC, the crystal I use doesn't specify values in its datasheet.
 * HSE handling is outside my code. The first thing that happens in my code is turning on the activity LED (done by a global object constructor, well before calling `setup()`).
 * I always had issues with serial output at boot (missing characters) which correlates nicely with your clock initialization suspicions.
 * The board **has** to boot quickly, because it races the ST during boot. That's especially true for units with 5 empty SD slots. We don't have that much time, maybe 300-500ms at best, to be safely ahead of the ST.

diegoparrilla, 2025-01-11:
Thank you so much for your amazing feedback—it’s always a pleasure to collaborate with someone as insightful as you! After digging into the issue, I think I’ve identified the root cause, and it might actually be a relatively simple fix (fingers crossed!).

It turns out the problem doesn’t seem to come from the **HSE initialization**, but rather the **LSE oscillator**. The 32 kHz crystal isn’t starting up properly, and it either times out or never stabilizes. Here are a couple of quick tests that have shown promising results:

1. **Grounding Trick**: If the board doesn’t start, briefly connecting **C8** to **OSC32_OUT** with a ground wire (and then removing it) gets the board to boot. Strangely enough, pressing a finger on top of the crystal also works! But of course, we want a proper, long-term fix.

2. **Increasing Startup Timeout**: Extending the LSE startup timeout has helped in my initial tests, though I haven’t fully validated it yet. Here’s the code I’m using in the `.ino` file:

    ```cpp
    #ifdef LSE_STARTUP_TIMEOUT
    #undef LSE_STARTUP_TIMEOUT
    #endif

    #define LSE_STARTUP_TIMEOUT ((uint16_t)0x8000)  // Example: Increased timeout for LSE
    ```

3. **Capacitor Values**: My calculations suggest that **22pF capacitors (C7 and C8)** might not be the optimal choice for this crystal. **12pF** seems closer to the right value. Why does 22pF still “work”? It’s not too far off, but it could be causing a slight offset. I’ll test 12pF capacitors as soon as I get them. Stay tuned!

### The Curious 1-in-5 Failure

Why does the oscillator fail in about 1 out of 5 cases? My current theory is that capacitor tolerances might be to blame. Capacitors have a +/- tolerance range, and a “worst-case” combination of extremes could make the oscillator fail to start. It’s just a hunch, but I’m hopeful further testing will confirm or disprove it!

### A Note on Boot Times

As you probably know, different Atari systems (ST, MegaST, STE, MegaSTE) have slightly different reset circuits, and their reset times aren’t exactly the same. From what I recall, the reset time is around **0.3 seconds**, which isn’t always enough for some peripherals (as I painfully discover developing the Multidevice and TOS Emulator). TOS 2.06 developers were clearly aware of this and cleverly added the Fuji logo during boot to buy a little extra time.

The tricky part is that STM32 microcontrollers list an average LSE oscillator startup time of **1 to 4 seconds** in the datasheets—much longer than the Atari reset time. So, this might be another piece of the puzzle.

Thank you again, @retro16, for all your incredible work! I’m a big fan of what you’re doing, and I’ll absolutely submit a PR once I’ve confirmed these changes and gotten everything working smoothly. Let’s keep making cool stuff for our Ataris!

diegoparrilla, 2025-01-11:
Here’s a quick update: all of my previously failed boards (10 in total) started working perfectly once I removed the capacitors **C7** and **C8**. With the standard firmware, there was no need to increase the startup timeout, and the startup time is excellent.

It seems that the stray capacitance from the PCB and pins alone is enough to make the oscillator work, which suggests that **C7** and **C8** might be significantly off from the ideal values.

I’ll continue testing once I receive the 12pF capacitors and share the results! 😊

retro16, 2025-01-11:
Thank you so much for all your work. Since there will be hardware changes, I'm also switching to 0805 components for the crazy people who want to solder components by hand (I don't judge, we are all crazy anyway, running ST's in 2025 ...)

For now, I put some 12pF caps but I'll wait for your feedback before sending a new test batch for PCB v1.1

I'm also thinking about doing a "super compact" board, with no RTC battery, only 1 or 2 SD slots, no IDC SATAN port and only the UART header for firmware programming.

All that will land in the next stable version.

jfceklosky, 2025-01-11:
I am one of the crazy people that like to solder small stuff :)

Thanks to all for your work on this project!

Biker1bob, 2025-01-12:
I also have boards I bought through JLCPCB. I am having failure to boot on several of them.. and inconsistent boot on the one I did get to boot. This is very interesting. Is there a way we might modify existing PCBs? I got them to build the boards... Was way cheaper than I could do it.

TzOk83, 2025-04-03:
Start with removing **C7** and **C8**, as suggested by @diegoparrilla ...

BrettRogersUK, 2025-04-21:
Hi, I've also got a board that doesn't want to boot. I have removed C7 and C8 from the board but it hasn't changed anything. It still won't boot up. I built my boards by hand, I used the sources from v5.0 and changed the cap and resistor sizes to 0805. I have programmed the board but only get the following out of the serial port.

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

I have opened my own issue about this.  [https://github.com/retro16/acsi2stm/issues/96](url)

Thanks in Advance.

diegoparrilla, 2025-04-21:
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

Your board is booting, which means the crystal circuit is working. Incorrect capacitors there would prevent it from booting entirely and cause it to halt. I’d suggest checking other areas of the PCB for your issue.

Biker1bob, 2025-04-21:
Do you use the square pins for the ACSI port? I found on some machines.. and different days mine (pcbway batch of 5) will exhibit the exact same thing. Also found my STE much more picky than the STFM.. no idea

BrettRogersUK, 2025-04-21:
> Do you use the square pins for the ACSI port? I found on some machines.. and different days mine (pcbway batch of 5) will exhibit the exact same thing. Also found my STE much more picky than the STFM.. I think it's poor connection possible issues.. as they work sometimes.

Yes I did use the square pins. I might change to the IDC20 connector as I've got a DB19 connector I can use on my DIY version.

jfceklosky, 2025-04-22:
Here is what an assembled version looks like that created and built:

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

jfceklosky, 2025-04-22:
Here is the repo for it:

https://github.com/jfceklosky/idc2ribbon

jfceklosky, 2025-04-22:
Here are the DB 19 and the hoods

https://github.com/CayMac-Team/DB19

https://www.printables.com/model/323670-parametricka-krytka-na-dsub-konektor

BrettRogersUK, 2025-04-22:
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

Thanks @jfceklosky I will definitely have a look at those. I wasn't too sure about the square pins and the round machine pin ones were too thin and wouldn't make good contact.

Ill have a look at those pins on your github and get some. DB19 connectors are like rocking horse poo nowadays so it's nice that there is a DIY version to keep stuff like this alive.

Thanks again!

Biker1bob, 2025-04-25:
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

So I see you soldered these in a pcb - is the pcb a STD 1mm hole? Most pins I find are either too small to fit the hole, or if I find one - its exactly 1mm and wont fit.. yours fit your pcb.. but is your pcb a std D-sub pin hole of 1mm?

jfceklosky, 2025-04-25:
Yes I soldered those pins right to my ICD board.

The pins do fit and the printed DB19's will fit, but it is tight fit

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

BrettRogersUK, 2025-05-12:
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

Hi, Ordered some of your boards and some pins so hopefully they will be here soon and I'll be able to test them. Quick Question though. I've resorted to using one of my old boards with the blue pill on (recommended by yourself (HiLetGo ones)). I've put v5.1 on there and it's reporting the SD Card as Read Only even though the pin PB0 is tied to ground. It says it with the LEGACY firmware too. When I put v4.10 on the card is found as RW. It doesn't seem to make any sense. I've changed the number of SD Cards to 1 as well seeing as I only have the one anyway.

Write lock is currently set to 2 in the Acsi2stm.h:
#define ACSI_SD_WRITE_LOCK 2

From The serial Monitor:
ACSI2STM 5.1b by Jean-Matthieu Coulon
GPLv3 license. Source & doc at
 https://github.com/retro16/acsi2stm

        SD0 50MHz 62333952 blocks ro id0 1 F1ED33DE id0 0 cached image /acsi2stm/hd0.img not found
id0 0 cached mountable id0 0 cached

Waiting ACSI ...

Any idea what may be causing this at all? I'll let you know how I get on with the boards.

Regards,

Brett

jfceklosky, 2025-05-12:
I am not sure what's going on in your case.

Both of my boards work fine with the 5.0 firmware.
Here are my two test boards:

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

jfceklosky, 2025-05-14:
@BrettRogersUK

I just updated the first of my boards above to firmware 5.1b (acsi2stm-5.1b.ino.bin) using the TOS updater program and it is working just fine.  The jumpers are on and the SD is writeable and it is working as expected.

BrettRogersUK, 2025-05-14:
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

It looks like I'm probably have to dismantle my boards made with the bluepill boards and redo them from scratch.

I've made my own issue (found here) with screenshots of the serial monitor output etc.

https://github.com/retro16/acsi2stm/issues/96

It's really weird. The Masteries version works perfectly but it's based on old firmware. I don't really see why the old one would work and the new one won't work.

Thanks,

Brett

jfceklosky, 2025-05-14:
@BrettRogersUK

Both of my boards work as designed, but when I made these, I was still learning how to build PCB's (still not an  expert by any stretch of the imagination).
Both of the boards need a refreshed Gerber with copper plating on both sides.  This is on my to do list.   I also converted the boards to use the new EasyDA Pro from JLCPCB.

BrettRogersUK, 2025-05-14:
> [@BrettRogersUK](https://github.com/BrettRogersUK)
>
> Both of my boards work as designed, but when I made these, I was still learning how to build PCB's (still not an expert by any stretch of the imagination). Both of the boards need a refreshed Gerber with copper plating on both sides. This is on my to do list. I also converted the boards to use the new EasyDA Pro from JLCPCB.

My original bluepill versions are still prototype board versions with wires connecting everything up. I've been over them with a fine tooth comb and buzzed everything out pin for pin and it all checks out with the hardware page on here and pin outs. I've even run the SdFat examples from arduino to confirm the sd card can be read and that all works. Just when it plugs into the port on the atari I don't get anything at all on the screen and the serial output shows the sd card is there but nothing coming back.

It's very weird because those bluepill versions I made HAVE been working.

Regards,

Brett

BrettRogersUK, 2025-05-17:
> [@BrettRogersUK](https://github.com/BrettRogersUK)
>
> Both of my boards work as designed, but when I made these, I was still learning how to build PCB's (still not an expert by any stretch of the imagination). Both of the boards need a refreshed Gerber with copper plating on both sides. This is on my to do list. I also converted the boards to use the new EasyDA Pro from JLCPCB.

Hi,

Just thought I'd let you know that I got your DB19 to IDC20 boards made and also some compact boards made and populated by JLCPCB.

They arrived today. At first the JLCPCB board didn't work. The lights were on but no one was home. Upon checking the PCB I found a small sliver of solder bridging two of the address pins together on the STM32 chip. Removed this and jow I got a working Hard drive for my Atari. I actually prefer to use the IDC20 cable.

Thanks again for all your help. Much appreciated. I'm just waiting on your boards coming now for the STM32 bluepill boards agan with the IDC20 connector. It saves plugging and unplugging the DB19 connector all the time. So when those come I can get them out of the prototyping boards I've got them in proper PCBs so I've got plenty of things I can use. If they work then they work, if they don't at least my compact versions work 😀.

Again, thanks for your help.

Kind Regards,

Brett

BrettRogersUK, 2025-05-18:
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

Hi Joe,

That's Great!! I shall keep your githubs in my favourites.

Quick question, does your activity light on your devices stay on when you turn the ST off? My compact versions that do actually work don't have the activity light lit when the ST is off and I get a problem reloading when I next boot boot up. Unless I switch off the unit and reconnect power and turn the ST on again it boots back as it should detecting both my SD cards (one ACSI and one Gemdrive). Am I actually missing something? I've got the 5.00 firmware loaded.

Kindest Regards,

Brett

jfceklosky, 2025-05-18:
Here is what I see on my IDC 20 to asci2stm:

**Power to board using micro USB, ST off**

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

**ST on and booting:**

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

**ST off and Micro USB power to board:**

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

BrettRogersUK, 2025-05-18:
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

Hi Joe,

Pretty much what I'm seeing with mine. First oic is initial power up, 2nd pic is when ST on and booting and third pic is when ST is off.

However after the third pic, when switching mine on again it doesn't detect a SD card in slot 2 any more. I can switch the ST off, pull the USB-C power and reconnect it, switch the ST on and I get both SD cards available again. Weird. But they do still work that's the main thing. I suppose if power is coming from the ST itself then it would be switched off anyway when the ST is off. Might have to look into USB power from the ST.

Maybe one of those side cartridge USB power doodads I've seen.

Thanks anyway.

Brett

BrettRogersUK, 2025-05-29:
Just a quick note. Bought these from Aliexpress. They fit really well and they also fit in place if the square header pins on the compact board also.

100 500 Pcs Male PCB Pin Header Press-Fit Tip 1.0 1.3 MM Diameter Brass Plated Gold 1u Tin 1.0 Bias Connector 9.5 14.5 15.0 mm
https://a.aliexpress.com/_Ewgm9qK

I got the 1.0 x 9.5mm brass ones. They do work a treat.

jfceklosky, 2025-05-29:
Thanks for the link.  I
 need more pins and if these work that would be great!

BrettRogersUK, 2025-05-29:
> Thanks for the link. I need more pins and if these work that would be great!

I used them on your adapter board and also tried them on the compact board where the square header pins go and they fit in there too. They fit very well in the acsi connector on the atari as well.

Thread 59 (2023-10-21):

BAD-DMA in STE finally confirmed and fixed.

TzOk83, 2023-10-21:
A bug in DMA controller behavior in early STE machines have been finally confirmed, described and fixed. Credits go to the Christian Zietz. You can find all the details at https://www.chzsoft.de/site/hardware/new-atari-ste-bad-dma-investigation/

An original topic, with a DMA fixer PCB is available here: https://forum.atari-home.de/index.php/topic,17461.0.html

lismarc, 2024-10-06:
The SCSI2STM device we built works correctly with STF but does not respond at all with our STE.
To solve problem we pull-up data bus on WD1772. There is change that now we have two bombs on boot if ASCI2STM is connected.

For sure we have "faulty" C025913-38  in STE.

Do you think the problem seats in BAD-DMA chip? Is there chance the DMA fixer PCB solve it?

TzOk83, 2024-10-07:
STfm and early STe use the same C025913-38 DMA chip. For sure, there is a bug in the DMA cycle, but it is in both machines, the only difference between STfm and STe is that STfm has no buffers on the DMA port, so the timings between STfm and STe are slightly shifted. The DMA bug can be avoided in software drivers and should not affect hard disk detection.

Is your device using the built-in GemDrive driver or one of the 3rd party ACSI drivers?

P.S.
Try deleting DESKTOP.INF from your SD card, will this make your STe to boot?

lismarc, 2024-10-07:
I've tested my device with both modes: ACSI and GEMDRIVE. Always the same result - 2 bombs on boot.
Same result after removing all manifests files DEKSTOP.INF form SD.

You told the ACSI port in STF and STE differs the STE has additional buffer, is it possible the buffer IC is damaged?

TzOk83, 2024-10-08:
There is a slight chance of that. These chips are U302 (74LS245) for databus and U307 (74LS244) for control signals.

Thread 60 (2023-11-28):

Mega ST internal card

timmcross, 2023-11-28:
Great project!  I made my own and got it to work with the 1040s and 520s I have.  I also noticed there is a MegaSTE pcb board that uses the internal ACSI header on the Mega.  Even though it says MegaSTE, I am assuming it also works with the Mega ST (not the STE)?

timmcross, 2023-11-28:
Ah, ok, nvm.  I see now that the MegaSTE uses a 30 pin internal connector where the Mega ST only has a 24 pin connector.  And the pinouts are different.  Perhaps I will look at spinning a separate board for the MegaST... :(

Thread 64 (2024-01-22):

3D printed compact cases at JLC

MichiganSynthWorks, 2024-01-22:
Greetings, great work on this!

I know its a bit early but I figured some feedback from JLC may help this along, I just submitted the files for printing there and there are issues getting them printed at JLC:

1: each file could only support 1 part (shell) for printing
2: the overall wall thickness of your model is too thin, which will be definitely cracked and damaged. Please kindly check and modify your design to submit a new order. Thanks ! We kindly suggest increasing the wall thickness of the partial thin areas at least to 0.8mm, and the overall wall thickness at least to 2.0mm, which will be better. Thanks !

spawnerbr, 2024-07-22:
@MichiganSynthWorks where did you get the STL files from the case?

MichiganSynthWorks, 2024-07-22:
It was posted on the repo but looks like its been removed
_______________
Michigan Synth Works
5702 Honey Creek Cir
Haslett, MI 48840
248-716-0496
MichiganSynthWorks.com

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

methanoid, 2024-12-05:
[https://www.thingiverse.com/thing:6841627](url)

Maybe you can tell me if ordering assembled boards from JLCpcb they do the DB19 connector/pins? When I experimented with placing an order it didnt show in the render as being connected which suggests its not in the BOM/PickPlaCE files?

Thread 65 (2024-01-24):

Mother board revision is : CA400329à GX 211 VO 3489 TOS 1.62 With v5.0a & Gemdrive Not detected at all

p0ke, 2024-01-24:
Hello,

I have the latest PCB design and the original bluepill one, both works more or less like a charm but on one of my atari, the one I use, it is not detected at all (motherboard CA400329à GX 211 VO 3489 ).
I wait lot of time, 2 leds flash up (orange and red), and never shutoff, while atari is taking lot of time before showing up with A & B drive icon on desktop.
I have been doing couple of hardware check on Atari :

- I tested the HDD port with multimeter : no issue
- I tried to switch with another DMA from an Atari that works : same results
- I Tried another 74LS245N (the one in front of the port) : same results
- I Tried HDD diagnostic tools but those never found the device.

I don't know what I can do next.
It is like it does not exists at all.

I'm quite noob on this project. I don't know how to debug acsi2stm hardware.
I have USB UART device I could plug (and I did but got nothing in monitor from the arduino board).

Any help would be much appreciated.

Thanks

p0ke, 2024-01-25:
Could someone tell me what makes turn off orange led ?

p0ke, 2024-02-11:
Have been setting up the device in debug mode.
It says "-> Waiting for the ACSI bus ..."
I will try to tweak the firmware, and search hardware issue.

Biker1bob, 2024-06-04:
This is the same issue I was having. I found it is the square pin headers we use now. The port connection is not the best. Try some isopropyl into the port.. maybe some dielectric grease (improves connection) I have had this on one or two machines where round pin devices work perfectly.

fplanque, 2024-08-29:
@p0ke I have the same issue. Were you able to solve it?

Thank you.

p0ke, 2024-09-04:
Hello François, not yet.
I have no clue except that it is probably linked to the fact it is not a true 1040 ste.
(That is only supposition)

Cheers p0ke

Le 29 août 2024 04:42:07 GMT+02:00, Francois Planque ***@***.***> a écrit :
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

fplanque, 2024-09-05:
In the meantime, I followed @Biker1bob's advice and paid a lot of attention to the contacts.

That definitely solved one of my original issues. But I have many more to get this to work properly. My [ACSI2STM adventure from contact issues to driver issues](https://www.fplanque.com/dev/retro/atari-st-acsi2stm-mega-ste/) is here.

fplanque, 2024-09-05:
Which is sad because IMHO this is a more elegant solution (and cheaper) than the Ultra Satan...

Thread 68 (2024-03-17):

acsi assignment

wolf10000, 2024-03-17:
Hi, I built succesfully some ACSI2STM units (based on my own PCB with full size SD adapters) with 5 SD slots.
In some cases the SD card has to be inserted in SD slot 0 by force otherwise it won't work. This is for example the case to make the MSDOS hardware emulator VORTEX Atonce 286 work.
Would it be possible to allow any of the 5 SD slot to become SD slot 0? Or even to assign any ACSI ID to any slot randomly?
This could be done in the source code, compiled and the necessary binary could be installed directly from the Atari (as this is now possible).
This is just an idea from me, I don't klnow if it really can be done.
Many many thanks to retro16 for the wonderful ACSI2STM development, the perfect documentation and all your efforts.

retro16, 2024-12-08:
Hi, sorry for the very long delay, I somewhat missed your message.

While this use case seems absolutely legit, I'm fighting against flash size limit on the STM32 to add any feature.

So whatever the solution may be, it must be done at compile time.

You could recompile the firmware 5 times, altering SD slot mapping for each compilation, and reflash from HDDFLASH.TOS to do the switch.

If you are interested, slot mapping can be found in `acsi2stm/Devices.cpp`, in the `SdDev Devices::sdSlots` array. For example, you could swap pin names (second and third parameters, `PA?` and `PB?`).

JM

Thread 69 (2024-04-07):

ACSI2STM with GOTEK

Perceval78980, 2024-04-07:
Hi everyone,
Maybe the question asked many times, I have an ACSI2STM which works fine and a GOTEK wich works fine too.
If I start my atari 520ste with gotek only it's OK.
If I start with ACSI2STM only same thing.
But if I boot on ASCI the gotek is hidden and not work.
Wellington, how to install floppy disk image software in my partition hard disk?

p0ke, 2024-04-07:
Hello,
Did you try to recap your psu ?

p0ke

Le 7 avril 2024 15:01:28 GMT+02:00, Perceval78980 ***@***.***> a écrit :
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

Perceval78980, 2024-04-08:
Hello. Goodyear news.
I replaced my microSD with autoboot  by another one empty juste format in fat32.
Next  plus acsi2stm with this new card and start Atari without USB key in the GOTEK.
Next step mount peripherals for show the C partition.
Next Step plus USB key incident the GOTEK and choose image disk.
Then copy files from A to C. Or installer software from A to C.
And for the PSU  no.
When I bought the Atari, it seems like new one inside. It was à miracle. Just à little yellowing on top case and key caps.
Thanks for your response.
If you have a tips for working autoboot  in C with Gotek I will be very happy.

Thread 70 (2024-05-29):

UART on 5.0

Biker1bob, 2024-05-29:
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

Sorry it is not clear to me - DO I want 5v? or no? I have given pics of how my jumpers are wired.  Nothing on 5v.  TX<>RX and GND and 3.3v and VCC on USB and both on 3.3 on header.

Is this correct??

James

Biker1bob, 2024-05-30:
Pinout of the adapter:

* 5V
* VCC (linked to 3.3V or 5V by a jumper)
* 3.3V
* TXD
* RXD
* GND

What does this mean?? DO I want a jumper from VCC to 5v? I assume I hook up all the pins but the 5v? or do I hook them all up?? if so I cant put a jumper on anything.. SO this makes no sense.. Can I just get a diagram. I am using HW-597 as you can see in the picture.

If I just plug it in - 5 wires as above in STM32cubeProg. I get Error Activating device.  OF course I do not have the flash jumper on because I am using the CH340 device.

Biker1bob, 2024-05-30:
So I wired it up without the 5v pin on both ends. put the flash jumper on. It worked.  Not sure why in the instructions you say that it does not need the flash jumper.

p0ke, 2024-05-30:
I would say that you don't need vcc.

Le 29 mai 2024 21:45:33 GMT+02:00, Biker1bob ***@***.***> a écrit :
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

retro16, 2024-12-08:
It's either 5V or the flash jumper, both do the same thing. But you have to ensure that 5V comes before 3.3V, which is the case with the "official" UART adapter mentioned in the documentation.
Closing this issue.
JM

Closed 2024-12-08.

Thread 71 (2024-05-30):

Forum? Discord?etc.

Biker1bob, 2024-05-30:
I have a v5.0a that now I cannot get to work at all. Do you want that kind of thing here? Is there a forum/thread/discord..etc..etc.. that I can get help with this?
It is a JLCpcb built board.

James

fplanque, 2024-08-30:
Indeed it would be nice to enable the "Discussions" tab for this repo.

Thread 72 (2024-06-02):

5.0a and PC Seed HW Emulator

luciust, 2024-06-02:
I'm trying to get the 5.0a working with Sack's PC Speed emulator. It is a hardware addon with v30 NEC CPU and it also uses the Atari HDD but with it's own driver (https://www.atarimania.com/pgesoft.awp?version=23201).

The emulator seems to be aware of ICD and C'T drivers (has also MULTI option reffered in the link above), but it seems that it does not recognize the HDD at all - DOS 5.0 fdisk says that the are no fixed disks in the system. At the same time the controller from SH204 with BlueSCSI 1.1 attached as HDD - is recognized.

I'm using the standard default FW, but now while writting - let me try te strict version...

luciust, 2024-06-02:
Nope, the strict firmware doesn't work eiter. Willl the verbose firmware give me some chance to see how the emulator is tring to access the ACSI2STM?

luciust, 2024-06-02:
Well, scratch that - getting the strict firmware and choosing the MULTI as HDD driver in PC Speed - solved the issue!

Thread 74 (2024-06-06):

Atari STE - 2 bombs

francouai, 2024-06-06:
Hi guys,
I'm using this ASCI2STM since few weeks now and it doesn't work like I wanted.

On my 1040STE 4mo RAM, it works fine during the first 15mns/20mns (when it is hot) but when I reset it, I'm getting 2 bombs during the boot'up process. If I switch OFF/ON, I have the same problem.
To clear these 2 bombs error message, I have to wait 5mns...

I'm using this interface with External RPI PSU and I have already changed my microSD card. (I have the same problem without the SD card)
I have no Idea what DMA version I have.. need to open it to check.
For sure, it is not a ASCI2STM problem, since this card works perfectly on my 1040STF.
I also tried to another 1040STE and got exactly the same bombs issue.
Any help/fix will be nice. thanks!

[ERROR SHOWED](https://github.com/retro16/acsi2stm/assets/79473174/d826905a-3640-44be-96de-f63cfbcc0efb)

francouai, 2024-06-06:
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

francouai, 2024-06-11:
Fixed by using a "good" DMA..   but it is not logic to have this kind of problem by using "bad" DMA.
2x STE are not compatible with ACSI2STM card.

francouai, 2024-10-12:
I used another STE with the "Good" DMA (C398739-001A) and no more problem at all since this day.

retro16, 2024-12-08:
5.00 provides PIO mode for broken/bad/buggy DMA chips.
Closing this issue.

JM

Closed 2024-12-08.

Thread 75 (2024-07-23):

ACSI2STM GemDrive not working with Atari Mega STE cache?

phjanderson, 2024-07-23:
have an ACSI2STM with 2 SD cards, one in native TOS format with ICD PRO, another in FAT32 with GemDrive. This worked fine on my Atari Mega ST.

It doesn't seem to work correctly when I connect it to my new Atari Mega STE however. It seems that it runs fine on 8mhz and 16mhz without cache, but it hangs accessing the drives with cache enabled. Everything seems to work fine so far if I disable GemDrive completely using the jumper, even with cache enabled. So it seems that the GemDrive driver causes the trouble. I tried both the 4.12 and 5.0a firmware, no difference.

I'm wondering: is the ACSI2STM GemDrive support incompatible with the Mega STE cache or is there perhaps something wrong with my Mega STE?

I have a C398789-001 DMA controller, which supposed to be the "good" version, if I understand it correctly.

fplanque, 2024-08-30:
@phjanderson I also have issues trying to get ACSI2STM to work with the Mega STE. I have the ACSI2STM in GemDrive mode by default.

I actually just took out my Mega STE after 30 years (thinking it's about time to backup its internal drive) but I think I forgot a lot about how to configure things...

Can you please tell me:

- How you disabled cache?
- How you switched to 8 MHz?
- If you have an internal hard drive on the mega STE, were you able to use it concurrently with the Mega STE?

Thank you so much for your help !!

phjanderson, 2024-08-30:
@fplanque  This is an issue report, not a help forum, so I will try to keep it short and more in the context of workaround information for others experiencing this issue.

> * How you disabled cache?
> * How you switched to 8 MHz?

By default the Mega STE boots in 8mhz with cache disabled. The "official" way to control the cache is through XControl. So by changing the speed and cache in XControl (and saving it!) or by completely disabling XControl by renaming it to acx should bring you back to 8mhz after a reboot.

XBoot can also control the cache, so check your boot profile if it has cache enabled.

I wrote my own programs to control the CPU speed and cache instead:
https://github.com/phjanderson/MSTE_CC
But that won't help you much at this moment as you cannot copy them to your Atari without a working GemDrive.

> * If you have an internal hard drive on the mega STE, were you able to use it concurrently with the Mega STE?

I think I briefly tried it with both enabled, not sure. I believe the Atari HD has SCSI ID 0, so you need to change the jumper settings of the ACSI2STM to start on ID 1. The ACSI2STM documentation has information about the jumpers.

If you have more questions, I recommend you to make a posting on atari-forum.com or another Atari forum. Good luck!

phjanderson, 2024-08-30:
@retro16 the Atari Sidecartrige GemDrive implementation does work on a Mega STE with cache enabled, here is the code he uses:
https://github.com/sidecartridge/atarist-sidecart-gemdrive/blob/main/src/gemdrive.s

Search for MEGASTE_SPEED_CACHE_REG to see how and when he controls the CPU speed / cache. Perhaps this information is of help to you.

retro16, 2024-10-27:
Hi, sorry for the late reply, ACSI2STM was on hold and I have a few week-ends free to try to reach a stable 5.00.

GemDrive used self-modifying code so it was not compatible with CPU cache. 5.0c removed that so it should work now.

fdanapfel, 2025-02-03:
@retro16 Hello, I just got the MegaSTE internal version of ACSI2STM and I'm getting the same issue when using a SD Card in GemDrive mode with both the 5.00 and also the 5.1a firmware of ACSI2STM.

Are those versions of the firmware supposed to  include the fix from version 5.0c, or is anything else needed to make GemDrive mode work on the MegaSTE with cache enable when using version 5.00 or 5.1a of the ACSI2STM firmware on the internal MegaSTE ACSI2STM?

retro16, 2025-02-03:
Hi @fdanapfel,

All versions above 5.0c should work the same in that regard (no more self-modifying code). The code is patched by the STM32 before being sent to the Atari. There were many changes between 5.0c and 5.00, so you might have hit a regression somewhere.

Did you check for a potential conflict with your internal hard drive, if you have any ?
Could you provide a verbose output of 5.1a, so I could try to figure out where it fails ?

fdanapfel, 2025-02-03:
@retro16 Thanks for the quick response.

Since I replaced the built-in ACSI-to-SCSI card of the MegaSTE with the internal MegaSTE version of the ACSI2STM there is no internal hard drive anymore on the MegaSTE. There are also no other devices attached to the ACSI port.
So the only hard disk in the MegaSTE is the SD card on the internal ACSI2STM.

Sorry, don't know what you mean by "a verbose output of 5.1a"?

retro16, 2025-02-05:
Hi @fdanapfel,

Thanks for the extra details.

By verbose I mean connecting the board using the serial port adapter, then flashing the verbose variant of the firmware, and copy here the output of the serial monitor, leaving a bit of context (before it crashes, then just after it crashes). You can use Arduino's serial monitor or any serial terminal program, set at 1Mbps.

fdanapfel, 2025-02-05:
@retro16 Thanks for the clarification.

It will take me a while to get this all set up and working. Also not sure if I have a TTL-to-USB adapter that supports 1Mbps, is there a way to change the baud rate of the serial port to lower values without having to rebuild the firmware?

fdanapfel, 2025-02-06:
@retro16 OK, it looks like I was succesfully able to capture the requested log:
[acsi2stm_debug.txt.zip](https://github.com/user-attachments/files/18689147/acsi2stm_debug.txt.zip)

This is from two consecutive boots of the MegaSTE. On the first boot it got all the way to the desktop, but then when I tried to open the "C:" drive by double clicking the icon on the dektop it just hung.

After resetting the Atari (market with "<Resetting the MegaSTE" in the log) I tried to open XControl to see if I could change the cache setting, but then it hung as well.

Hope this helps to track down what is going wrong.

retro16, 2025-02-06:
Thanks a lot, that's perfect.
Analysis will take a long time and I'm quite busy right now, so don't expect a quick answer.

GemDrive technically works in your log because it already loads a lot of things, so it's not a trivial issue. Also, I'm not familiar with the MegaSTE so I don't know exactly when the cache is enabled. If anyone knows here, please let me know.

In the meantime, could you try with a FAT32 or an ExFAT SD card ? I didn't really test FAT16 with small cards as they are becoming rare nowadays. There's practically zero chance it solves anything, but that's a quick test. I don't need log output, just tell me if it makes any difference.

I hope we didn't hit yet another TOS bug ...

retro16, 2025-02-07:
I had a quick look and I found something. The MegaSTE is too fast for IRQ transfer in fast mode !

No need to do that FAT32 test I requested, it's really a communication issue between the STE and the STM32.

Bad news is: I can't really do much without oscilloscope / logic analyzer traces, and probably a few attempts. I don't really want to change this fast mode protocol because it will have performance impact on other machines, and I don't have enough room to fit a machine-specific protocol.

Will think about this in the next weeks. In the meantime, I can guarantee that ACSI mode is 100% unimpacted by this.

fdanapfel, 2025-02-07:
@retro16 Thanks a lot for taking a look into this. And good to know that that you already found something.

I just tested again anyway using a larger SD card formatted as ExFAT in GemDrive mode, and the behaviour is exactly the same as with the small FAT16 formatted SD card: as soon as XCONTROL activates the cache on the MegaSTE the whole system hangs.

So I can confirm that it has nothing to do with the format of the SD card.

No rush on getting this fixed. As ASCSI mode is fully working I can still use the ACSI2STM, it is just a little less convenient to get  stuff transferred to the Atari.

If you need any further assistance with testing or providing logs please feel free to reach out to me.

Thread 76 (2024-08-16):

What if internal HD (Mega STE)?

fplanque, 2024-08-16:
Please allow a newbie question: what if I already have an internal HD on my mega STE (with partition C: to H:) and I would like to connect the ACSI2STM and get an SD card to show up on J: in order to backup/transfer files?

- Do I simply change the jumpers to "ACSI id 1 to 5, GemDrive enabled" as shown in manual.md ?
- Can I assume my internal HD is ACSI id 0 ?
- Is there a risk of data loss on the internal HD if 2 devices use the same ACSI id?
- bonus: Can the ACSI2STM be used with ACSI id 1 to 5 even if there is no ACSI 0 in the system?

Thank you.

PS: It would be helpful for newbies like me (who haven't touched those machines for 25+ years) if there was an FAQ at the end of manual.md (and I would suggest including the 3/4 questions above ;)

fplanque, 2024-10-27:
Hello Jean-Matthieu,

Thank you very much for your answers!

In between I was able to answer some of my own questions (and raise some more). I documented my whole experience here: [ACSI2STM on Mega STE: backup of internal HD](https://www.fplanque.com/tech/retro/atari/atari-st-acsi2stm-mega-ste/) (May be useful for others ;)

Thank you for `GEMDRIVE.TOS`. This will could make everything easier.

Here's another newbie question though: when trying to upgrade my firmware using `HDDFLASH.TOS`: flashing.md says " it uses the Seagate SCSI standard command ". Does that mean the ACSI2STM should be be connected in STRICT/ACSI mode? Or should it be in GemDrive mode? Or maybe it doesn't matter?

PS: I do understand now some of my questions could not be answered in a way that works for everyone, but I believe some others could and are actually pretty important like "What happens if I use the same ACSI ID as my internal drive?" (DANGER). Therefore I believe you should do the FAQ anyway ;) It does not matter if it is incomplete or if it is redundant with some of the canonical documentation. It is a different way of accessing the information with a different mindset and different knowledge prerequisites. As a newbie to the project I was overwhelmed by the technical info in the .md files, much of which applies to people who build the adapter themselves. I did not know what to read and in which order ;) (If you don't have time and if you'd like, I can write a starting Q&A section based on my own experience and make a pull request.)

retro16, 2024-10-27:
I just read your article, it's fantastic ! Very good job !
I totally agree with your conclusion, I share your doubts about the SCSI implementation of ACSI2STM (it started as a copypaste of Hatari's drivers) as well as *all* ACSI drivers out there. The TOS layer over it doesn't help either with its fair share of bugs.

To answer your question about HDDFLASH, it will work with ACSI2STM in any mode (strict & GemDrive), on any of its IDs. I mention Seagate protocol so people can use other tool if they want, or use HDDFLASH on another compatible drive.

About your hard disk backup issue, I'm asking a question: would using a low level disk image tool to produce a disk image be an acceptable solution ? That way, you could use the image on ACSI2STM, as well as Hatari or any other emulator compatible with raw images. Would that fit your use case ? FYI Linux is able to mount AHDI images natively as it supports both FAT16 and Atari partition schemes. It requires obscure command-line incantations to make it work, but it works.
Also, working on a disk image would reduce stress on your precious vintage hard drive, as well as eliminating any risk of losing data in the process.

Other suggestion: did you try EmuTOS ? It has a very good ACSI driver built-in, and it works really well with GemDrive through `GEMDRIVE.TOS`.

About the FAQ, maybe the documentation is missing a part about how to handle disk drives in general on Atari, with its platform-specific concepts and quirks (How ACSI works, how drivers load, what drivers do, etc...). Some kind of combined tutorial with a Q&A, maybe ? That would make ACSI2STM the ultimate starting point for anybody trying to use their ST with anything else than the builtin floppy drive.

fplanque, 2024-10-27:
> I just read your article, it's fantastic ! Very good job !

Thank you! Very kind of you to say that :)

> I totally agree with your conclusion, I share your doubts about the SCSI implementation of ACSI2STM (it started as a copypaste of Hatari's drivers) as well as _all_ ACSI drivers out there. The TOS layer over it doesn't help either with its fair share of bugs.

Thanks. I was a bit worried I might have missed something or had some hardware issue that threw me off...

> To answer your question about HDDFLASH, it will work with ACSI2STM in any mode (strict & GemDrive), on any of its IDs. I mention Seagate protocol so people can use other tool if they want, or use HDDFLASH on another compatible drive.

Ok, will upgrade then and update the article accordingly.

> About your hard disk backup issue, I'm asking a question: would using a low level disk image tool to produce a disk image be an acceptable solution ? That way, you could use the image on ACSI2STM, as well as Hatari or any other emulator compatible with raw images. Would that fit your use case ? FYI Linux is able to mount AHDI images natively as it supports both FAT16 and Atari partition schemes. It requires obscure command-line incantations to make it work, but it works. Also, working on a disk image would reduce stress on your precious vintage hard drive, as well as eliminating any risk of losing data in the process.

It's interesting in it's own right but no longer necessary as I found a way to get all my files off the HD. Now I need to test and decide if it's better to continue to work with GemDrive or ACSI but having raw image adds additional complexity I don't need at this point. It's nice for me to be able to easily add/remove files from the SD card on macOS or Windows.

> Other suggestion: did you try EmuTOS ? It has a very good ACSI driver built-in, and it works really well with GemDrive through `GEMDRIVE.TOS`.

I didn't try it yet but it's on my TODO list ;)

> About the FAQ, maybe the documentation is missing a part about how to handle disk drives in general on Atari, with its platform-specific concepts and quirks (How ACSI works, how drivers load, what drivers do, etc...).

You're right, many questions are not specific to ACSI2STM (but those questions arise for the first time when you try to use an external ACSI device -- in this case ACSI2STM -- and as a newbie you don't necessarily have a well enough understanding to know what is general and what is specific...)

> Some kind of combined tutorial with a Q&A, maybe ? That would make ACSI2STM the ultimate starting point for anybody trying to use their ST with anything else than the builtin floppy drive.

I'll give it a shot further down the road. I am now also trying IDE and SCSI drives on the Falcon, which makes the whole driver mess even more complex to sort out ;)

retro16, 2024-11-11:
Hi again François,

I had the opportunity to work a lot on the project lately. 5.00 is out, it looks very stable on all my hardware. It went through a lot of testing, especially in multi-device situations.

I think the simplest way to achieve your use case with 5.00 is:

* Set internal HDD to ACSI id 0
* Set ID_SHIFT on ACSI2STM to free id 0 (any position should work)
* If your hard disk driver allows booting GemDrive, you have nothing more to do
* If GemDrive doesn't boot, simply copy `GEMDRIVE.PRG` into your `AUTO` folder

Older GemDrive versions used an invalid protocol that disturbed other devices on the bus in very subtle (and pseudo-random) ways, this effect should be totally eliminated now.

Thread 79 (2024-10-30):

Atari 520-STFM - 1024kb - ACSI2STM Compact v1.0 2023-08-24

u038265, 2024-10-30:
Hello,
I tried to install the firmware version 5.0d successfully.
When I restarted the computer I could not read the microsd C and D and the program to read the RTC did not start automatically.
I went back to the firmware version 5.0c when I restarted the computer everything started working normally again, the program that reads the RTC started automatically and I could read the microsd C and D.
Do you have any idea what the problem could be?
Thanks for your work.

u038265, 2024-10-30:
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
With firmware version 5.0d I only have the screen where it finds the microsd but cannot read them.

retro16, 2024-10-30:
Hi, 5.0d is a pre-release, and to be fair I somewhat rushed it to make PIO mode available as soon as possible. So it wasn't tested as much as other releases. It works on my computer, but who knows what happens on yours.
You can stay at 5.0c currently, 5.0d doesn't offer any major improvement for your setup.
As-is, I don't have enough information to debug what's happening on your computer with 5.0d, I would need a verbose log output for that.
BTW, I don't think you need the UltraSatan RTC tool at boot to set the clock, it's handled internally by the GemDrive driver. UltraSatan RTC compatibility in intented for ACSI users. Anyway it doesn't hurt either, so you can do as you like.

As always, thank you for your feedback, it's very valuable information to know when things fail and it helps tremendously improving the product. Future version 5.00 aims at perfection, nothing less, so I need all the feedback I can have.

u038265, 2024-10-30:
Thank you so much.

u038265, 2024-10-30:
Thank you so much.
Have a nice day.

retro16, 2024-11-02:
5.0e should have fixed all issues, it was properly tested this time !

u038265, 2024-11-03:
Thank you so much.
Have a nice day.

Closed 2024-12-08.

Thread 80 (2024-10-30):

Gemdrive broken in Pre-release 5.0d

githubuser-user-ai, 2024-10-30:
Hi,

As the title says it, Gemdrive is broken.
The driver sees the sd card,, but on the desktop, opening C does nothing (no message, no window ...).

Revert to 5.0c, and everything is working nicely.

(Using ACSI2STM compact on STE TOS1.62, 1Mo)

Regards,
Christophe

TzOk83, 2024-10-31:
I may confirm: STe TOS 1.62 or 2.06 has the same behavior. The firmware in the PIO version doesn't seem to work at all.

retro16, 2024-11-02:
Fixed in 5.0e ! Sorry ;)

githubuser-user-ai, 2024-11-03:
Thanks for fixing this issue.
It's working nicely.
No worry, your improvement are wonderful !

Closed 2024-11-03.

Thread 82 (2024-11-23):

Compact PCB is not really suitable for hand soldering, 0805 parts would be way easier

TzOk83, 2024-11-23:
If resistors and capacitors could be changed to 0805 footprint it would be way easier to hand solder them. Hand soldering 0402 parts is an extreme sport ;) I'm not saying it's not doable, but for sure not a piece of cake, even using a microscope. There is plenty of space on the PCB for bigger footprint parts, so I don't understand this design choice.

retro16, 2024-11-23:
Hi, the compact PCB is not supposed to be hand soldered, but built with a stencil, paste and a reflow oven. 0402 was easier for an efficient layout and cheaper. I reckon there is enough room for 0805 and some of the decoupling capacitors are probably overkill, but I don't have motivation to change the design as EasyEDA made a big mess with parts updates so the source is practically useless as-is.

TzOk83, 2024-11-23:
The main problem with hand soldering this board is that the GND pads of the capacitors are solid with the ground plane, which makes them very difficult to tin with a tiny soldering tip. I had to use a preheater and extra flux. But, at least for me, preheater means no microscope...

Stencil is a huge price increase, especially if you want to make just 1 or 2 units. I once saw the source project for a compact PCB, but it disappeared from the repository some time ago. I can try to make a reflow on my preheater, with paste applied directly to the PCB, without a stencil. Recently I managed to solder the TQFP100 chip that way and ended up with just 2 shorted pins.

retro16, 2024-11-24:
The original EasyEDA sources for the schematic and PCB are the 2 json files in the pcb/Compact directory. That's what I used to produce all the othet files.

TzOk83, 2024-11-30:
I'll look at them, but I've never used EasyEDA before. By the way, I may report a success in soldering ACSI2STM Compact PCB.

methanoid, 2024-12-05:
So if we are recommended to order the boards assembled can you tell me if ordering assembled boards from JLCpcb they do the DB19 connector/pins? When I experimented with placing an order it didnt show in the render as being connected which suggests its not in the BOM/PickPlaCE files?  It may be a "me" problem as never ordered from JLCpcb or PCBway before

BrettRogersUK, 2024-12-07:
I've used the provided sources for EasyEDA and changed all the 0402 components to 0805 and it fits well. I had to do a re-route on all all the tracks but it did it. I've ordered 5 boards so will see if they work when I've soldered them up. For the connector pins (DB19) would it be best to use the normal square dupont style header pins or Turned pin round header pins?

retro16, 2024-12-08:
Very nice @BrettRogersUK.

About your DB19 pins question, here are my design criteria for the PCB assembly to help you take the right decision:
* All parts must be available for assembly at JLCPCB/LCSC, as it's one of the leaders for low cost PCBA so I want to keep that as a mandatory condition.
* Choose future-proof parts, as much as possible.
* Keep cost low.
* If you provide all files to the manufacturer, you should receive a 100% functional unit (no need to tweak anything). Firmware flashing using the "UART adapter inserted slanted in PCB plated holes" hack counts as a valid technique.

My opinion: of course, round pins are better for the health of the DB19 port, but square pins have the advantage of being much more common standard parts. There are also alignment issues during soldering operations, I like that square pins are tied together by groups of 2. Overall, I prefer round pins if feasible.

Since this change is about making hand-soldered units possible, we could add "hand soldering" to that list.

As soon as you tested the new design, feel free to do a pull request or share the design the way you want, I will review it and we could integrate it in the project. I can do the dirty work of regenerating gerber/screenshots/reference images myself.

TzOk83, 2024-12-08:
The round "machine type" goldpins are much thinner, and I'm afraid they won't ensure proper contact in the DB19 socket.

I have just built the 2nd "compact unit", this time without the help of a microscope, but still with a preheater/reflow plate.

methanoid, 2024-12-09:
Guys, you clearly are ALL miles better than I am with a soldering iron. But
am I right that I can just send the Gerbers & BOM to JLCpcb and the 3D
model and select them to manufacture and all I then need do is insert my SD
cards? That seems too easy for a soldering-illiterate like me!!!!

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

retro16, 2024-12-09:
@methanoid For the PCB, that's the idea. Sometimes some parts aren't available at JLCPCB so you need to substitute (which can be tricky). When I ordered mine, I tested the board as-is: flashed firmware using the "official" USB-UART dongle, plugged USB-C power and it worked first try.
The 3D model for the case isn't officially supported as I couldn't make it work 100% on all models, so I removed it from the official source, anyway feel free to experiment. IMHO the PCB protects itself pretty well from the environment so a case isn't 100% necessary.
Feel free to open a new issue if you have difficulties with ordering the parts or you are uncertain about the result, I have some time in the next weeks to help. Like other issues, provide screenshots, detailed info, ... you know the drill.

JM

jfceklosky, 2024-12-13:
I created a fork of this design here, that works with the awesome firmware created by the team here.

[git](https://github.com/jfceklosky/acsi2stm-alt-hardware)

retro16, 2025-01-14:
The new 5.1a (pre-release) has switched everything to 0805 components. The board is still untested (I didn't fabricate it yet) so try it only if you are ready to lose your money.

There is also a new "Super Compact" PCB with reduced functionality, but taking much less space and marginally lower cost.

BrettRogersUK, 2025-04-15:
Hi All, Quick update. I've started building up my 0805 version of the compact board. Does anyone have any recommendations for good solder paste and where to buy it from? I've just spent the last two hours fighting with hand soldering the STM32  IC. I tried drag soldering method with plenty of flux but got lots of blobs then had to use the solder wick which took too much solder off which in turn left legs unattached. Complete nightmare. So any recommendations for solder paste would be great thanks. Yes I do have a hot air station too just not the solder paste. Thanks.

TzOk83, 2025-04-15:
I was hand-soldering the old compact version. Good flux (I prefer Alpha RMA-7), rosin-core leaded solder (Sn60Pb40), and that's all the secret. If you insist on using solder paste and hot air soldering, look for leaded paste. I know only local products, like AG Termopasty Easy Print /Sn62Pb36Ag2/; rosin-core leaded solder: Cynel Unipress Sn60Pb40 SW26.

BrettRogersUK, 2025-04-15:
> I was hand-soldering the old compact version. Good flux (I prefer Alpha RMA-7), rosin-core leaded solder (Sn60Pb40), and that's all the secret. If you insist on using solder paste and hot air soldering, look for leaded paste. I know only local products, like AG Termopasty Easy Print /Sn62Pb36Ag2/; rosin-core leaded solder: Cynel Unipress Sn60Pb40 SW26.

I've got good rosin core leaded solder 60/40 it just wasn't working for me today. I usually don't have a problem hand soldering small units like the STM32 but today I just couldn't get it right for some reason. I've been wanting to try using solder paste for a while but wasn't sure which is a good one to get. Finding leaded stuff now in the UK is nearly impossible as they won't sell leaded solder or solder paste to hobbyists like myself, they'll only sell to professionals apparently. It has certainly not taken me two hours to just do one thing like the SMT32 before. Usually takes me around 2 hours to build a whole board taking breaks etc in between components.

TzOk83, 2025-04-15:
My other hint is: don't order PCBs with a white solder mask. It is thicker than regular green or red, and makes hand soldering way harder.

BrettRogersUK, 2025-04-15:
> My other hint is: don't order PCBs with a white solder mask. It is thicker than regular green or red, and makes hand soldering way harder.

Mine are green. Maybe I'll build this one seeing how I go with it. Should be ok now the SMT32 is on. Be happy if it works 🤣🤣🤣. Only need one but have another 4 boards and one more smt32 to use along with other components so in theory I can make another if this one fails.

jfceklosky, 2025-04-16:
If you don't want to deal with the STM32 soldering you are free to use my TH designs.  They work fine with the 5.0 firmware.

https://github.com/jfceklosky/acsi2stm-alt-hardware

BrettRogersUK, 2025-04-16:
> If you don't want to deal with the STM32 soldering you are free to use my TH designs. They work fine with the 5.0 firmware.
>
> https://github.com/jfceklosky/acsi2stm-alt-hardware

Thanks for that. I don't usually have problems doing those surface mount chips but today was an exception. I'll crack on later today and finish the board see if it works. I've got about three versions using the Blue pill boards but they're home made on breadboard. I want something more permanent. So, if this doesn't take off like I'd hoped I'll get some of your boards made and do it that way. Thanks again folks!

BrettRogersUK, 2025-04-21:
> If you don't want to deal with the STM32 soldering you are free to use my TH designs. They work fine with the 5.0 firmware.
>
> https://github.com/jfceklosky/acsi2stm-alt-hardware

Hi,

I've finished soldering my board up and got it programmed but now I have a new issue that I just can't fathom out.

https://github.com/retro16/acsi2stm/issues/96

if anyone has any ideas for me to try out I would be grateful to see if I can get this working properly.

Many Thanks.

Thread 83 (2024-11-29):

Clock in mixed mode, timestamp on ACSI partition

FlathVader, 2024-11-29:
My setup:

Atari 1040 STE, TOS 1.62
ASCI2STM firmware 5.00
mixed mode, PP driver

If I boot my Atari and use US_GETCL.PRG in the AUTO folder the RTC date is correctly displayed in the XCONTROL.ACC.
If I create a folder/file on the GemDrive partition the date is correctly set.

However, if I create a folder on an ACSI partition the date is wrong.

I can correct the date manually doing the following:
If I go into XCONTROL.ACC and set the date with the one already displayed (i.e. actually no change) and again create a file/folder on an ASCI partition the date is correctly set.

If I well understand this action in XCONTROL.ACC  should trigger the GEMDOS function 43 (Tsetdate).
If I try to copy this behavior with a small program in the AUTO folder - Tsetdate(Tgetdate()) - it does not do the job and I don't understand why.

Cheers
Peter

FlathVader, 2024-11-29:
Thanks for your reply.
I did a quick test with a floppy disk - same behavior.
I may do more tests the next days.

retro16, 2024-11-30:
I found the root cause.

If I call Tsetdate/Tsettime during GemDrive initialization (before system calls are hooked), it fixes your issue.
No idea why your little program doesn't fix the problem, it really should because GemDrive forwards Tsetdate/Tsettime to the OS.

Anyway, I patched master branch and I joined a firmware image here if you don't want to rebuild the whole code yourself. This version is marked 5.0h internally. Flashable using serial or HDDFLASH as you wish.

Fixed firmware: [acsi2stm-5.0h-fix.zip](https://github.com/user-attachments/files/17965148/acsi2stm-5.0h-fix.zip)

I tested without US_GETCL.PRG so it's really unnecessary in your case (as long as GemDrive boots, it handles everything by itself internally even if there is no SD card inserted). This program is only relevant if you want to boot in strict mode.

This was not fully tested with multiple devices, so I won't make a release as-is (I must rework test procedures a lot to take this issue into account). Feel free to use that version without worry, changes were minimal so you will keep the same stable experience 5.00 brought.

FlathVader, 2024-11-30:
Thanks, the situation is now (without US_GETCL.PRG):

1/ Booting v5.0h
2/ Create new folder on ACSI partition: timestamp 30.11.28
3/ Open Xcontrol.acc, it shows 30.11.2024
4/ Set 30.11.2024 with Xcontrol.acc
5/ Create new folder on ACSI partition: timestamp 30.11.24

Same on Floppy Disk.

I checked with Sys-Mon on my Atari and I can see that Xcontrol.acc calls XBIOS Settime in addition to the GEMDOS calls Tsetdate/Tgetdate.

FlathVader, 2024-11-30:
I tried to copy Xcontrol.acc's way to set the date with a small program, now using XBIOS Settime.
No success for the year timestamp, it remains 2028. Y2k issue. Time, day, month are ok.
I am really wondering why Xcontrol.acc successfully sets the timestamp.

```
start
	move.w	#$2a,-(sp)		; Tgetdate
	trap	#1
	addq.l	#2,sp
	move.w	d0,d1			; time in d1

	move.w	#$2c,-(sp)		; Tgettime
	trap	#1
	addq.l	#2,sp			; date in d0

	move.w	d0,-(sp)
	move.w	d1,-(sp)
	move.w 	#$16,-(sp)		; Settime
	trap 	#14
	addq.l 	#6,sp

end	move.w  #0,-(sp)		; function # to exit program.
	trap    #1			; call the operating system.
```

retro16, 2024-11-30:
To fix the first issue on 5.00, I could reproduce it on a floppy before fixing it. However I can't reproduce the 2028 issue with 5.0h no matter how hard I try.

I have a 1040 STE, switchable TOS 1.62 FR/1.62 US/2.06 FR/EMUTOS 1.2, GemDrive 5.0h, no boot program except GemDrive.

I have correct behavior for all TOSes with 5.0h when creating folders on a floppy, date shows as 2024.

No idea where this year 2028 comes from.

retro16, 2024-11-30:
After reviewing your code, I'm not sure if d1 is preserved by the Tgettime call. It is preserved by GemDrive, not sure about TOS. C calling conventions specify D0-D2/A0-A2 as scratch registers ...
Maybe you should save it in memory to be sure ? If you swap Tgettime and Tgetdate, you could push Tgettime's return value directly on stack, it will be in correct order for Settime.

FlathVader, 2024-11-30:
I did a test without the ASCI2STM device.
Just plain TOS 1.62 and XCONTROL.ACC.
If I set the date and create a folder the timestamp is correct.

=> This has nothing to do with ASCI2STM and you can close the issue.

Still no clue why XCONTROL does the thing and my test programs not.
Will try your hints, it's been 30 years since I did coding on an Atari ST :)

FlathVader, 2024-11-30:
I found the tool that messed up my system: XBOOT.PRG in the AUTO folder.
Thanks :)

TzOk83, 2024-12-01:
Don't know if it is any helpful, but year 2028 means "date not set". There is a bug in TOS 1.06 and 1.62, with synchronizing the system clock from IKBD, and it is fixed by STEFIX.TOS in AUTO folder. This fix works for both 1.06 and 1.62, despite on the latter one, program indicates that it is not needed for that version of TOS.

retro16, 2024-12-01:
That's interesting information.

I simplified GemDrive's logic for the next coming release: It simply calls Tsetdate/Tsettime at boot to synchronize the ST with its own RTC. It doesn't hook Tgetdate/Tgettime anymore. I retained the logic that sets the internal RTC using Tgetdate/Tgettime if date is not set in the ACSI2STM, so units without backup battery work correctly on computers with an internal clock.

If I understood correctly, it means that STEFIX won't be needed with the next GemDrive because GemDrive sets the date at boot. Don't quote me on that, I'm no IKBD expert.

FlathVader, 2024-12-01:
Thanks for the hint with STEFIX, I will give it a try.

As it seems to be a plain TOS bug, the following fixed it for me:
 - In https://www.atari-forum.com/viewtopic.php?t=31625 you can find, among other useful information, the link to Y2KPATCH.ZIP.
 - I downloaded it and patched a TOS image
 - Booted with that image, all good.

Now I need to get this on 2 eproms and I will be as happy as I can be :)

cathrynm, 2025-07-13:
For me that Y2KPATCH.ZIP file worked also. Just updated roms from the patch, and nothing else in AUTO aside from US_GETCL.PRG. This was a handy use for my TOS Emulator which allowed me to get the clock working without having to mess about with EPROM programming.

Thread 84 (2025-01-12):

Atari TT and MegaSTE versio

math05, 2025-01-12:
Does MegaSTE version work with TT? Can I safely connect it to my TT?

retro16, 2025-01-12:
Hi Math,

I never had a TT nor a MegaSTE myself, so take my reply with a grain of salt. If anybody has actual experience with these machines, feel free to validate or correct me.

The MegaSTE PCB is supposed to replace the internal ACSI HDD of the MegaSTE. AFAIK, the TT has a SCSI HDD, it is incompatible with ACSI.

You have 2 solutions:
* Use a normal "ACSI2STM Compact" unit on the external ACSI port, same as a ST/STE.
* Use BlueSCSI to emulate an internal hard drive (never tested this, I don't know if it works, you should contact BlueSCSI people).

JM

longissor, 2025-01-12:
Hi Math05,

_**JM**, sorry to highjack your message board. Let me now if you want me to delete.
And thank you very much for your work on this system._

The TT does not have internal ACSI port like the MegaST and MegaSTE. So you cannot connect the ACSI2STM internally inside a TT.
Your solution is the external compact version. You just need to get the 2 serial ports present on the VME out of the way. You can do this using this alternative VME plate: https://www.thingiverse.com/thing:6903218

For MegaSTE, you could use the cable designed for the UltraSatan and solder a 20 pin IDC connector on the ACSI2STM compact.
But the easiest would be to do like the TT and connect at the back after moving the serial port.
You will see a photo of an ACSI2STM at the back of a MegaSTE at the end of this page: https://www.16-32bit.eu/acsi2stm

Or get the ATCI2STM version for MegaSTE here: https://www.16-32bit.eu/acsi2stm-mega-ste
Stock is back in 2 weeks

For MegaST, the compact ACSI2STM is good. Or you can 3D print a support and mount it inside using the UltraSatan cable.
more here: https://www.16-32bit.eu/acsi2stm-megast

Note that the ACSI port in the MegaSTE is different than the one in the MegaST.

Cheers
Cyril

retro16, 2025-01-12:
No problem @longissor, this message board is public, and providing information is always welcome, especially when it's that good !

I'm working on a new "Super compact" PCB that may fit the TT without modification: it extends only 20mm above the center of the DB19 screws. To make it smaller, it has only one SD slot and doesn't have a backup battery.

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

jfceklosky, 2025-01-16:
Really nice compact redesign!

math05, 2025-01-17:
Thanks everybody for comments. I have a clear picture now :)

Thread 85 (2025-01-12):

Multiple SD cards in a compact PCB

CarstenOtto63, 2025-01-12:
I've got 3 compact ACSI2STM PCBs latest version. One ready built from ebay, 2 via the suggested PCB service. The good news, all 3 boards are working, SD cards are recognised in every slot individually and with F16/F32/image format.

But, as soon as I insert 2 SD cards at the same time, slot 1&2 for example, either no or only one card is recognised and the other slots are reported as No card.

What am I doing wrong?

I am working on an unmodified Mega ST 4 with TOS 1.4.

Thanks for your help

diegoparrilla, 2025-01-12:
What power supply are you using?

retro16, 2025-01-12:
Hi Carsten,

This is not normal behavior, I never had such issues.

What brand are your SD cards ? They might have timeout issues.

In GemDrive mode, does hot plug work ? To test:

 * Boot with no card
 * Install icons for C:, D: and E:
 * Insert a card in C:, check that it works
 * While leaving the card in C:, insert another one in D:, check that it works

The issue you have is probably independent from TOS version or machine variant.

If you can, it would be good to flash the debug firmware and paste a log of the boot here. If you need assistance for that, just ask for more help. You will need a USB-serial dongle to make this work.

CarstenOtto63, 2025-01-12:
@diegoparrilla : I am using a standard USB power supply. Should be sufficient to what I have seen about power consumption.
@retro16: I will test that immediately, up to now I always tried to boot with the cards inserted.

CarstenOtto63, 2025-01-12:
I did the tests.
After the boot without card
* I inserted a card in each slot -> worked
* I inserted that card in slot 1 and a second card in slot 2 and 3 -> didn't open
* I removed the card from slot 1 and the drive with the second card -> drive shows up
[acsi2stm test1.txt](https://github.com/user-attachments/files/18391268/acsi2stm.test1.txt)

retro16, 2025-01-14:
Thanks for the log. The output looks like if you removed the first card (which you didn't). That's a hardware failure, and a rare one.

Possible things that have a problem:

* USB power supply
* SD card pullup resistor
* SD card itself that doesn't strictly follow the standard
* A short circuit (soldering problem, misaligned component, bent pins) on SD slots

CarstenOtto63, 2025-01-14:
Thank you for the analysis.
* USB power supply, it is a standard USB supply and alternatively power via USB-Serial adapter, I will check the voltage on the board.
* Pullup resistor: Two boards came from jlcpcb, I had to hand solder the SD slots, one from cbmretro ready-to-use. I will try to check the signals, but all boards show the same behaviour.
* The SD cards are from intenso, 4GB cards, they are SDHC cards. I thought they should be ok, but I will try with a different brand as this would be the most likely reason.
* short circuit, could be, that is why I ordered the ready-built PCB as a reference.

It is not essential for me to have that feature, but it would be nice to have or at least know why it is not working.

CarstenOtto63, 2025-01-14:
Thanks again for your support,
I tested it with 32GB SanDisk Extreme cards and they worked as they are supposed to. Hotswap ok, 2 cards in any slot combination works ok. The discs I used before immediately crash the system. I haven't expected that, as the SD cards are brand new.

Thread 87 (2025-03-06):

Adding external activity LED on Mega STE internal version

fdanapfel, 2025-03-06:
Hi,

I'm using the internal version of acsi2stm for the Mega STE (https://github.com/retro16/acsi2stm/tree/stable/pcb/MegaSTE%20Internal ) which unfortunately doesn't seem to have a connector to connect the LED from the Mega STE disk cover to be able to see disk activity when the case is closed.

Is there a possibility to add a connector for the LED or can cables from the LED be soldered on the STM32 directly somehow?

tophe38, 2025-03-10:
Hi,

Bluepill HDD led activity come from PC13, which is Pin2 on the bluepill header.
But PC13 is the negative of the LED, other side should be connected to VCC3V3 (Pin 18)
Here is the LED schematic (from Bluepill schematic)

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

retro16, 2025-03-24:
Hi @tophe38, I never owned nor seen a real Mega STE, so feel free to disregard my message if it's silly.

Perhaps you could add a connector for the external LED: add another resistor and the correct connector for the external LED (I suppose it is standard "Dupont" pins ?) between VCC and PC13.

That would be a very cool addition to the official Mega STE PCB you produced.

JM

tophe38, 2025-03-25:
Hi,
It's done, but I did not push it, since it wasn't a big/important change.
But it makes sense, so I'll see tonight to make pull request.
The HDD led is a simple 2 wires with 2.54 female connector.
Thanks for the request.

Thread 90 (2025-03-23):

Gemdrive mode freezes system when Alt-RAM is present

czietz, 2025-03-23:
On an ST or STE with Alternate RAM (provided by addons such as the MonSTEr, MonSTerbo, Magnum ST, Storm ST, Twister, ...) accessing the Gemdrive freezes the system to the point where even Ctrl-Alt-Del doesn't work anymore.

Note that you cannot use the DMA to access Alt-RAM, as the DMA only works in ST-RAM. Therefore, on a system with Alt-RAM there is a so-called "fast-RAM buffer" in ST-RAM, the address of which can be found via the _FRB cookie. This is used as temporary buffer for DMA by TOS, hard disk drivers, etc.

A quick search through the ACSI2STM code base found not reference to the _FRB cookie; therefore, I assume – without knowing with certainty – that this is the cause of this issue.

czietz, 2025-03-23:
Upon closer inspection, ACSI2STM even has a check for DMA-compatible memory:

https://github.com/retro16/acsi2stm/blob/aae0f6097b89e1470ef4b23484c8e42bbfd1f8e6/acsi2stm/SysHook.h#L378-L389

However, the address range is too broad. As mentioned, the DMA can only access ST-RAM. On a ST/MegaST/STE/MegaSTE, this means the first 4 MiB of memory. (And on a TT the ACSI-DMA is restricted to ST-RAM, too, which can be max. 10 MiB there.)

retro16, 2025-03-24:
Fantastic feedback, again ! I can't thank you enough for your insight.

Unfortunately, I don't have enough ROM space left on the STM32 to implement the horribly complex logic required to read a cookie correctly.

Here, it says "max 14MB", which is a widely known value: https://temlib.org/AtariForumWiki/index.php/Exception_vectors_and_basic_RAM_%26_ROM_locations
14MB would translate to phystop = 0xd00000, that would be a simple fix, but probably not enough for these expansions to work.

I have no extra hardware and only own basic ST / STE machines, so I have no way to test these expansions.

For now, a possible workaround would be to use the PIO firmware variant which doesn't do DMA at all. The code forces "isDma" to "true" in PIO mode, but DMA is simulated using CPU reads/writes in that mode.

JM

czietz, 2025-03-24:
Only the Falcon can have 14 MiB of (ST-)RAM. But the Falcon doesn't have an ACSI port, and is therefore not a target for the ACSI2STM. Maybe you could read the actual phystop system variable instead of hard-coding a value.

retro16, 2025-03-24:
Some tools alter the phystop value, but at this point it may be better to actually rely on it. After all, access works in all cases, it's just much slower if outside of the DMA range.

Thanks a lot for the info, I will try to implement phystop read if I have enough ROM space.

JM

retro16, 2025-03-24:
Implemented in 5.1b. Didn't fully test, but it seems that it's working.

czietz, 2025-03-24:
Thank you. However, as of commit d0b1298f818eb6d06f0754296209b6f107ea9576 this is _not_ fixed. Loading GEMDRIVE.PRG still hangs the system when Alt-RAM is present.

Flashing the PIO mode firmware and using GEMDRPIO.PRG works, though, even with Alt-RAM. So there appears to be some issue with the DMA, still. I'll try figure it out, but can't promise when I'll have time for debugging.

czietz, 2025-03-25:
At first glance it appears that it now hangs whenever a program runs in Alt-RAM and makes its first GEMDOS call. In that case, the stack and therefore parameters to the GEMDOS call are in Alt-RAM. I wonder: Do you read the GEMDOS opcode and parameters from stack using the DMA?

retro16, 2025-03-26:
Nice catch ! You found the root cause of the issue. That's exactly what I do:

https://github.com/retro16/acsi2stm/blob/d0b1298f818eb6d06f0754296209b6f107ea9576/asm/GEMDRIVE/syshook.s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

On every system call, I set the DMA pointer address to the parameters, then I send the single-byte GemDrive command to the STM32 (it calls GemDrive::onGemdos), and the STM32 just reads parameters to decide whether it handles the call or forwards it to the system.

Now the hard part:
* This ASM code must fit inside a boot block (~500 bytes plus some header)
* This code is highly performance critical
* I don't have enough room to hold multiple variants of that code

The PIO variant degrades performance much more because it does a simulated DMA transfer, I didn't optimize PIO code at all.

There aren't tons of alternatives, here are my current ideas (all of them are heavy to implement and not so desirable):
* Pass the stack pointer at a fixed ST-RAM address and use the standard functions to read parameters (functions that honor dmatop). That will make the critical path much slower even on a standard ST.
* Make the PIO variant able to respond to the boot sector query (for convenience) and optimize PIO for speed. That would also work around MegaSTE cache issues (root cause unknown) and TT-RAM issues (same problem as Alt-RAM). PIO has the potential to be nearly as fast as DMA on faster machines if the code is correctly optimized.

Thread 94 (2025-04-03):

STM32 ROM space filled by Arduino USB libraries (remark, not a bug)

czietz, 2025-04-03:
Since you mentioned in #90 the lack of free space in the STM32 flash, I had a look at the .map file of the built binary. I found that about 3900 bytes of Arduino USB libraries are included in the binary (and thus in flash), even though afaik ACSI2STM does not use the STM32's USB interface at all.

I'm not particularly familiar with Arduino libraries, but hopefully there is a define or something else to exclude the USB libraries from the binary. That would free ROM space for actual ACSI2STM features.

```
0x000000000800d700      0x2b8 /acsi2stm/build.release~/firmware/build.arduino~/Arduino-verbose/build/core/core.a(usb_core.c.o)
0x000000000800cea0      0x194 /acsi2stm/build.release~/firmware/build.arduino~/Arduino-verbose/build/core/core.a(usb.c.o)
0x000000000800d1a0      0x15c /acsi2stm/build.release~/firmware/build.arduino~/Arduino-verbose/build/core/core.a(usb_cdcacm.c.o)
0x000000000800d540       0xc4 /acsi2stm/build.release~/firmware/build.arduino~/Arduino-verbose/build/core/core.a(usb_core.c.o)
0x000000000800d9b8       0xc0 /acsi2stm/build.release~/firmware/build.arduino~/Arduino-verbose/build/core/core.a(usb_core.c.o)
0x000000000800cde0       0xb0 /acsi2stm/build.release~/firmware/build.arduino~/Arduino-verbose/build/core/core.a(usb.c.o)
0x000000000800d410       0xac /acsi2stm/build.release~/firmware/build.arduino~/Arduino-verbose/build/core/core.a(usb_core.c.o)
0x000000000800d388       0x88 /acsi2stm/build.release~/firmware/build.arduino~/Arduino-verbose/build/core/core.a(usb_core.c.o)
0x000000000800d604       0x7c /acsi2stm/build.release~/firmware/build.arduino~/Arduino-verbose/build/core/core.a(usb_core.c.o)
0x000000000800dab0       0x5c /acsi2stm/build.release~/firmware/build.arduino~/Arduino-verbose/build/core/core.a(usb_core.c.o)
0x000000000800d14c       0x54 /acsi2stm/build.release~/firmware/build.arduino~/Arduino-verbose/build/core/core.a(usb_cdcacm.c.o)
0x000000000800d0b4       0x50 /acsi2stm/build.release~/firmware/build.arduino~/Arduino-verbose/build/core/core.a(usb_cdcacm.c.o)
0x000000000800d4f4       0x4c /acsi2stm/build.release~/firmware/build.arduino~/Arduino-verbose/build/core/core.a(usb_core.c.o)
0x000000000800d070       0x44 /acsi2stm/build.release~/firmware/build.arduino~/Arduino-verbose/build/core/core.a(usb_cdcacm.c.o)
0x000000000800d2fc       0x44 /acsi2stm/build.release~/firmware/build.arduino~/Arduino-verbose/build/core/core.a(usb_reg_map.c.o
0x000000000800fd82       0x43 /acsi2stm/build.release~/firmware/build.arduino~/Arduino-verbose/build/core/core.a(usb_cdcacm.c.o)
0x000000000800dc28       0x40 /acsi2stm/build.release~/firmware/build.arduino~/Arduino-verbose/build/core/core.a(usb_regs.c.o)
0x000000000800d6c0       0x40 /acsi2stm/build.release~/firmware/build.arduino~/Arduino-verbose/build/core/core.a(usb_core.c.o)
0x000000000800da78       0x38 /acsi2stm/build.release~/firmware/build.arduino~/Arduino-verbose/build/core/core.a(usb_core.c.o)
0x000000000800d4bc       0x38 /acsi2stm/build.release~/firmware/build.arduino~/Arduino-verbose/build/core/core.a(usb_core.c.o)
0x000000000800db2c       0x32 /acsi2stm/build.release~/firmware/build.arduino~/Arduino-verbose/build/core/core.a(usb_mem.c.o)
0x000000000800cdb0       0x30 /acsi2stm/build.release~/firmware/build.arduino~/Arduino-verbose/build/core/core.a(usb.c.o)
0x000000000800db5e       0x2a /acsi2stm/build.release~/firmware/build.arduino~/Arduino-verbose/build/core/core.a(usb_regs.c.o)
0x000000000800dbae       0x26 /acsi2stm/build.release~/firmware/build.arduino~/Arduino-verbose/build/core/core.a(usb_regs.c.o)
0x000000000800db88       0x26 /acsi2stm/build.release~/firmware/build.arduino~/Arduino-verbose/build/core/core.a(usb_regs.c.o)
0x000000000800d680       0x24 /acsi2stm/build.release~/firmware/build.arduino~/Arduino-verbose/build/core/core.a(usb_core.c.o)
0x000000000800d364       0x24 /acsi2stm/build.release~/firmware/build.arduino~/Arduino-verbose/build/core/core.a(usb_core.c.o)
0x000000000800d340       0x24 /acsi2stm/build.release~/firmware/build.arduino~/Arduino-verbose/build/core/core.a(usb_core.c.o)
0x000000000800d034       0x22 /acsi2stm/build.release~/firmware/build.arduino~/Arduino-verbose/build/core/core.a(usb_cdcacm.c.o)
0x000000000800d114       0x20 /acsi2stm/build.release~/firmware/build.arduino~/Arduino-verbose/build/core/core.a(usb_cdcacm.c.o)
0x000000000800db0e       0x1e /acsi2stm/build.release~/firmware/build.arduino~/Arduino-verbose/build/core/core.a(usb_mem.c.o)
0x000000000800dc0c       0x1c /acsi2stm/build.release~/firmware/build.arduino~/Arduino-verbose/build/core/core.a(usb_regs.c.o)
0x000000000800dbf0       0x1c /acsi2stm/build.release~/firmware/build.arduino~/Arduino-verbose/build/core/core.a(usb_regs.c.o)
0x000000000800dbd4       0x1c /acsi2stm/build.release~/firmware/build.arduino~/Arduino-verbose/build/core/core.a(usb_regs.c.o)
0x000000000800d6a4       0x1c /acsi2stm/build.release~/firmware/build.arduino~/Arduino-verbose/build/core/core.a(usb_core.c.o)
0x000000000800d058       0x18 /acsi2stm/build.release~/firmware/build.arduino~/Arduino-verbose/build/core/core.a(usb_cdcacm.c.o)
0x000000000800fddb       0x12 /acsi2stm/build.release~/firmware/build.arduino~/Arduino-verbose/build/core/core.a(usb_cdcacm.c.o)
0x000000000800fdc5       0x12 /acsi2stm/build.release~/firmware/build.arduino~/Arduino-verbose/build/core/core.a(usb_cdcacm.c.o)
0x000000000800d104       0x10 /acsi2stm/build.release~/firmware/build.arduino~/Arduino-verbose/build/core/core.a(usb_cdcacm.c.o)
0x000000000800fded        0xc /acsi2stm/build.release~/firmware/build.arduino~/Arduino-verbose/build/core/core.a(usb_cdcacm.c.o)
0x000000000800d140        0xc /acsi2stm/build.release~/firmware/build.arduino~/Arduino-verbose/build/core/core.a(usb_cdcacm.c.o)
0x000000000800d134        0xc /acsi2stm/build.release~/firmware/build.arduino~/Arduino-verbose/build/core/core.a(usb_cdcacm.c.o)
0x000000000800ce92        0x8 /acsi2stm/build.release~/firmware/build.arduino~/Arduino-verbose/build/core/core.a(usb.c.o)
0x000000000800fdd7        0x4 /acsi2stm/build.release~/firmware/build.arduino~/Arduino-verbose/build/core/core.a(usb_cdcacm.c.o)
0x000000000800ce9a        0x4 /acsi2stm/build.release~/firmware/build.arduino~/Arduino-verbose/build/core/core.a(usb.c.o)
0x000000000800db0c        0x2 /acsi2stm/build.release~/firmware/build.arduino~/Arduino-verbose/build/core/core.a(usb_core.c.o)
0x000000000800ce90        0x2 /acsi2stm/build.release~/firmware/build.arduino~/Arduino-verbose/build/core/core.a(usb.c.o)
```

Thread 95 (2025-04-16):

Help Needed Low voltage on output of Voltage regulator

BrettRogersUK, 2025-04-16:
I've put together my 0805 board that I made from the source files. However, when I plug in the USB lead I don't get a power LED light up.

I have however, managed to program the STM32 using STM32Cube programming software and the power LED did come on and programming was successful.

I've used my multimeter on the voltage setting and I have 5.27v coming in on the C17 capacitor next to the USB-C port and 5.27v on the LDO regulator input so I know the USB port is working. However, upon checking the output from the regulator I'm only seeing 1.1v coming out. I've tested the LEDs and they are both the right way round and checking the VDD line from the regulator I am only seeing the same 1.1v. Which is probably the reason why they aren't lighting and more to the point why there is absolutely nothing at all coming from the board. The processor cannot start on 1.1v needing at least 3.3v. Markings on the Regulator is 662K which looking at the datasheet (https://www.lcsc.com/datasheet/lcsc_datasheet_2304140030_Torex-Semicon-XC6206P332MR-G_C5446.pdf) does seem to be a 3.3v regulator. Could the regulator be a bad one?

Can anyone tell me what might be wrong and why I am just seeing 1.1v on the output of the regulator on the VDD line? Any ideas what I can try to get it working correctly? I have tried plugging into the Atari just to see if it would work but it didn't.  I'm guessing that the 1.1v out of the regulator has something to do with the problem.

BrettRogersUK, 2025-04-21:
It seems to have been a faulty regulator. Removed it and added another one and now I've got power when I plug the USB-Cable in. Although now I have a new problem which I'm going to raise as another issue.

Closed 2025-04-21.

Thread 96 (2025-04-21):

Nothing coming up on Atari screen when plugging in compact PCB

BrettRogersUK, 2025-04-21:
Hi All,

Now I've sorted the power problem with a faulty regulator I've now got a new issue. When putting the acsi2stm compact PCB into the hard drive port and plug in the USB-C cable to a suitable power supply I get he power LED and Activity LED on steady as per the troubleshooting page.

When I turn my Atari on the Activity LED goes out and the power light is on. The activity light flicks on and off for a short second but I don't get anything on my screen. I have programmed the STM32 chip with the debug firmware to see if anything comes out of the serial port.

Here is the output of the serial port.

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

As you can see it's pretty garbled. I set putty to have the 1MB speed as per the troubleshooting page again. So I don't get anything on the screen about no SD cards detected or anything like that I just a white screen until the desktop appears then I have the normal A & B Icons and the trash can.  When I turn on the atari the output on the serial monitor doesn't change, it stays the same.

When I turn the Atari off the activity light doesn't come back on fully either until I press the reset button I've soldered to the reset pads on the back of the PCB.

I've tried with the strict jumper ON and OFF but it doesn't make a difference.

Anybody know what I can try next? It's annoying as my home made acsi2stm works perfectly using the bluepill board but I wanted a more permanent solution than a perfboard version with lots of wires.

@retro16

Thanks in Advance.

BrettRogersUK, 2025-05-11:
Sorted it, changed the baud rate down to 115200 and changed some parameters in putty and now output is solid on the serial line.

However, I'm still not getting anything on the screen. I've tied PB1-PB5 to 3.3v to disable it and also changed the ACSI_SD_CARDS parameter to 1 in the ACSI2STM.h file but still it's not finding anything but the serial output shows that the SD card is being detected and showing as mountable.

There's just nothing showing on the screen during boot up. I will get pics of the serial output from booting up. I've tried the Masteries version of the device (Old I know) but that one boots up straights away. Detected the sd card, shows the driver message and shows the drive C on the desktop. So I know the port actually works and can communicate and these devices I've built have worked before and worked great but now (all of a sudden) they don't wanna work and I can't fathom why. Last time it was down to fake blue pill boards but that was sorted last time.

I'll get screenshots of the serial output and post up later on.

BrettRogersUK, 2025-05-12:
OK, I've switched now to one of my home built boards that I built a couple years ago that has stopped working for some unknown reason. I've tried reloading the 4.10 firmware with changes to only see 1 SD card.

This is the serial output I get when turning on the Atari:
SD0 36MHz Searching image /acsi2stm/hd0.img ... not found
62333952 blocks rw mountable
Waiting for the ACSI bus ...
--- Ready to go ---
Stack canary 1 died. Reviving.
Stack canary 2 died. Reviving.
Stack canary 4 died. Reviving.
Stack canary 8 died. Reviving.
Stack canary 16 died. Reviving.
Stack canary 32 died. Reviving.
Stack canary 64 died. Reviving.
Stack canary 128 died. Reviving.
[1:8] Not for us
[1:8] Not for us
[3:8] Not for us
[3:8] Not for us
[5:8] Not for us
[5:8] Not for us
[7:8] Not for us
[7:8] Not for us
[1:0]

So from this I can gather that the STM32 Board (known good one from HiLetGo on Amazon that was suggested). All checks on the bluepill board come through with the bluepill diagnostics that the STM32 IC is a true proper one. SO the STM32 board is actually seeing my 32GB SDHC card and seeing that it's mountable and can is set to RW.

However, upon turning the Atari on I don't see anything on the screen and when I get to the desktop it's just the usual A+B drives showing.

My next plan of action is to try the PIO variant of the firmware. But as the Masteries version of the board actually works I don't see that there is a DMA issue.

I have tried the SDFAT example from Arduino (SdFat - Adafruit Fork by Bill Greiman v2.2.54) and this is the output on the serial monitor:

Assuming the SD is the only SPI device.
Edit DISABLE_CS_PIN to disable an SPI device.

Assuming the SD chip select pin is: 4
Edit SD_CS_PIN to change the SD chip select pin.

type any character to start
init time: 153 ms

Card type: SDHC
sdSpecVer: 5.00
HighSpeedMode: false

Manufacturer ID: 0X3
OEM ID: SD
Product: SD32G
Revision: 8.5
Serial number: 0X52CF4A1C
Manufacturing date: 4/2021

cardSize: 31914.98 MB (MB = 1,000,000 bytes)
flashEraseSize: 128 blocks
eraseSingleBlock: true
dataAfterErase: zeros

OCR: 0XC0FF8000

SD Partition Table
part,boot,bgnCHS[3],type,endCHS[3],start,length
1,0X0,0X82,0X3,0X0,0XB,0XFE,0XFF,0XFF,8192,62325760
2,0X0,0X0,0X0,0X0,0X0,0X0,0X0,0X0,0,0
3,0X0,0X0,0X0,0X0,0X0,0X0,0X0,0X0,0,0
4,0X0,0X0,0X0,0X0,0X0,0X0,0X0,0X0,0,0

Scanning FAT, please wait.

Volume is FAT32
sectorsPerCluster: 32
fatStartSector:    8224
dataStartSector:   38688
clusterCount:      1946727
freeClusterCount:  1946726

So from this I can conclude that the STM32 board is actually working but unfortunately not when plugged into the Atari STE. I've not tried it in TOS2.06 yet, only TOS1.62.

@retro16

Thanks,

Brett

BrettRogersUK, 2025-05-13:
Ok, tried the 5.00 firmware in PIO and normal with debugging and verbose but still not working.

Serial monitor output from PIOVERBOSE firmware is as follows:

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

When loading the GEMDRPIO.PRG file i get the following come up:

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

So I haven't a clue what is happening now.

The things have worked and have worked really well in the past but now all of a sudden they don't want to work. Yet I can plug the Masteries one in and it works straight away and I get a C drive on my desktop. As can be seen here:

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

I know the Masteries one works off old firmware but what has changed between that one and the new one that stops this from working first time??

Annoying to say the least.

Regards

Brett

BrettRogersUK, 2025-05-17:
Right then, a little bit more on my issue.

I wonder if anyone can help me with a problem with my ACSI2STM device. I've got the compact one and I had the boards made by JLCPCB I'm using a Sandisk Ultra 32GB card. I'm using a decent power supply with a USB-C cable.

When I turn on the atari the activity light goes out but then when I press a key to abort the memory test (TOS2.06)  the activity light comes on and goes off again. In the serial monitor it does a reset then goes to a waiting for acsi state again.

I cannot for the life of me get the Atari to recognise there is anything there. I've got the 5.00 firmware running on it. As per the serial port it is booting and then not doing much else.

My atari has got a brand new acsi port fitted and all connections have been metered and buzzed out to go to their respective destinations. But it still fails to boot.

I am using the DB19 to IDC20 breakout board as recommended by @jfceklosky and an IDC20 cable.

My atari is a 1040STe with 4MB of RAM, dual switching TOS (1.62 & 2.06), internal gotek with floppy drive swap mod added to boot from external floppy if needed. Gotek works flawlessly and my machine has had all the required mod fixes done as per Exxos site. It is a 001A DMA chip.

The strange thing about it all is that I do have a acsi2stm module by a chap called Masteries on the Atari forum and that one (although based on OLD firmware) does work without hesitation. The Masteries one doesn't work with the newer firmware or the gemdrive feature of the modern devices.

I'm at my wits end to be honest. If anyone could help I would be grateful. I just NEED HELP!

@retro16 @jfceklosky

Serial output from Verbose 5.00 firmware:

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

BrettRogersUK, 2025-05-17:
Upon checking PCBs from JLCPCB found the tiniest sliver of solder bridging two address pins together on the PCB.

Cleared that sliver and it now works. Get a full C drive on desktop and message when booting. Now running on firmware 5.00.

Thanks to @retro16 for all the work he has put into this project!

Kindest Regards,

Brett

Closed 2025-05-17.
