retro16/acsi2stm/pcb/Compact/Schematic - ACSI2STM Compact.pdf

## GND GND

## GND

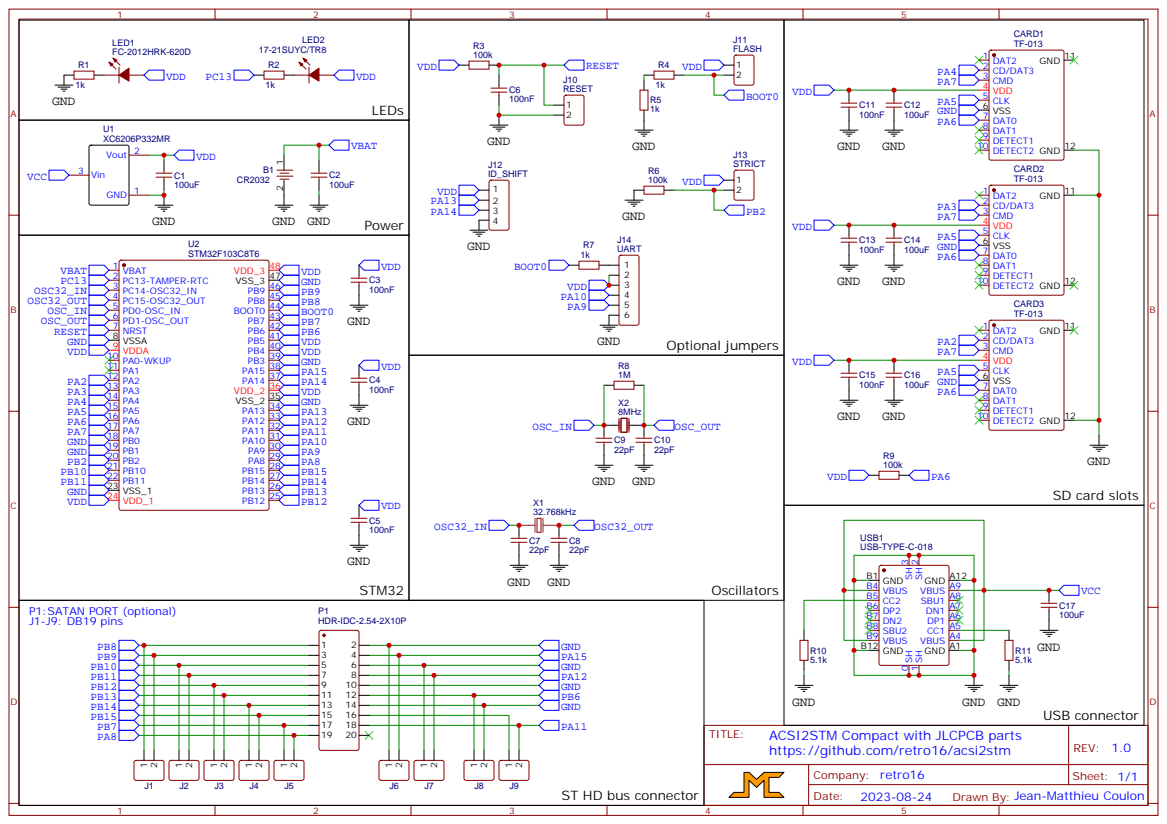
[picture p15: page 1]

ST HD bus connector

Drawn By: Jean-Matthieu Coulon
