retro16/acsi2stm/(list of files, drawings)

Other design files:
pcb/Compact/PCB - ACSI2STM Compact.json
pcb/Compact/Schematic - ACSI2STM Compact.json
