retro16/acsi2stm/pcb/MegaSTE Internal/ACSI2STM MegaSTE.kicad_pcb

## KiCad design pcb/MegaSTE Internal/ACSI2STM MegaSTE.kicad_pcb (2022-08-04)

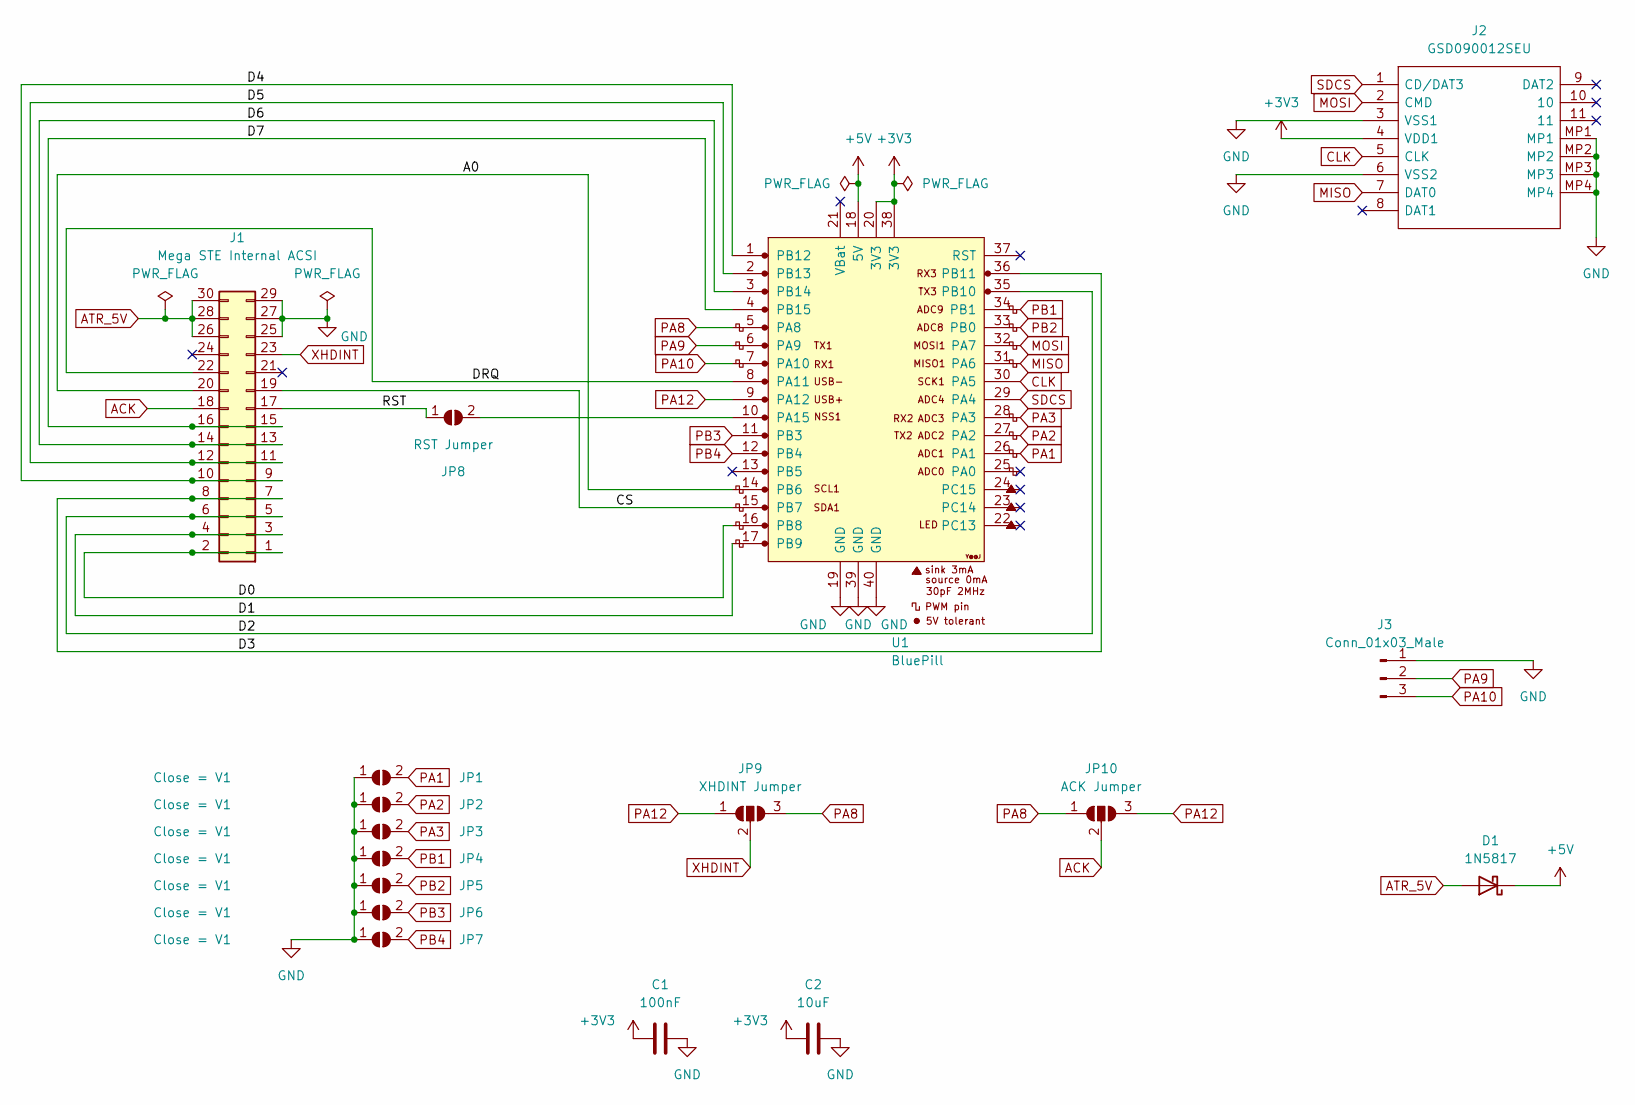
[picture p16: schematic ACSI2STM MegaSTE.kicad_sch, Atari Mega STE ACSI2STM Internal adapter]

Parts:
C1: 100nF; C_Disc_D4.3mm_W1.9mm_P5.00mm
C2: 10uF; C_Radial_D5.0mm_H5.0mm_P2.00mm
D1: 1N5817; D_DO-41_SOD81_P10.16mm_Horizontal
J1: Mega STE Internal ACSI; PinSocket_2x15_P2.54mm_Vertical
J2: GSD090012SEU; Mouser Part Number 523-GSD090012SEU
J3: Conn_01x03_Male; PinHeader_1x03_P2.54mm_Vertical
JP1, JP2, JP3, JP4, JP5, JP6, JP7: Close = V1; SolderJumper-2_P1.3mm_Open_Pad1.0x1.5mm
JP8: RST Jumper; SolderJumper-2_P1.3mm_Open_RoundedPad1.0x1.5mm
JP9: XHDINT Jumper; SolderJumper-3_P1.3mm_Open_RoundedPad1.0x1.5mm
JP10: ACK Jumper; SolderJumper-3_P1.3mm_Open_RoundedPad1.0x1.5mm
U1: BluePill; YAAJ_BluePill_1

Connections:
+3V3: C1.1, C2.1, J2.4 (VDD1), U1.20 (3V3), U1.38 (3V3)
+5V: D1.1 (K), U1.18 (5V)
/A0: J1.20, U1.14 (PB6)
/CS: J1.19, U1.15 (PB7)
/D0: J1.1, J1.2, U1.16 (PB8)
/D1: J1.3, J1.4, U1.17 (PB9)
/D2: J1.5, J1.6, U1.35 (PB10)
/D3: J1.7, J1.8, U1.36 (PB11)
/D4: J1.9, J1.10, U1.1 (PB12)
/D5: J1.11, J1.12, U1.2 (PB13)
/D6: J1.13, J1.14, U1.3 (PB14)
/D7: J1.15, J1.16, U1.4 (PB15)
/DRQ: J1.22, U1.8 (PA11)
/RST: J1.17, JP8.1 (A)
ACK: J1.18, JP10.2 (C)
ATR_5V: D1.2 (A), J1.26, J1.28, J1.30
CLK: J2.5 (CLK), U1.30 (PA5)
GND: C1.2, C2.2, J1.25, J1.27, J1.29, J2.3 (VSS1), J2.6 (VSS2), J2.MP1, J2.MP2, J2.MP3, J2.MP4, J3.1, JP1.1 (A), JP2.1 (A), JP3.1 (A), JP4.1 (A), JP5.1 (A), JP6.1 (A), JP7.1 (A), U1.19 (GND), U1.39 (GND), U1.40 (GND)
MISO: J2.7 (DAT0), U1.31 (PA6)
MOSI: J2.2 (CMD), U1.32 (PA7)
unnamed: JP8.2 (B), U1.10 (PA15)
PA1: JP1.2 (B), U1.26 (PA1)
PA2: JP2.2 (B), U1.27 (PA2)
PA3: JP3.2 (B), U1.28 (PA3)
PA8: JP9.3 (B), JP10.1 (A), U1.5 (PA8)
PA9: J3.2, U1.6 (PA9)
PA10: J3.3, U1.7 (PA10)
PA12: JP9.1 (A), JP10.3 (B), U1.9 (PA12)
PB1: JP4.2 (B), U1.34 (PB1)
PB2: JP5.2 (B), U1.33 (PB0)
PB3: JP6.2 (B), U1.11 (PB3)
PB4: JP7.2 (B), U1.12 (PB4)
SDCS: J2.1 (CD/DAT3), U1.29 (PA4)
XHDINT: J1.23, JP9.2 (C)

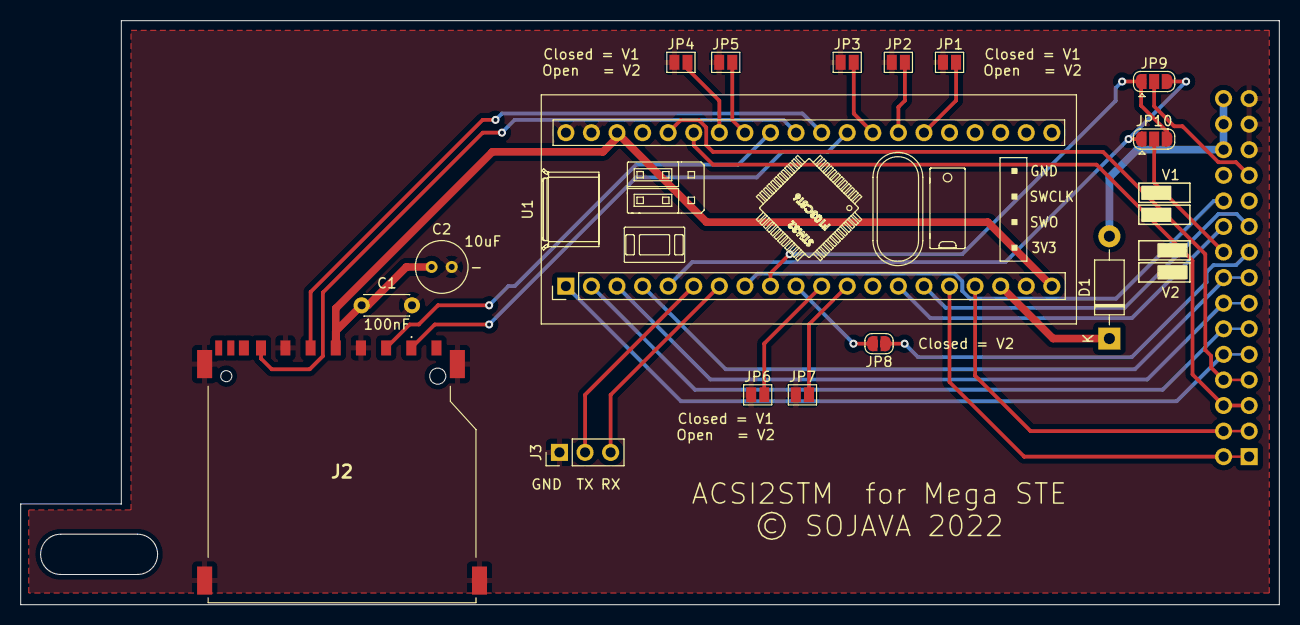
[picture p17: board ACSI2STM MegaSTE.kicad_pcb from above]

Board: 2 copper layers, 125.0 x 58.0 mm, 17 parts (1 on the bottom side), 34 nets.
