retro16/acsi2stm/acsi2stm/SysHook.cpp

/* ACSI2STM Atari hard drive emulator
 * Copyright (C) 2019-2024 by Jean-Matthieu Coulon
 *
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
 * You should have received a copy of the GNU General Public License
 * along with the program.  If not, see <http://www.gnu.org/licenses/>.
 */

#include "SysHook.h"

Long SysHook::stackAlloc(int bytes)
{
  // Read the stack pointer address
  pushSp();
  Long sp;
  read(sp);

  // Allocate on the stack, compensating for the 4 bytes of pushSp
  shiftStack(4 - bytes);

  // Return
  return ToLong(sp - bytes);
}

void SysHook::sendAt(uint32_t address, const uint8_t *bytes, int count)
{
  if(count <= 0)
    return;

#if ! ACSI_PIO
  if(count < 16 || !isDma(address + count - 1)) {
    // Indirect copy

    shiftStack(-32);

    uint8_t data[32];

    while(count > 0) {
      int c = count > 30 ? 30 : count;
      Word dCount = ToWord(c - 1);
      data[0] = dCount.bytes[0];
      data[1] = dCount.bytes[1];
      memcpy(&data[2], bytes, c);
      shiftStack(0);
      sendDma(data, 32);
      copyFromStack(address);

      address += c;
      bytes += c;
      count -= c;
    }

    shiftStack(32);
    return;
  }

  if(address & 1) {
    // Unaligned access: write the first byte indirectly
    sendAt(address, bytes, 1);
    ++address;
    ++bytes;
    --count;
  }

  while(count >= 16) {
    int blockSize = count & 0x1fff0;

    setDmaRead(address);
    sendDma(bytes, blockSize);

    address += blockSize;
    bytes += blockSize;
    count -= blockSize;
  }

  if(count > 0)
    sendAt(address, bytes, count);
#else
  setDmaRead(address);
  sendDma(bytes, count);
#endif
}

void SysHook::readAt(uint8_t *bytes, uint32_t source, int count)
{
  if(count <= 0)
    return;

#if ! ACSI_PIO
  if(!isDma(source + count - 1)) {
    // Read from outside DMA RAM: use slow indirect copy
    readAtIndirect(bytes, source, count);
    return;
  }

  if(source & 1) {
    // Unaligned access: read first byte in indirect mode
    *bytes = readByteAt(source);
    ++bytes;
    ++source;
    --count;
  }

  if(count > 0) {
    setDmaWrite(source);
    readDma(bytes, count);
  }
#else
  setDmaWrite(source);
  readDma(bytes, count);
#endif
}

uint8_t SysHook::readByteAt(ToLong address)
{
  readByteToStack(address);
  uint8_t data;
  readDma((uint8_t *)&data, sizeof(data));
  shiftStack(2);
  return data;
}

Word SysHook::readWordAt(ToLong address)
{
  readWordToStack(address);
  Word data;
  readDma((uint8_t *)&data, sizeof(data));
  shiftStack(2);
  return data;
}

Long SysHook::readLongAt(ToLong address)
{
  readLongToStack(address);
  Long data;
  readDma((uint8_t *)&data, sizeof(data));
  shiftStack(4);
  return data;
}

void SysHook::readStringAt(char *bytes, ToLong address, int count)
{
  if(!count)
    return;

  if(!isDma(address))
    return readStringAtIndirect(bytes, address, count);

  if(address.bytes[3] & 1) {
    // Unaligned access
    *bytes = readByteAt(address);
    if(!*bytes)
      return;

    --count;
    if(!count)
      return;

    ++address;
    ++bytes;
  }
  setDmaWrite(address);
  readDmaString(bytes, count);
}

void SysHook::clearAt(uint32_t bytes, uint32_t address) {
  uint8_t blank[32] = {0,0,0,0,0,0,0,0,0,0,0,0,0,0,0,0,
                       0,0,0,0,0,0,0,0,0,0,0,0,0,0,0,0};

#if ! ACSI_PIO
  if(!isDma(address + bytes - 1)) {
    // Upload some blank bytes on the stack
    shiftStack(-32);
    sendDma(blank, 32);

    while(bytes > 0) {
      int c = bytes > 32 ? 32 : bytes;

      push(ToWord(c - 1));
      copyFromStack(address);
      shiftStack(2);

      address += c;
      bytes -= c;
    }

    // Free data from stack
    shiftStack(32);

    return;
  }

  if(address & 1) {
    sendAt(address, blank, 1);
    ++address;
    --bytes;
  }

  if(bytes >= 16) {
    setDmaRead(address);
    DmaPort::fillDma(0, bytes & 0xfffffff0);
    address += bytes & 0xfffffff0;
    bytes -= bytes & 0xfffffff0;
  }

  if(bytes)
    sendAt(address, blank, bytes);
#else
  setDmaRead(address);
  sendCommandNoWait(0x99, bytes);
  DmaPort::repeatIrqFast(0, bytes);
#endif
}

void SysHook::readDma(uint8_t *bytes, int count)
{
  if(!count)
    return;
#if ACSI_PIO
  sendCommandNoWait(0x98, count);
  DmaPort::readIrqFast(bytes, count);
#else
  DmaPort::readDma(bytes, count);
#endif
}

void SysHook::readDmaString(char *bytes, int count)
{
  if(!count)
    return;
#if ACSI_PIO
  for(int i = 0; i < count; ++i) {
    sendCommandNoWait(0x98, 1);
    DmaPort::readIrqFast((uint8_t *)&bytes[i], 1);
    if(!bytes[i])
      return;
  }
#else
  DmaPort::readDmaString(bytes, count);
#endif
}

void SysHook::sendDma(const uint8_t *bytes, int count)
{
  if(!count)
    return;
#if ACSI_PIO
  sendCommandNoWait(0x99, count);
  DmaPort::sendIrqFast(bytes, count);
#else
  DmaPort::sendDma(bytes, count);
#endif
}

uint8_t SysHook::readByte()
{
  uint8_t data;
  readDma((uint8_t *)&data, sizeof(data));
  return data;
}

Word SysHook::readWord()
{
  Word data;
  readDma((uint8_t *)&data, sizeof(data));
  return data;
}

Long SysHook::readLong()
{
  Long data;
  readDma((uint8_t *)&data, sizeof(data));
  return data;
}

void SysHook::readAtIndirect(uint8_t *bytes, ToLong source, int count) {
  if(count <= 14) {
    readAtIndirectShort(bytes, source, count);
    return;
  }

  // Make room for a 32 bytes buffer on the ST stack
  shiftStack(-32);
  while(count) {
    int l = count > 32 ? 32 : count;

    // Write byte count on the stack
    push(ToWord(l - 1));

    // Do the copy on the ST side
    copyToStack(source);

    // Fetch data
    readDma(bytes, l);

    // Pop byte count
    shiftStack(2);

    count -= l;
    bytes += l;
    source += l;
  }
  shiftStack(32);
}

void SysHook::readAtIndirectShort(uint8_t *bytes, ToLong source, int count) {
  shiftStack(-16);

  ToLong cmd[4] = {0, 0, 0, 0};
  cmd[0].bytes[1] = count - 1; // Adjust for dbra
  send(cmd);

  // Do the actual read on the ST
  copyToStack(source);

  // Fetch result
  readDma(bytes, count);

  // Free stack buffer
  shiftStack(16);
}

void SysHook::readStringAtIndirect(char *bytes, ToLong source, int count) {
  // Make room for a 32 bytes buffer on the ST stack, plus a byte count word
  shiftStack(-32);
  while(count) {
    int l = count > 32 ? 32 : count;

    // Write byte count on the stack
    push(ToWord(l - 1));

    // Do the copy on the ST side
    copyToStack(source);

    // Fetch data in a temporary buffer and do string copy from there
    {
      uint8_t lbuf[32];
      readDma(lbuf, l);
      for(int i = 0; i < l; ++i) {
        bytes[i] = (char)lbuf[i];
        if(!lbuf[i]) {
          shiftStack(2);
          goto end_of_string;
        }
      }
    }

    shiftStack(2);

    count -= l;
    bytes += l;
    source += l;
  }
end_of_string:
  shiftStack(32);
}

// Low level hook commands implementation

void SysHook::rte(int8_t value) {
  if(value <= (int8_t)0x9a)
    rte(ToLong(value));
  dbgHex("rte(", (uint32_t)(uint8_t)value, ") ");
  DmaPort::sendIrq(value);
}

void SysHook::forward() {
  dbg("forward ");
  DmaPort::sendIrq(0x9a);
}

void SysHook::trap1() {
  sendCommand(0x96, 0);
}

void SysHook::pushSp() {
  sendCommand(0x94, 0);
}

void SysHook::push(ToWord value) {
  sendCommand(0x92, ToLong(value));
}

void SysHook::shiftStack(ToLong offset) {
  sendCommand(0x91, offset);
}

void SysHook::readByteToStack(ToLong address) {
  sendCommand(0x8e, address);
}

void SysHook::readWordToStack(ToLong address) {
  sendCommand(0x8c, address);
}

void SysHook::readLongToStack(ToLong address) {
  sendCommand(0x8a, address);
}

void SysHook::pexec4ThenRte(ToLong pd) {
  sendCommandNoWait(0x88, pd);
}

void SysHook::pexec6ThenRte(ToLong pd) {
  sendCommandNoWait(0x86, pd);
}

void SysHook::setDmaRead(ToLong address)
{
  sendCommand(0x85, address);
}

void SysHook::setDmaWrite(ToLong address)
{
  sendCommand(0x84, address);
}

void SysHook::copyFromStack(ToLong address)
{
  sendCommand(0x83, address);
}

void SysHook::copyToStack(ToLong address)
{
  sendCommand(0x82, address);
}

void SysHook::rte(ToLong value) {
  dbgHex("rte(", (uint32_t)value, ") ");
  sendCommandNoWait(0x80, value);
}

void SysHook::waitCommand() {
  DmaPort::waitCs();
  verboseHex("[{]");
  DmaPort::armCs();
}

void SysHook::sendCommand(int command, ToLong param)
{
  sendCommandNoWait(command, param);
  waitCommand();
}

void SysHook::sendCommandNoWait(int command, ToLong param)
{
  uint8_t bytes[5];
  bytes[0] = command;
  bytes[1] = param.bytes[0];
  bytes[2] = param.bytes[1];
  bytes[3] = param.bytes[2];
  bytes[4] = param.bytes[3];
  DmaPort::sendIrqFast(bytes, 5);
}

// vim: ts=2 sw=2 sts=2 et
