retro16/acsi2stm/acsi2stm/Monitor.h

/* ACSI2STM Atari hard drive emulator
 * Copyright (C) 2019-2024 by Jean-Matthieu Coulon
 *
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
 * You should have received a copy of the GNU General Public License
 * along with the program.  If not, see <http://www.gnu.org/licenses/>.
 */

#ifndef MONITOR_H
#define MONITOR_H

#include "acsi2stm.h"

// Monitoring functions
class Monitor {
public:

#if ACSI_ACTIVITY_LED
  static void ledSet(int l) {
    if(l)
      ledOn();
    else
      ledOff();
  }
  static void ledOn() {
    GPIOC->regs->CRH |= 0x00300000; // Set PC13 to 50MHz push-pull output
    GPIOC->regs->BRR = 1 << 13;
  }
  static void ledOff() {
    GPIOC->regs->CRH |= 0x00300000; // Set PC13 to 50MHz push-pull output
    GPIOC->regs->BSRR = 1 << 13;
  }
#else
  static void ledOn() {
  }
  static void ledOff() {
  }
  static void ledSet(int l) {
  }
#endif

// Debug output functions

  static void beginDbg(int speed = ACSI_SERIAL_SPEED) {
#if ACSI_DEBUG
    ACSI_SERIAL.begin(speed);
#else
    (void)speed;
#endif
  }

  static void flushDbg() {
#if ACSI_DEBUG
    ACSI_SERIAL.flush();
#endif
  }

  template<typename T>
  static void dbg(T txt) {
#if ACSI_DEBUG
    ACSI_SERIAL.print(txt);
    flushDbg();
#else
    (void)txt;
#endif
  }

  template<typename T, typename... More>
  static void dbg(T txt, More... more) {
    dbg(txt);
    dbg(more...);
  }

  template<typename... T>
  static void ignore(T...) {
  }

  template<typename... T>
  static void verbose(T... txt) {
#if ACSI_VERBOSE
    dbg(txt...);
#else
    ignore(txt...);
#endif
  }

  template<typename T>
  static void dbgHex(T txt) {
#if ACSI_DEBUG
    ACSI_SERIAL.print(txt, HEX);
    flushDbg();
#else
    (void)txt;
#endif
  }

  static void dbgHex(char txt) {
    dbg(txt);
  }

  static void dbgHex(const char *txt) {
    dbg(txt);
  }

  template<typename T, typename... More>
  static void dbgHex(T txt, More... more) {
    dbgHex(txt);
    dbgHex(more...);
  }

  template<typename... T>
  static void verboseHex(T... txt) {
#if ACSI_VERBOSE
    dbgHex(txt...);
#else
    ignore(txt...);
#endif
  }

  static void dump(const void *data_, int size, int maxSize = ACSI_DUMP_LEN) {
#if ACSI_DEBUG
    const uint8_t *data = (const uint8_t *)data_;
    dbg("(", size, " bytes)");

    if(maxSize) {
      int dumpSize = size;
      if(maxSize > 0 && maxSize < size)
        dumpSize = maxSize;

      dbg(':');
      for(int i = 0; i < dumpSize; ++i)
        dbgHex(' ', data[i]);

      if(size > maxSize)
        dbg(" [...]");
    }
#else
    (void)data_;
    (void)size;
    (void)maxSize;
#endif
  }

  // Dump only if not in verbose mode
  static void notVerboseDump(const void *data_, int size, int maxSize = ACSI_DUMP_LEN) {
#if ! ACSI_VERBOSE
    dump(data_, size, maxSize);
#else
    (void)data_;
    (void)size;
    (void)maxSize;
#endif
  }

  static void verboseDump(const void *data_, int size, int maxSize = ACSI_DUMP_LEN) {
#if ACSI_VERBOSE
    dump(data_, size, maxSize);
#else
    (void)data_;
    (void)size;
    (void)maxSize;
#endif
  }

  static void dumpln(const void *data_, int size, int maxSize = ACSI_DUMP_LEN) {
#if ACSI_DEBUG
    dump(data_, size, maxSize);
    dbg('\n');
#else
    (void)data_;
    (void)size;
    (void)maxSize;
#endif
  }

  static void verboseDumpln(const void *data_, int size, int maxSize = ACSI_DUMP_LEN) {
#if ACSI_VERBOSE
    dumpln(data_, size, maxSize);
#else
    (void)data_;
    (void)size;
    (void)maxSize;
#endif
  }
};

#endif
