retro16/acsi2stm/acsi2stm/TinyFile.cpp

/* ACSI2STM Atari hard drive emulator
 * Copyright (C) 2019-2024 by Jean-Matthieu Coulon
 *
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
 * You should have received a copy of the GNU General Public License
 * along with the program.  If not, see <http://www.gnu.org/licenses/>.
 */

// We are going to torture low-level data structures
// If the library changes too much, it's not guaranteed to work anymore.
#define private public
#include <SdFat.h>
#undef private

#include "TinyFile.h"

TinyFile::TinyFile() : index(0) {
}

void TinyFile::set(uint32_t mediaId_, FsFile &parent, FsFile &file) {
  mediaId = mediaId_;
  dirCluster = getCluster(parent);
  index = file.dirIndex() + 1;
};

void TinyFile::set(uint32_t mediaId_, FsFile &parent) {
  mediaId = mediaId_;
  dirCluster = getCluster(parent);
  index = 0;
};

FsFile & TinyFile::open(FsVolume &volume, oflag_t oflag) const {
  // Easy case
  if(!index) {
    closeLast();
    return lastFile;
  }

  // Open the parent directory
  openParent(volume);

  // Find the file with the correct index
  if(!lastParent)
    return lastFile;

  lastFile.open(&lastParent, index - 1, oflag);

  return lastFile;
}

FsFile & TinyFile::openNext(FsVolume &volume, oflag_t oflag) {
  openParent(volume);

  if(!lastParent)
    return lastFile;

  if(index) {
    lastFile.open(&lastParent, index - 1);
    if(lastFile) {
      lastFile.openNext(&lastParent);
    } else {
      // File deleted, or something like that: restart
      lastParent.rewind();
      for(;;) {
        lastFile.openNext(&lastParent);
        if(!lastFile || (int)(lastFile.dirIndex()) >= (int)(index - 1))
          break;
      }
    }
  } else {
    lastParent.rewind();
    lastFile.openNext(&lastParent);
  }

  if(lastFile) {
    index = lastFile.dirIndex() + 1;
    if(oflag != O_RDONLY) {
      lastFile.close();
      lastFile.open(&lastParent, (index - 1), oflag);
    }
  } else {
    index = 0;
  }

  return lastFile;
}

FsFile & TinyFile::openParent(FsVolume &volume) const {
  closeLast();

  if(!dirCluster) {
    // File is in the root directory
    lastParent.openRoot(&volume);
  } else {
    // Find any directory to inject data into the structure (evil grin)
    lastFile.openRoot(&volume);
    while(lastParent.openNext(&lastFile, O_RDONLY) && !lastParent.isDir());
    if(lastParent)
      // Found a directory handle to inject the cluster in it
      setCluster(lastParent, dirCluster);
  }

  lastMediaId = mediaId;

  return lastParent;
}

void TinyFile::close() {
  index = 0;
  closeLast();
}

uint32_t TinyFile::getCluster(FsFile &file) {
  if(!file.isSubDir() && file.isDir())
    // Root directory
    return 0;

  uint32_t cluster;
  uint64_t position = file.curPosition();
  file.rewind();
  if(file.m_fFile)
    cluster = file.m_fFile->m_firstCluster;
  else
    cluster = file.m_xFile->m_firstCluster;
  file.sync();
  file.seekSet(position);
  return cluster;
}

void TinyFile::setCluster(FsFile &file, uint32_t cluster) {
  file.rewind();
  if(file.m_fFile)
    file.m_fFile->m_firstCluster = cluster;
  else
    file.m_xFile->m_firstCluster = cluster;
}

void TinyFile::closeLast() {
  lastFile.close();
  lastParent.close();
  lastMediaId = 0;
}

void TinyFile::ejected(uint32_t mediaId) {
  // Called on SD card hot swap
  if(mediaId == lastMediaId) {
    lastFile = FsFile();
    lastParent = FsFile();
    lastMediaId = 0;
  }
}

FsFile TinyFile::lastFile;
FsFile TinyFile::lastParent;
uint32_t TinyFile::lastMediaId;
