retro16/acsi2stm/acsi2stm/Acsi.h

/* ACSI2STM Atari hard drive emulator
 * Copyright (C) 2019-2024 by Jean-Matthieu Coulon
 *
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
 * You should have received a copy of the GNU General Public License
 * along with the program.  If not, see <http://www.gnu.org/licenses/>.
 */

#ifndef ACSI_H
#define ACSI_H

#include "acsi2stm.h"

#include "Devices.h"
#include "BlockDev.h"

#include <Arduino.h>
#include <SdFat.h>

class Acsi: public Monitor, public Devices {
public:
  // SCSI error code in ASCQ_ASC_KEY format (see SCSI KCQ)
  enum ScsiErr {
    ERR_OK = 0x000000,
    ERR_READERR = 0x001103,
    ERR_WRITEERR = 0x000c03,
    ERR_WRITEPROT = 0x002707,
    ERR_OPCODE = 0x002005,
    ERR_INVADDR = 0x002105,
    ERR_INVARG = 0x002405,
    ERR_INVLUN = 0x002505,
    ERR_MEDIUMCHANGE = 0x002806,
    ERR_NOMEDIUM = 0x003a02,
  };

  enum MediumState {
    MEDIUM_OK = 0,
    MEDIUM_REMOVED,
    MEDIUM_CHANGED,
  };

  Acsi(SdDev &card_): blockDev(card_) {}

  // Called during Atari reset, after SdDev::onReset()
  void onReset();

  // Check the SD card.
  // Sets lastErr to
  //   ERR_MEDIUMCHANGE if the card was swapped
  //   ERR_NOMEDIUM if the card was removed
  // otherwise, leaves lastErr unchanged
  void refresh();

  // Command processing. Pass the first command byte (without the device id).
  // This function will read all subsequent bytes as needed.
  void process(uint8_t cmd);

  // Read command bytes and updates cmdBuf and cmdLen.
  void readCmdBuf(uint8_t cmd);

  // Return true if the LUN field is valid.
  bool validLun();

  // Return the LUN for the current command.
  int getLun();

  // Send a status and get ready for the next command.
  // Also updates lastErr, lastSeek and lastBlock.
  void commandStatus(ScsiErr err, uint32_t lastBlock);
  void commandStatus(ScsiErr err);
  void sendCommandStatus();

  // Process block I/O requests
  ScsiErr processBlockRead(uint32_t block, int count);
  ScsiErr processBlockWrite(uint32_t block, int count);

  // SCSI commands
  void modeSense0(uint8_t *outBuf);
  void modeSense4(uint8_t *outBuf);

  // Block device definition
  SdDev &blockDev;

  // Last media ID
  uint32_t mediaId = 0;

  // SCSI status variables
  ScsiErr lastErr;
  bool lastSeek;
  MediumState lastMediumState = MEDIUM_OK;
  uint32_t lastBlock;

  // Command buffer
  static int cmdLen;
  static uint8_t cmdBuf[16];
};

#endif
// vim: ts=2 sw=2 sts=2 et
