retro16/acsi2stm/acsi2stm/Devices.h

/* ACSI2STM Atari hard drive emulator
 * Copyright (C) 2019-2024 by Jean-Matthieu Coulon
 *
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
 * You should have received a copy of the GNU General Public License
 * along with the program.  If not, see <http://www.gnu.org/licenses/>.
 */

#ifndef DEVICES_H
#define DEVICES_H

#include "acsi2stm.h"

#include <RTClock.h>

// ACSI protocol block size
#define ACSI_BLOCKSIZE 512

struct SdDev;
struct Acsi;
#if ! ACSI_STRICT
struct GemDrive;
#endif

// Globals associated to devices and configuration
struct Devices {
  static SdDev sdSlots[];
  static Acsi acsi[];
#if ! ACSI_STRICT
  static GemDrive drives[];
#endif

  // Sense jumper settings
  static void sense();

  static const int sdCount = ACSI_SD_CARDS;
  static int acsiDeviceMask;
#if ! ACSI_STRICT
  static int gemDriveMask;
  static int gemBootDrive; // Set to 8 if no boot drive
  static void updateGemBootDrive();
  static void attachGemDrive(int slot);
#endif

  static void attachAcsi(int slot);
  static void detach(int slot);

  // Realtime clock
  static RTClock rtc;
  static void getDateTime(uint16_t *date, uint16_t *time);
  static void setDateTime(uint16_t date, uint16_t time);
  static bool isDateTimeSet();

#if ACSI_STRICT
  static const bool strict = true;
#else
  // When true, all SD cards behave like ACSI hard drives
  static bool strict;
#endif

#if ACSI_ID_OFFSET_PINS

#if ACSI_FIRST_ID
#error ACSI_FIRST_ID must be 0 to use ACSI_ID_OFFSET_PINS
#endif
  static int acsiFirstId;

#else

#if ACSI_FIRST_ID + ACSI_SD_CARDS > 7
#error ACSI_FIRST_ID is too high, the last SD card would be unreachable
#endif
  static const int acsiFirstId = ACSI_FIRST_ID;

#endif

  // Common data buffer
  static const int bufSize = ACSI_BLOCKSIZE * ACSI_BLOCKS;
  static uint8_t buf[bufSize];

  // Compute the 16 bits checksum of a block.
  static int computeChecksum(uint8_t *block);

  // Output a human-readable string of a block count.
  // Updates the 4 first bytes of target.
  static void blocksToString(uint32_t blocks, char *target);
};

// vim: ts=2 sw=2 sts=2 et
#endif
