retro16/acsi2stm/acsi2stm/syshook.boot.h

unsigned char syshook_boot_bin[] = {
  0x60, 0x04, 0x00, 0xff, 0x00, 0xff, 0x48, 0xe7, 0x60, 0xe0, 0x10, 0x07,
  0x60, 0x00, 0x00, 0x70, 0x08, 0x2f, 0x00, 0x05, 0x00, 0x1c, 0x67, 0x0a,
  0x34, 0x3a, 0xff, 0xea, 0x45, 0xf7, 0x20, 0x1c, 0x4e, 0x75, 0x4e, 0x6a,
  0x4e, 0x75, 0x58, 0x42, 0x52, 0x41, 0x41, 0x32, 0x53, 0x54, 0x00, 0x00,
  0x00, 0xb8, 0x2f, 0x3a, 0xff, 0xfa, 0x4a, 0x38, 0x04, 0x3e, 0x67, 0x02,
  0x4e, 0x75, 0x70, 0x10, 0x60, 0x36, 0x58, 0x42, 0x52, 0x41, 0x41, 0x32,
  0x53, 0x54, 0x00, 0x00, 0x00, 0xb4, 0x2f, 0x3a, 0xff, 0xfa, 0x4a, 0x38,
  0x04, 0x3e, 0x67, 0x02, 0x4e, 0x75, 0x70, 0x0f, 0x60, 0x1a, 0x58, 0x42,
  0x52, 0x41, 0x41, 0x32, 0x53, 0x54, 0x00, 0x00, 0x00, 0x84, 0x2f, 0x3a,
  0xff, 0xfa, 0x4a, 0x38, 0x04, 0x3e, 0x67, 0x02, 0x4e, 0x75, 0x70, 0x0e,
  0x48, 0xe7, 0x60, 0xe0, 0x61, 0x92, 0x80, 0x3a, 0xff, 0x83, 0x50, 0xf8,
  0x04, 0x3e, 0x61, 0x00, 0x00, 0xfc, 0x20, 0xbc, 0x00, 0xff, 0x01, 0x88,
  0x22, 0x3c, 0x01, 0x00, 0x00, 0x00, 0x12, 0x00, 0x48, 0x41, 0x20, 0x81,
  0x08, 0x38, 0x00, 0x05, 0xfa, 0x01, 0x66, 0xf8, 0x32, 0xbc, 0x00, 0x8a,
  0x30, 0x10, 0xb0, 0x3c, 0x00, 0x8b, 0x67, 0x10, 0x6d, 0x2a, 0x48, 0x80,
  0x48, 0xc0, 0x61, 0x10, 0x4c, 0xdf, 0x07, 0x06, 0x58, 0x4f, 0x4e, 0x73,
  0x61, 0x06, 0x4c, 0xdf, 0x07, 0x06, 0x4e, 0x75, 0x31, 0xfc, 0x01, 0x90,
  0x86, 0x06, 0x21, 0xfc, 0x00, 0x00, 0x00, 0x8a, 0x86, 0x04, 0x51, 0xf8,
  0x04, 0x3e, 0x4e, 0x75, 0x48, 0x40, 0x74, 0x03, 0x30, 0x10, 0xe1, 0x89,
  0x12, 0x00, 0x51, 0xca, 0xff, 0xf8, 0x48, 0x40, 0x14, 0x00, 0xc4, 0x7c,
  0x00, 0x0e, 0x34, 0x3b, 0x20, 0x06, 0x4e, 0xfb, 0x20, 0x02, 0x00, 0x5c,
  0x00, 0x40, 0x00, 0x2c, 0x00, 0x14, 0x00, 0x10, 0x00, 0x0c, 0x20, 0x01,
  0x60, 0xac, 0x70, 0x04, 0x60, 0x02, 0x70, 0x06, 0x61, 0xb6, 0x61, 0x00,
  0xfe, 0xfc, 0x54, 0x4a, 0x34, 0xc0, 0x42, 0x9a, 0x24, 0xc1, 0x42, 0x9a,
  0x4c, 0xdf, 0x07, 0x06, 0x4e, 0x75, 0x41, 0xfa, 0x00, 0x08, 0x20, 0x81,
  0x31, 0x40, 0x00, 0x7a, 0x4e, 0x71, 0x4e, 0x71, 0x30, 0x3a, 0x00, 0x74,
  0x22, 0x0f, 0x24, 0x41, 0x08, 0x00, 0x00, 0x00, 0x67, 0x30, 0x61, 0x40,
  0x32, 0xbc, 0x00, 0x90, 0x20, 0xbc, 0x00, 0xff, 0x00, 0x8a, 0x72, 0x00,
  0x20, 0x81, 0x60, 0x00, 0xff, 0x48, 0x22, 0x4f, 0x34, 0x19, 0x24, 0x49,
  0x20, 0x41, 0x08, 0x00, 0x00, 0x00, 0x67, 0x08, 0x10, 0xd9, 0x51, 0xca,
  0xff, 0xfc, 0x60, 0xd6, 0x12, 0xd8, 0x51, 0xca, 0xff, 0xfc, 0x61, 0x10,
  0x20, 0xbc, 0x00, 0xff, 0x01, 0x8a, 0x20, 0xbc, 0x00, 0x88, 0x01, 0x00,
  0x60, 0x00, 0xff, 0x1a, 0x4c, 0xba, 0x03, 0x00, 0x00, 0x1e, 0x32, 0xbc,
  0x00, 0x90, 0x32, 0xbc, 0x01, 0x90, 0x22, 0x0a, 0x11, 0xc1, 0x86, 0x0d,
  0xe0, 0x89, 0x11, 0xc1, 0x86, 0x0b, 0xe0, 0x89, 0x11, 0xc1, 0x86, 0x09,
  0x4e, 0x75, 0x86, 0x04, 0x86, 0x06
};
unsigned int syshook_boot_bin_len = 426;
