retro16/acsi2stm/(commit log)

2019-03-09 Better explanation for SD wiring
2021-04-23 ACSI2STM v2.0 beta. Solves timing issues and improves stability a lot.
    [acsi2stm.ino]
2021-04-29 Ported to the newer SdFat library (removed shipped Sd2CardX). Small bug fixes and adjustments.
    [acsi2stm.ino]
2021-05-02 Version 2.0
    Complete code refactor.
    Fixed timing problems.
    Fixed protocol issues.
    Better verbose output.
    Added support for disk images.
    [Acsi.cpp, Acsi.h, Watchdog.cpp, acsi2stm.h, acsi2stm.ino]
2021-05-04 Removed logs between commandSuccess and waitCommand as this may cause command skip in debug mode.
    [Acsi.cpp]
2021-07-29 Use a hardware timer for CS and A1 pulses. Added optional hardware filters for ACK and CS signals.
2022-03-01 v2.2: Slower DMA and SD for better compatibility. Updated README.
2022-03-20 2.3 beta 2. Watchdog activated, proper removable media support, cleaner error handling.
    [Acsi.cpp, Acsi.h, BlockDev.cpp, BlockDev.h, DmaPort.cpp, DmaPort.h, Watchdog.cpp, acsi2stm.h]
2022-03-21 2.31: Slowed down ACSI bus wait to accomodate for slower chips. Shorter watchdog. Fixed version in the user manual.
    [Acsi.cpp, DmaPort.cpp, acsi2stm.h, acsi2stm.ino]
2022-03-23 2.4a: self-test tool, pins changed, strict mode, many bug fixes
    [Acsi.cpp, Acsi.h, BlockDev.cpp, BlockDev.h, DmaPort.cpp, DmaPort.h, Watchdog.cpp, acsi2stm.h]
2022-03-25 Stability improvements for STM32 clones. Split nosdcard and acsitest.
    [Acsi.cpp, DmaPort.cpp, DmaPort.h, acsi2stm.h, acsi2stm.ino]
2022-03-26 2.4c:More command tests,tiny fixes
    [Acsi.cpp, DmaPort.cpp, acsi2stm.h]
2022-04-05 2.41: [NOT] Fixed command handling in write mode. Does not work.
    [DmaPort.cpp, acsi2stm.h]
2022-04-05 2.42: Fix CS for real.
    [DmaPort.cpp, acsi2stm.h]
2022-04-09 2.43: ACSI_ACK_FILTER only on STM32->ST transfers
2022-04-12 2.44: Added a compile-time option to invert SD card write lock.
    [BlockDev.cpp, acsi2stm.h]
2022-04-13 3.0a: Integrated driver. Added RESET signal. Redone DMA port logic.
    [Acsi.cpp, Acsi.h, DmaPort.cpp, DmaPort.h, acsi2stm.h, acsi2stm.ino]
2022-04-13 3.0b: Still imperfect driver.
2022-04-15 3.0c: Print partitions. Bug fixes. Added ACSI_SD_WRITE_LOCK define.
    [Acsi.cpp, Acsi.h, acsi2stm.h]
2022-04-21 3.0e: Better hotswap and error handling
    [Acsi.cpp, Acsi.h, acsi2stm.h, acsi2stm.ino]
2022-05-15 3.0g: Work on tools, fixed driver bug.
    [PCB_ACSI2STM_EasyEDA.json, SCH_ACSI2STM_EasyEDA.json]
2022-05-16 3.0h: Replaced broken watchdog by a simple timeout timer.
    [Acsi.cpp, Acsi.h, BlockDev.cpp, DmaPort.cpp, DmaPort.h, Watchdog.cpp, acsi2stm.h, acsi2stm.ino]
2022-06-26 3.00: With an official driver and PCB
    [PCB_ACSI2STM_EasyEDA.json, SCH_ACSI2STM_EasyEDA.json]
2022-08-04 Added PCB for MegaSTE internal connector
    [ACSI2STM MegaSTE.kicad_pcb, ACSI2STM MegaSTE.kicad_sch]
2023-04-15 4.0b: Fixed most GemDrive issues, especially Pexec.
    [Acsi.cpp, Acsi.h, BlockDev.cpp, BlockDev.h, Devices.cpp, Devices.h, DmaPort.cpp, GemDrive.cpp]
2023-04-30 4.0c: Needs more bug fixes
    [GemDrive.cpp, acsi2stm.h]
2023-05-18 4.0d: ACSI tests okay. More SCSI fixes.
    [Acsi.cpp, Acsi.h, acsi2stm.h, acsi2stm.ino]
2023-05-21 4.0e: Added A1 workaround. Fixed disk image support. ACSI mode is final. Much progress in GemDrive mode.
    [Acsi.cpp, BlockDev.cpp, BlockDev.h, DmaPort.cpp, GemDrive.cpp, GemDrive.h, SysHook.cpp, Tos.h]
2023-06-04 Removed LONG access to DMA in syshook init. Simplified mediaId management. Removed dead code for useless FD cache.
2023-06-04 Fixed Dgetpath on root directory of a swapped drive.
    [GemDrive.cpp, GemDrive.h, acsi2stm.h]
2023-06-05 4.01: Small fixes in GemDrive and more tests
    [BlockDev.cpp, FlashFirmware.cpp, GemDrive.cpp, acsi2stm.h, acsi2stm.ino]
2023-07-14 Added Compact PCB. Blind fix for RTC.
    [BOM ACSI2STM Compact.csv, PCB ACSI2STM Compact EasyEda.json, Schematic ACSI2STM Compact EasyEda.json]
2023-07-16 4.2a: Need to test compact PCB.
    [BOM ACSI2STM Compact.csv]
2023-07-17 4.2b: EmuTOS, boot sector fix, documentation update.
    [acsi2stm.h]
2023-08-12 Updated PCB (new version untested). Added 3D printed enclosure. Doc updates again. Still has a date bug.
    [BOM - ACSI2STM Compact.csv, BOM ACSI2STM Compact.csv, Enclosure - ACSI2STM Compact.scad, Enclosure - ACSI2STM Compact.stl, PCB - ACSI2STM Compact.json, PCB ACSI2STM Compact EasyEda.json, PickAndPlace - ACSI2STM Compact.csv, Schematic - ACSI2STM Compact.json]
2023-08-12 Fixed date handling. Version bump.
    [Devices.cpp, GemDrive.cpp, acsi2stm.h]
2023-08-12 Added better oscilloscope traces in documentation.
2023-08-24 5.0a: Big rework for 5.00
    [BOM - ACSI2STM Compact.csv, Enclosure - ACSI2STM Compact.scad, Enclosure - ACSI2STM Compact.stl, PCB - ACSI2STM Compact.json, Schematic - ACSI2STM Compact.json]
2024-10-25 5.0b: Release candidate for final version
    [Enclosure - ACSI2STM Compact.scad, Enclosure - ACSI2STM Compact.stl]
2024-10-26 TT-RAM support,copyright bump,small fixes
    [Acsi.cpp, Acsi.h, BlockDev.cpp, BlockDev.h, Devices.cpp, Devices.h, DmaPort.cpp, DmaPort.h]
2024-10-26 Fixed bugs, speed optimization, 64k verbose firmware
    [Acsi.cpp, BlockDev.cpp, DmaPort.cpp, DmaPort.h, GEMDRIVE.boot.h, GemDrive.cpp, SysHook.cpp, SysHook.h]
2024-10-29 Removed (obsolete) full-featured PCB. Doc fixes.
2024-10-29 5.0d: PIO mode. Various bug fixes.
    [BlockDev.cpp, Devices.cpp, DmaPort.cpp, DmaPort.h, GEMDRIVE.boot.h, GemDrive.cpp, GemDrive.h, SysHook.cpp]
2024-10-30 Fix overrun in BSS memory clear
    [SysHook.cpp]
2024-11-02 5.0e: Fixed GemDrive boot. Removed some verbose logs to fit firmware in 64k.
    [Acsi.cpp, BlockDev.cpp, GEMDRIVE.boot.h, acsi2stm.h]
2024-11-08 Added multi device support for GEMDRIVE.PRG
2024-11-08 Minor fixes in GemDrive boot. Minor doc fixes.
    [BlockDev.cpp, Devices.cpp, GemDrive.cpp]
2024-11-09 Fixed a weird bug when using multiple ACSI2STM units. Doc updates.
    [DmaPort.cpp, acsi2stm.h]
2024-11-09 Improved ACSI perf when no SD. GemDrive init fix. Doc fix.
    [Acsi.cpp]
2024-11-10 Fix fast IRQ. Fix CS timeout. Adjust doc.
    [Acsi.cpp, BlockDev.cpp, DmaPort.cpp, DmaPort.h, SysHook.cpp]
2024-11-11 5.00: Professionally assembled PCB, EmuTOS, PIO mode, multiple devices and fixes
