retro16/acsi2stm/(notices)

Notices in the files:
acsi2stm/DmaPort.h:
This program is free software: you can redistribute it and/or modify
it under the terms of the GNU General Public License as published by
the Free Software Foundation, either version 3 of the License, or
(at your option) any later version.
pcb/MegaSTE Internal/ACSI2STM MegaSTE.kicad_pcb:
© SOJAVA 2022
